licardlu/pangoriscv/evidence/records/validation_20261104/dataset_metrics_partial/sample_01.png

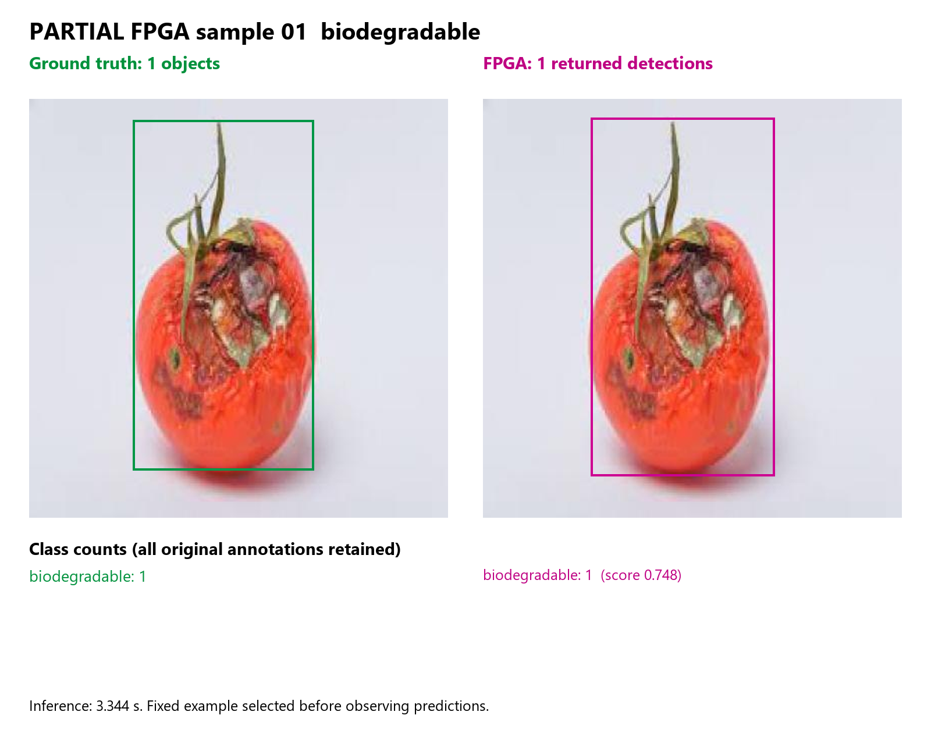
evidence/records/validation_20261104/dataset_metrics_partial/sample_01.png
