licardlu/pangoriscv/evidence/records/validation_20261104/dataset_metrics/sample_16.png

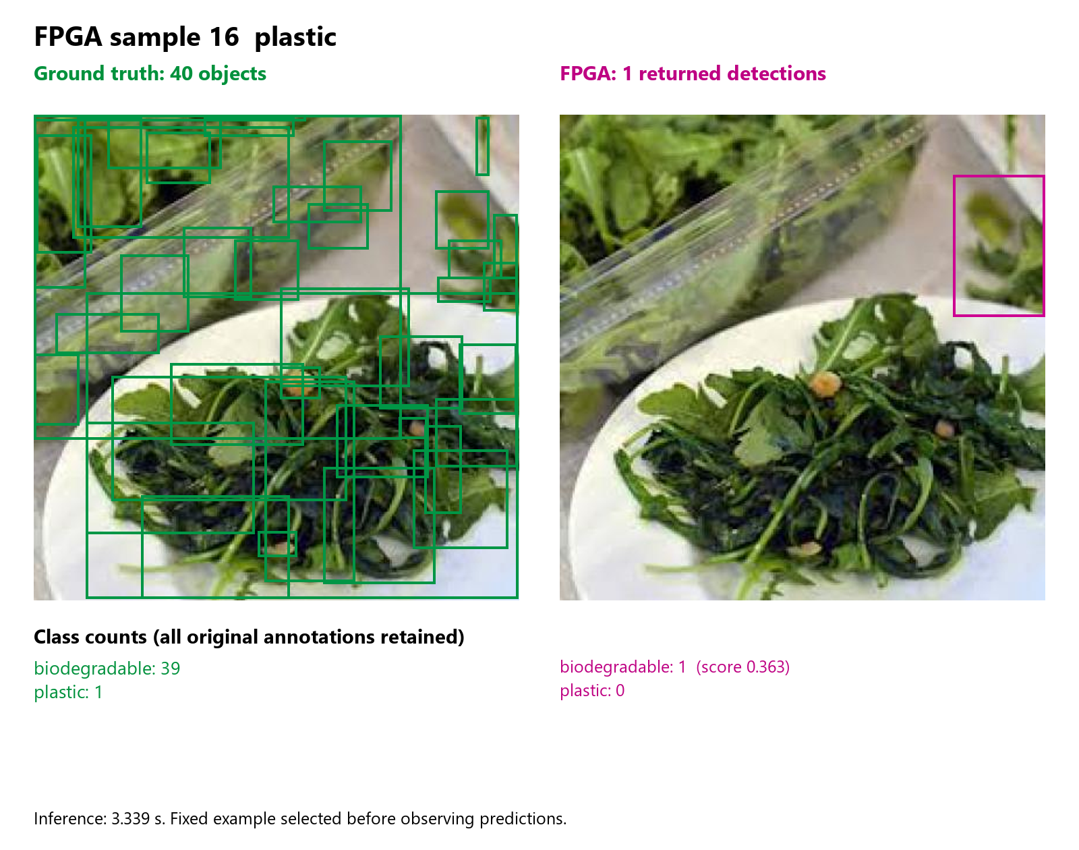
evidence/records/validation_20261104/dataset_metrics/sample_16.png
