licardlu/pangoriscv/extensions/yolo/README.md

# FPGA YOLO + CPU + AI Accelerator

## Current Board Status (2026-11-01)

- Target: MES2L676-100HP / PG2L100H; Vexii CPU and accelerator at 27 MHz.
- `release/board_perf4_20261101/`: programmed and tested. Model upload/CRC and
  camera inference replies pass; the latest camera request took 4.953 seconds.
- `release/board_perf5_20261101/`: newer optimized candidate. PDS timing and
  package verification pass; this candidate has not been board-tested.
- **HDMI remains blank on the user's monitor. Display acceptance has failed.**
  Neither release is a fully accepted contest deliverable.
- Model: YOLOv5n, 320 input, six classes: biodegradable, cardboard, glass,
  metal, paper, plastic. It has no hazardous-waste class.

## Files And Dependencies

- `rtl/`, `sw/`, `tb/`, `scripts/`: accelerator/SoC RTL, CPU firmware, tests,
  model export, quantization, packing, programming and board tools.
- `data/models/yolov5n-garbage.pt`: original selected checkpoint.
- `gen/integration/deployment/`: integer model parameters and graph contract.
- `gen/integration/packed/`: DDR model, memory map and generated C model table.
- `release/board_perf{4,5}_20261101/`: matched bitstream, firmware, model,
  constraints, timing evidence, checksums and standalone UART loader.
- `../project/pds_native_120/`: CPU checkout referenced by the Vexii generator.
- `../video/hdmi1080p/`: copied video source/IP/constraints; the camera generator
  prefers this repository copy over its historical absolute path.
- `pds/vexii_camera_20261101_{171914,181152}/sources/`: accepted source snapshots.
  Tool databases, downloaded datasets and installed Python packages are excluded.
- `STATUS.md`: results and limitations; T55 records the latest board state.

## 与其他目录的关系

**本目录是上游 AI 工程的快照，不是交付位流的源目录。** 阅读时请注意三点：

1. `extensions/yolo/rtl/`、`extensions/yolo/sw/` 是**上游候选件**，用来做可行性验证与
   离线仿真。真正被综合进 v3 交付位流的是
   `project/trash_sorting/source/yolo/sources/042_conv_band_rt.v` 与
   `project/trash_sorting/source/yolo/software/platform_main.c`（27 MHz 应用固件）。
2. `extensions/yolo/rtl/conv_band_rt.v` 与 `sources/042_conv_band_rt.v`
   **端口完全一致（37 个端口逐名相同），但时序不等价**：前者在 epilogue 阶段把
   quantize 拆成三级寄存器，多出 `S_EPI4 / S_EPI5 / S_EPI6` 三个状态
   （5'd20/21/22），每个输出通道因此多 3 个周期，且 requant 改为实例化
   `requant_q15` 模块；042 版在内联组合逻辑里一次算完，只有 `S_EPI3` 一个状态。
   两者功能预期相同、**逐周期行为不同**：拿本目录的 RTL 直接替换 042 会改变时延，
   并使历史仿真基线失效。**位流以 042 为准。**
3. `extensions/yolo/sw/platform_main.c` 与
   `project/trash_sorting/source/yolo/software/platform_main.c` **同名但不是一个程序**：
   前者 276 行，是 YAI1 静态图 bring-up + FP32 头 + `yolo_forward` 的仿真/候选固件；
   后者 324 行，是 27 MHz 板级应用固件（含 OSD 坐标换算与轮询上限）。
   板子上跑的是 `project/` 那一份，不要拿本目录的版本去解释板级行为。

`gen/integration/vexii_camera/`、`gen/integration/vexii_firmware/` 是 **93.461538 MHz**
的上游候选（`board_verified: false`），与 27 MHz v3 交付位流不是同一配置，见各自目录下的
`README.md`。

## Programming

> 本节沿用上游记录。**本快照没有 `release/`、`pds/`、`sim/`、`STATUS.md`**，
> 所以下面的 `package_release.py --verify --out release/...` 与 `pds/...` 路径在本包内
> 不可用；交付位流以仓库根 `README.md` 的交付章节与 `bitstream/` 为准，
> 这里只保留用于说明加载顺序。

Run from this directory with Python 3.11 and pyserial installed. First verify
`scripts/package_release.py --verify --out release/board_perf4_20261101`.
Start the PDS `cdt_js.exe` JTAG server on port 65420, then use
`scripts/program_board.py --sbit release/board_perf4_20261101/bitstream.sbit
--out sim/<unique-run>/program`.

After every FPGA/DDR reset, upload the model using
`scripts/board_loader.py --package-dir release/board_perf4_20261101 --port COM13`.
Then use the same command with `--skip-model --camera --frames 3` for camera
requests. Firmware is already embedded in the bitstream. The current video mode
is 1280x720@60, and the physical cable must use HDMI OUT.

外部工具路径不再写死在脚本里，按需用环境变量或命令行参数指定（见
`scripts/tool_paths.py`）：

| 工具 | 环境变量 | 命令行参数 | 默认值 |
|---|---|---|---|
| ModelSim `win64` | `MODELSIM_BIN` | `--modelsim` | `D:/modeltech64_10.6e/win64` |
| RISC-V GCC `bin` | `RISCV_GCC_BIN` | `--gcc` | 先查 `PATH`，再查 `C:/xpack-riscv-none-elf-gcc/bin` |
| PDS `bin` | `PDS_BIN` | `--pds` | `C:/pango/PDS_2022.2-SP6.1/bin` |
| CPU 源码 | `CPU_RTL` | `--cpu-rtl` | `../project/cpu120` |
| 视频模板 | `VIDEO_SRC` | `--video` | `../video/hdmi1080p` |

Model scripts also need NumPy, OpenCV, PyTorch, torchvision and the `yolov5`
checkpoint package. The standalone loader's dependencies are listed in each
release's `loader_requirements.txt`.

## Historical Workspace Notes

本目录只做赛题 AI 应用的小规模可行性验证，**独立于 `firmware/code`**：

- 不修改另一名 AI 正在处理的 CPU RTL、公共连接文件、`docs/` 下的正式文档；正式集成阶段才统一改公共文件。
- 下载串行进行，避免与另一 AI 争用下载工具；每个下载记录 URL、字节数、SHA256。
- 状态记录：本文件下方与 `STATUS.md`；错误写入 `logs/`；不建多份重复报告。
- 数据布局：`data/models/` 权重，`data/images/` 独立测试图片，`data/raw/` 原始包，`scripts/` 可复现脚本，`results/` 结果表与原始输出，`rtl/`、`tb/`、`sim/` 最小计算电路，`logs/` 运行日志。
- 数字标注：`实测`=本次运行/PDS 报告得到；`估计`=由实测或结构推算，不得写成已验证。

## 开始/完成/错误约定

| 状态 | 含义 | 记录位置 |
|---|---|---|
| RUNNING | 已开始、未完成 | `STATUS.md` 对应任务行 |
| DONE | 完成且有原始证据（日志/文件哈希/结果表） | `STATUS.md` + `results/` |
| FAILED | 失败，记录错误与下一步 | `STATUS.md` + `logs/` |

任务编号：T1 现成模型、T2 PC 对照、T3 YOLO-Fastest 逐层预算、T4 最小计算电路与 PDS、T5 固定图片 vs 摄像头边界、T6 集成约定。
