licardlu/pangoriscv/project/trash_sorting/资料包原始_00_请先阅读.md

# 青禾智能视觉垃圾分类：技术文档代码资料包

本包用于阅读关键代码、整理技术文档。包含完整的核心 RTL、板端 AI C 固件、模型描述及权重、外围 RTL、音频素材、测试代码、STM32 工程，以及两份按功能查找的说明。原始资料包里没有包含 PDS 安装程序、许可证、全量布局布线数据库、训练数据集和已生成位流；本次交付的仓库另含位流、时序报告与上板证据，以根目录 README 和 `docs/` 为准。

建议先读 [资料包原始_代码索引.md](资料包原始_代码索引.md)，再读 [资料包原始_技术文档编写要点.md](资料包原始_技术文档编写要点.md)；需要直接引用代码时看 [资料包原始_关键代码摘录.md](资料包原始_关键代码摘录.md)。文件来源与 SHA-256 见 `source/yolo/checksums.json` 与 `source/yolo/source_manifest.json`。

## 版本必须这样区分

原始包按 01~07 编号目录组织，本仓库已改放到下表位置；查文件时以本表为准。

| 原包目录 | 本仓库位置 | 用途与状态 |
| --- | --- | --- |
| 01_FPGA当前源码 | `source/yolo/`、`source/extensions/` | 打包时磁盘源码快照，保持 yolo / extensions 的相对目录结构；不是对当前板上全部源码的冻结复现 |
| 02_v4后续修改_未生成可烧录位流 | `variants/v4_source_only/` | 中文大字号标签、显示叠加层级及舵机统一方向等后续修改；没有可烧录 v4 位流，不得写为已上板验证 |
| 03_v3已烧录版本_局部源码与证据 | `variants/v3_programmed_reference/` | 最近真正烧录的 v3 顶层、视频前端、路由后时序报告和本次下载/推理记录；其余依赖当时未全量冻结，本目录不是完整重建包 |
| 04_AI模型处理与板端通信 | `../../extensions/yolo/scripts/` | 模型导出量化、打包、UART 协议与固件相关参考源码；实际 FPGA 编译输入优先看 `source/yolo/sources/` 的编号 RTL |
| 05_STM32舵机中继_当前工程快照 | `stm32_reference/` | 已有 Keil 工程的原样拷贝；本次只整理，未重新编译、未下载 STM32、未确认实板接线 |
| 07_历史参考 | 未随本次交付保留 | 原包中的历史修复记录与旧文档草稿未收录；引用旧版描述时以本包版本说明和实际代码为准 |

最近 FPGA 下载证据：`program: 1`、`JTAG_SCRIPT_DONE`；模型上传后板端 CRC 通过，两次摄像头推理响应均为空检测，随后已启动自主识别。这证明下载和推理通信流程完成，不证明识别准确率或舵机全部验收通过。SRAM 下载掉电失效，不等于开机自启动。烧录位流 SHA256 为 `2b98f90fbd0b4fd2de4074e74cb2c4aa8886d6009aa12bba4dfaf5d071bc4657`，见 `variants/v3_programmed_reference/最近重新烧录记录/result.json`。

## STM32 文档的冲突点，写技术文档时务必注意

STM32 当前文件仍标注蓝/灰/红/绿顺序，`SERVO_IN_MASK=0x0`、`SERVO_OUT_MASK=0xD`。而刚烧录的 v3 顶层明确为绿/红/灰/蓝物理顺序，`SERVO_REVERSED_MASK=4'b0101`。两者不能直接作为同一套已集成接线说明使用。这里保留原文件供解释中继原理，未擅自修改工程，也没有把它标为已经配套验收。

用户要求的后续目标是 STM32 各输出上电 0°，收到开盖命令后到 90°，保持 5 秒再到 0°，周期 20 ms。当前 STM32 源码还包含约 1 秒渐变以及输出反向掩码，不能将“目标”写成“当前四路已统一实现并验证”。

## 查看与发送

交付压缩包为 `pangoriscv_完整源码.rar`（RAR5 格式，34,065,293 字节），可作为文件发送；无需运行 PDS 或 Keil 才能查看源码。解压后用 VS Code、记事本或 Keil 阅读。包内 Tcl / Python 保留原始路径，有些指向作者电脑；这是技术文档资料包，没有在朋友电脑上验证一键构建。
