licardlu/pangoriscv/project/trash_sorting/资料包原始_代码索引.md

# 关键代码索引

行号对应本目录内文件。原资料包按 `01_FPGA当前源码`、`02_v4后续修改…`、`03_v3已烧录版本…` 等目录组织；在本仓库中已改放到 `source/`、`variants/v4_source_only/`、`variants/v3_programmed_reference/`，下表链接已换成当前位置。

| 功能 | 文件与入口行号 | 用途 |
| --- | --- | --- |
| 系统总连接与时钟复位 | [052_yolo_camera_top_camera_servo.v](variants/v3_programmed_reference/052_yolo_camera_top_camera_servo.v)：26 行 | 当前烧录版本的完整摄像头、AI、HDMI、按键、语音、舵机连接。 |
| 后续完整版连接与显示叠加 | [052_yolo_camera_top_camera_servo.v](variants/v4_source_only/052_yolo_camera_top_camera_servo.v)：753 行 | 对照 v3 查看后续修改；尚未上板。 |
| RISC-V 处理器核心 | [015_pango_replica_core.v](source/yolo/sources/015_pango_replica_core.v)：1 行 | 处理器 RTL；说明 CPU 如何执行推理控制与解码固件。 |
| CPU 与 AI 的 SoC 总线 | [040_vexii_ai_soc.v](source/yolo/sources/040_vexii_ai_soc.v)：6 行 | CPU、总线、UART 及加速器寄存器连接。 |
| 卷积加速计算 | [042_conv_band_rt.v](source/yolo/sources/042_conv_band_rt.v)：28 行 | 卷积数据流、带状处理与计算调度。 |
| 乘加阵列 | [043_mac_array.v](source/yolo/sources/043_mac_array.v)：16 行 | 并行乘法累加结构，是 FPGA AI 加速关键。 |
| 加速器寄存器接口 | [044_conv_engine_axil.v](source/yolo/sources/044_conv_engine_axil.v)：17 行 | CPU 写参数、启动运算、读取状态。 |
| DDR 与时钟域桥接 | [045_ddr_axi_bridge.v](source/yolo/sources/045_ddr_axi_bridge.v)：5 行 | 推理数据与外部内存连接；046/047 是相关 CDC。 |
| 摄像头帧捕获 | [048_camera_snapshot.v](source/yolo/sources/048_camera_snapshot.v)：4 行 | 把摄像头画面送入推理链路。 |
| 原生视频与检测框 | [049_video_ai_frontend_camera_repair.v](variants/v3_programmed_reference/049_video_ai_frontend_camera_repair.v)：4 行 | 当前上板版本的 OSD、结果保存与显示。 |
| 中文标签与顶层显示优先级修改 | [049_video_ai_frontend_camera_repair.v](variants/v4_source_only/049_video_ai_frontend_camera_repair.v)：393 行 | 24 像素中文类别标签、背景与边界处理；未生成位流。 |
| AI 客户端与外设结果通路 | [051_yolo_ai_client.v](source/yolo/sources/051_yolo_ai_client.v)：2 行 | 控制通信和 AI 结果访问；与固件协作。 |
| 固件主流程与板端命令 | [platform_main.c](source/yolo/software/platform_main.c)：234 行 | 模型上传校验、摄像头推理和自主运行命令入口。 |
| 网络算子运行时 | [yolo_runtime.c](source/yolo/software/yolo_runtime.c)：12 行 | CPU 调度硬件算子、数据布局和后处理辅助。 |
| 检测框解码 | [yolo_decode.c](source/yolo/software/yolo_decode.c)：5 行 | 检测头解码、置信度筛选及 NMS 等，具体实现以文件为准。 |
| 六类物体到垃圾桶映射 | [yolo_class_to_bin.v](source/extensions/business/application/rtl/yolo_class_to_bin.v)：7 行 | class0→厨余；class1~5→可回收，未训练有害/其他。 |
| 按键消抖 | [key_debounce4.sv](source/extensions/business/application/rtl/key_debounce4.sv)：2 行 | 机械按键同步、消抖与单次事件。 |
| 答题流程状态机 | [trash_quiz_controller.sv](source/extensions/business/application/rtl/trash_quiz_controller.sv)：48 行 | 识别后提问，按键比对；答错仍开正确桶，播放对应语音。 |
| 外围总装 | [trash_peripherals.sv](source/extensions/business/application/rtl/trash_peripherals.sv)：2 行 | 按键、答题、舵机触发与状态快照。 |
| 四路舵机 PWM | [servo_pwm4.sv](source/extensions/business/application/rtl/servo_pwm4.sv)：20 行 | 50 Hz，500/1500 us，250 帧保持；实例参数决定反向。 |
| 提示/正确/错误语音 ROM | [trash_voice_rom_player.v](source/extensions/business/application/rtl/trash_voice_rom_player.v)：5 行 | PCM ROM 读出、事件播放和状态。 |
| I2S 音频输出 | [trash_i2s_tx.v](source/extensions/business/application/rtl/trash_i2s_tx.v)：6 行 | PCM 串行化成 BCLK/LRCLK/DATA。 |
| HDMI 音频芯片配置 | [ms7210_audio_init.v](source/extensions/business/application/rtl/ms7210_audio_init.v)：17 行 | 通过寄存器初始化音频通道。 |
| 白色标题栏与实时视频合成 | [light_split_video.sv](source/extensions/business/application/rtl/light_split_video.sv)：5 行 | 标题区域、视频以及叠加图层组合；配合 ui_light_panel。 |
| 物理引脚约束 | [camera.fdc](source/yolo/sources/camera.fdc)：1029 行 | 板级 IO 球号和电平标准；J3 排针还需实际转接板对应。 |
| UART 模型上传与控制协议 | [board_loader.py](../../extensions/yolo/scripts/board_loader.py)：49 行 | YAI1 请求、YAR1 响应、CRC 和模型传输。 |
| 模型打包 | [pack_deployment.py](../../extensions/yolo/scripts/pack_deployment.py)：18 行 | 模型与内存地址信息生成，配合 memory_map.json。 |
| STM32 四路中继 | [main.c](stm32_reference/Core/Src/main.c)：253 行 | 采样 FPGA PWM 并由 TIM2 四通道重生 PWM；现有掩码/颜色与 v3 有冲突，见总说明。 |
