licardlu/pangoriscv/project/trash_sorting/资料包原始_关键代码摘录.md

# 关键代码摘录

以下为原文件片段，便于技术文档引用。代码未作改写；完整上下文见对应文件，实际验证边界见 `资料包原始_00_请先阅读.md`。

## 系统总连接与时钟复位

文件：`variants/v3_programmed_reference/052_yolo_camera_top_camera_servo.v`，第 24–47 行。当前烧录版本的完整摄像头、AI、HDMI、按键、语音、舵机连接。

```verilog
`define CMOS_2      //cmos2作为视频输入；

module yolo_camera_top#(
	parameter PERIPHERAL_TEST_MODE = 0          ,//0=live camera quiz; 1=fixed answer1 diagnostics
	parameter MEM_ROW_ADDR_WIDTH   = 15         ,
	parameter MEM_COL_ADDR_WIDTH   = 10         ,
	parameter MEM_BADDR_WIDTH      = 3          ,
	parameter MEM_DQ_WIDTH         =  32        ,
	parameter MEM_DQS_WIDTH        =  32/8
)(
	input wire uart_rxd,
	input                                sys_clk              ,//27MHz
    input                                clk_p ,
    input                                clk_n ,
//OV5640
    output  [1:0]                        cmos_init_done       ,//OV5640寄存器初始化完成
    //coms1	
    inout                                cmos1_scl            ,//cmos1 i2c 
    inout                                cmos1_sda            ,//cmos1 i2c 
    input                                cmos1_vsync          ,//cmos1 vsync
    input                                cmos1_href           ,//cmos1 hsync refrence,data valid
    input                                cmos1_pclk           ,//cmos1 pxiel clock
    input   [7:0]                        cmos1_data           ,//cmos1 data
    output                               cmos1_reset          ,//cmos1 reset
```

## 后续完整版连接与显示叠加

文件：`variants/v4_source_only/052_yolo_camera_top_camera_servo.v`，第 751–774 行。对照 v3 查看后续修改；尚未上板。

```verilog
    // User order: key/bin 1 green, 2 red, 3 gray, 4 blue.
    // Physical [0..3]: U16 green, U15 red, AC26 gray, AB26 blue.
    assign servo_pwm = logical_servo_pwm;
    wire peripheral_voice_valid;
    wire [2:0] peripheral_voice_asset;
    wire raw_result_commit,raw_result_valid;
    wire [7:0] raw_result_class_id;
    wire [3:0] raw_result_count;
    wire camera_bin_valid;
    wire [2:0] camera_bin_code;
    wire audio_busy,audio_playback_done;
    yolo_class_to_bin camera_category(
        .result_valid(raw_result_valid),.result_class_id(raw_result_class_id),
        .bin_valid(camera_bin_valid),.bin_code(camera_bin_code));
    trash_peripherals #(.CLK_HZ(27000000),.DEBOUNCE_MS(20),.OPEN_MS(5000),
        .TEST_MODE(PERIPHERAL_TEST_MODE),.SERVO_REVERSED_MASK(4'b0000)) application_peripherals(
        .clk(sys_clk),.rst(!peripheral_reset[1]),.start_ready(hdmi_ready_sync[1]),.key_n(key_n),
        .detect_event(raw_result_commit),.bin_valid(camera_bin_valid),.bin_code(camera_bin_code),
        .servo_pwm(logical_servo_pwm),.open_state(servo_open_state),
        .voice_valid(peripheral_voice_valid),.voice_asset_id(peripheral_voice_asset),
        .snapshot(application_snapshot));
    trash_voice_i2s #(.CLK_HZ(27000000)) application_voice(
        .clk(sys_clk),.rst(!peripheral_reset[1]),
        .request_valid(peripheral_voice_valid),.request_asset_id(peripheral_voice_asset),
```

## RISC-V 处理器核心

文件：`source/yolo/sources/015_pango_replica_core.v`，第 1–22 行。处理器 RTL；说明 CPU 如何执行推理控制与解码固件。

```verilog
// Source-extraction compilation-unit preamble (not reference payload).
`timescale 1ns/1ps
`include "sections/000_FetchL1Plugin.vh"
`include "sections/001_FetchL1Plugin.vh"
`include "sections/002_DispatchPlugin.vh"
`include "sections/003_LsuL1Plugin.vh"
`include "sections/004_CsrAccessPlugin.vh"
`include "sections/005_PerformanceCounterPlugin.vh"
`include "sections/006_execute_pipeline.vh"
`include "sections/007_PrefetcherRptPlugin.vh"
`include "sections/008_execute_pipeline.vh"
`include "sections/009_PrefetcherRptPlugin.vh"
`include "sections/010_FetchL1Plugin.vh"
`include "sections/011_AlignerPlugin.vh"
`include "sections/012_AlignerPlugin.vh"
`include "sections/013_DispatchPlugin.vh"
`include "sections/014_DispatchPlugin.vh"
`include "sections/015_LsuL1Plugin.vh"
`include "sections/016_LsuL1Plugin.vh"
`include "sections/017_LsuPlugin.vh"
`include "sections/018_WhiteboxerPlugin.vh"
`include "sections/019_AlignerPlugin.vh"
```

## CPU 与 AI 的 SoC 总线

文件：`source/yolo/sources/040_vexii_ai_soc.v`，第 4–27 行。CPU、总线、UART 及加速器寄存器连接。

```verilog
`timescale 1ns/1ps

module vexii_ai_soc (
  input  wire          socCtrl_systemClk,
  input  wire          socCtrl_asyncReset,
  output wire          system_peripheral_uart_logic_uart_txd,
  input  wire          system_peripheral_uart_logic_uart_rxd,
  output wire [7:0]    system_peripheral_demo_logic_leds,
  input  wire [0:0]    system_peripheral_demo_logic_buttons,
  output wire [31:0] ai_awaddr, ai_wdata, ai_araddr,
  output wire [3:0] ai_wstrb,
  output wire ai_awvalid, ai_wvalid, ai_arvalid, ai_bready, ai_rready,
  input wire ai_awready, ai_wready, ai_arready, ai_bvalid, ai_rvalid,
  input wire [1:0] ai_bresp, ai_rresp,
  input wire [31:0] ai_rdata,
  output wire ai_resetn

);

  wire ai_hit;
  reg peripheral_pending, peripheral_ai;
  wire ai_tl_ready, ai_tl_valid, ai_tl_denied, ai_tl_corrupt;
  wire [2:0] ai_tl_opcode;
  wire [5:0] ai_tl_source;
```

## 卷积加速计算

文件：`source/yolo/sources/042_conv_band_rt.v`，第 26–49 行。卷积数据流、带状处理与计算调度。

```verilog
`timescale 1ns/1ps

module conv_band_rt #(
    parameter integer BANDW = 7168,    // band buffer, 64-bit words (56 KiB)
    parameter integer WBANK = 576,      // words per weight bank (K*K*CSL max)
    parameter integer TRM   = 8
)(
    input  wire        clk,
    input  wire        rstn,
    input  wire        start,
    output reg         busy,
    output reg         done,
    output reg         err,
    output reg  [31:0] cycles,

    input  wire [15:0] p_cin,       // channels actually present (multiple of 8)
    input  wire [15:0] p_cout,
    input  wire [15:0] p_in_w,
    input  wire [15:0] p_in_h,
    input  wire [15:0] p_out_w,
    input  wire [15:0] p_out_h,
    input  wire [7:0]  p_k,
    input  wire [7:0]  p_stride,
    input  wire [7:0]  p_pad,
```

## 乘加阵列

文件：`source/yolo/sources/043_mac_array.v`，第 14–37 行。并行乘法累加结构，是 FPGA AI 加速关键。

```verilog
`timescale 1ns/1ps

module mac_array #(
    parameter integer L = 8,        // activation lanes = taps consumed per cycle
    parameter integer C = 8         // output channels computed in parallel
)(
    input  wire                clk,
    input  wire                rstn,

    input  wire                clear,      // synchronous: load bias, zero the rest
    input  wire                valid,      // one K-slice this cycle
    input  wire [C*32-1:0]     bias_bus,   // per output channel, int32
    input  wire [L*8-1:0]      a_bus,      // L int8 activations
    input  wire [C*L*8-1:0]    w_bus,      // C x L int8 weights

    output wire [C*32-1:0]     sum_bus     // C int32 partial sums (combinational)
);

    // Flat storage: element (oc, lane) lives at oc*L + lane.  Declared at module
    // scope because PDS rejects declarations inside procedural blocks
    // (Verilog-4109) and flat indexing keeps the generate blocks trivial.
    reg signed [31:0] acc [0:C*L-1];

    genvar go, gl;
```

## 加速器寄存器接口

文件：`source/yolo/sources/044_conv_engine_axil.v`，第 15–38 行。CPU 写参数、启动运算、读取状态。

```verilog
`timescale 1ns/1ps

module conv_engine_axil #(
    parameter integer BANDW = 7168,    // band buffer, 64-bit words (56 KiB)
    parameter integer WBANK = 576,      // words per weight bank
    parameter integer TRM   = 8
)(
    input  wire        clk,
    input  wire        rstn,
    output reg         vid_wr_en,
    output reg [7:0]   vid_wr_addr,
    output reg [31:0]  vid_wr_data,
    output wire [7:0]  vid_rd_addr,
    input wire [31:0]  vid_rd_data,

    // ---- AXI4-Lite slave: control / status ----
    input  wire [7:0]  s_awaddr,
    input  wire        s_awvalid,
    output wire        s_awready,
    input  wire [31:0] s_wdata,
    input  wire        s_wvalid,
    output wire        s_wready,
    output wire [1:0]  s_bresp,
    output wire        s_bvalid,
```

## DDR 与时钟域桥接

文件：`source/yolo/sources/045_ddr_axi_bridge.v`，第 3–26 行。推理数据与外部内存连接；046/047 是相关 CDC。

```verilog
// The word-address convention is configurable and still requires board BIST.
`timescale 1ns/1ps
module ddr_axi_bridge #(
    parameter integer DDR_ADDR_SHIFT = 2
) (
    input wire clk, rstn,
    input wire [31:0] s_awaddr,
    input wire s_awvalid,
    output wire s_awready,
    input wire [63:0] s_wdata,
    input wire [7:0] s_wstrb,
    input wire s_wvalid,
    output wire s_wready,
    output reg [1:0] s_bresp,
    output reg s_bvalid,
    input wire s_bready,
    input wire [31:0] s_araddr,
    input wire s_arvalid,
    output wire s_arready,
    output reg [63:0] s_rdata,
    output reg [1:0] s_rresp,
    output reg s_rvalid,
    input wire s_rready,
    output reg [27:0] m_awaddr,
```

## 摄像头帧捕获

文件：`source/yolo/sources/048_camera_snapshot.v`，第 2–25 行。把摄像头画面送入推理链路。

```verilog
// until it requests another frame. Both RAM ports have synchronous reads/writes.
`timescale 1ns/1ps
module camera_snapshot #(
    parameter integer IN_W=1280, IN_H=720, STEP=4,
    parameter integer OUT_W=IN_W/STEP, OUT_H=IN_H/STEP
) (
    input wire cpu_clk,cpu_rstn,request,
    input wire [15:0] read_address,
    output reg [15:0] read_data,
    output reg busy,ready,error,
    output reg [15:0] frame_id,
    input wire cam_clk,cam_rstn,vsync,de,
    input wire [15:0] pixel
);
    reg [15:0] memory[0:OUT_W*OUT_H-1];
    reg req_toggle,done_toggle;
    reg [1:0] req_sync,done_sync;
    reg done_seen,req_seen,pending,active,vs_d,de_d,cam_error;
    reg [15:0] x,y,write_index,frame_counter,frozen_id;
    wire frame_start=vs_d && !vsync;
    always @(posedge cpu_clk) begin
        if(read_address<OUT_W*OUT_H) read_data<=memory[read_address];
        else read_data<=0;
        if(!cpu_rstn) begin
```

## 原生视频与检测框

文件：`variants/v3_programmed_reference/049_video_ai_frontend_camera_repair.v`，第 2–25 行。当前上板版本的 OSD、结果保存与显示。

```verilog
// stable across CDC until the pixel domain acknowledges it.
`timescale 1ns/1ps
module video_ai_frontend #(
    // Number of display frames for which the last detection remains visible
    // after the first explicitly empty inference. Slow inference alone must
    // not erase a valid result. The board wrapper sets a frame-rate-specific
    // TTL: 60 frames at 30 Hz, or 120 frames at 60 Hz, gives two seconds.
    parameter integer RESULT_TTL=60,
    // Keep text enabled for the reusable frontend and unit-test contract.
    // Board-level generators may explicitly disable it on timing-sensitive
    // pixel paths.
    parameter integer OSD_TEXT=1,
    parameter integer OSD_BORDER=4,
    // Optional debug capture guide. Keep it disabled in normal operation so
    // expiry removes every rectangle rather than showing a false detection.
    parameter integer GUIDE_ENABLE=0,
    // Centered 320x320 capture guide for the no-detection state. These
    // defaults match the 1280x720 HDMI raster and can be overridden by a
    // board-level wrapper without changing the MMIO protocol.
    parameter integer GUIDE_X1=480,
    parameter integer GUIDE_Y1=200,
    parameter integer GUIDE_X2=799,
    parameter integer GUIDE_Y2=519,
    // Visible source range after an optional downstream center crop. A box
```

## 中文标签与顶层显示优先级修改

文件：`variants/v4_source_only/049_video_ai_frontend_camera_repair.v`，第 391–414 行。24 像素中文类别标签、背景与边界处理；未生成位流。

```verilog
    reg [3:0] glyph_id;
    reg [11:0] glyph_bits;
    localparam integer LABEL_SCALE=2;
    localparam integer LABEL_PAD=4;
    localparam integer LABEL_HEIGHT=32;
    always @(*) begin
        pix_out=pix_in;
        detection_valid=0;
        draw_top=0;label_x=0;label_y=0;label_w=0;label_len=0;
        label_dx=0;label_dy=0;label_col=0;label_row=0;label_index=0;
        category_kind=0;glyph_id=0;glyph_bits=0;
        for(b=0;b<8;b=b+1) begin
            draw_top=box_xy1[b][31:16];
            if(box_class[b][31] && box_xy2[b][15:0]>=VIEW_X1 &&
               box_xy1[b][15:0]<=VIEW_X2) detection_valid=1;
            // The opaque UI header owns rows [0, HEADER_HEIGHT). Clip a
            // detection's visible top edge to the live-video area below it.
            if(pix_de && box_class[b][31] &&
               x>=box_xy1[b][15:0] && x<=box_xy2[b][15:0] &&
               y>=box_xy1[b][31:16] && y<=box_xy2[b][31:16]) begin
                if(x<box_xy1[b][15:0]+OSD_BORDER ||
                   x+OSD_BORDER>box_xy2[b][15:0] ||
                   y<box_xy1[b][31:16]+OSD_BORDER || y+OSD_BORDER>box_xy2[b][31:16])
                    pix_out=class_color(box_class[b][2:0]);
```

## AI 客户端与外设结果通路

文件：`source/yolo/sources/051_yolo_ai_client.v`，第 1–23 行。控制通信和 AI 结果访问；与固件协作。

```verilog
// Generated client: CPU clock is supplied by the integration top.
module yolo_ai_client #(
    parameter PROGRAM_INIT_FILE="",DATA_INIT_FILE=""
) (
    input wire clk_sys,core_clk,rstn,ddr_rstn,uart_rxd,
    output wire uart_txd,vid_wr_en,
    output wire [7:0] vid_wr_addr,vid_rd_addr,
    output wire [31:0] vid_wr_data,
    input wire [31:0] vid_rd_data,
    output wire [27:0] d3_awaddr,d3_araddr,
    output wire [3:0] d3_awlen,d3_arlen,
    output wire d3_awvalid,d3_arvalid,
    input wire d3_awready,d3_arready,
    output wire [255:0] d3_wdata,
    output wire [31:0] d3_wstrb,
    output wire d3_wvalid,d3_rready,
    input wire d3_wready,d3_wusero_last,d3_rvalid,d3_rlast,
    input wire [255:0] d3_rdata
);
    // ---- accelerator DDR path, all in clk_sys ------------------------------
    wire [31:0]  acc_araddr, acc_awaddr;
    wire         acc_arvalid, acc_awvalid;
    wire         acc_arready, acc_awready;
```

## 固件主流程与板端命令

文件：`source/yolo/software/platform_main.c`，第 232–255 行。模型上传校验、摄像头推理和自主运行命令入口。

```c
    return status;
}
int main(void)
{
    unsigned char header[16],payload[256];
    uint32_t limit=POLL_LIMIT;
    yolo_io_t io={
        .context=&limit,.read64=yolo_acc_read,.write64=yolo_acc_write,
        .convolve=yolo_acc_convolve,.read_bulk=yolo_acc_read_bulk,
        .write_bulk=yolo_acc_write_bulk
    };
#ifdef VEXII_PLATFORM
    UART[2]=CPU_HZ/(115200u*8u)-1u;
    UART[3]=7;
#else
    UART[2]=(CPU_HZ+57600u)/115200u-1u;
    UART[0]=3;
#endif
#ifdef VEXII_SIM_PRELOAD
    model_verified=1;
    input_loaded=320u*320u*8u;
#endif
    for(;;) {
        uint32_t i,address,expected,crc;
```

## 网络算子运行时

文件：`source/yolo/software/yolo_runtime.c`，第 10–33 行。CPU 调度硬件算子、数据布局和后处理辅助。

```c
#if defined(VEXII_PLATFORM) || !defined(__riscv)
#define YOLO_CACHED_RUNTIME 1
static union {
    int32_t head_q24[8][256];
    int16_t head_q16[4096];
    int8_t pool[5][1536];
    unsigned char scale_lut[4][256];
    struct {
        int32_t whole[2][256];
        uint32_t fraction[2][256];
    } add;
} scratch;
static int8_t head_input[256];
#endif

static int8_t clip(int64_t v)
{
    return v > 127 ? 127 : v < -128 ? -128 : (int8_t)v;
}

static int64_t rounded_q24(int64_t v)
{
    uint64_t magnitude = v < 0 ? (uint64_t)(-v) : (uint64_t)v;
    int64_t result = (int64_t)((magnitude + (1u << 23)) >> 24);
```

## 检测框解码

文件：`source/yolo/software/yolo_decode.c`，第 3–26 行。检测头解码、置信度筛选及 NMS 等，具体实现以文件为准。

```c
#include <string.h>

static float sigmoid(float x)
{
    if(x>=16) return 1;
    if(x<=-16) return 0;
    return 1.0f/(1.0f+expf(-x));
}
static float overlap(const yolo_box_t *a,const yolo_box_t *b)
{
    float x1=fmaxf(a->x1,b->x1),y1=fmaxf(a->y1,b->y1);
    float x2=fminf(a->x2,b->x2),y2=fminf(a->y2,b->y2);
    float area=fmaxf(0,x2-x1)*fmaxf(0,y2-y1);
    float total=(a->x2-a->x1)*(a->y2-a->y1)+(b->x2-b->x1)*(b->y2-b->y1)-area;
    return total>0 ? area/total : 0;
}
static void insert(yolo_box_t *list,uint16_t *count,uint32_t capacity,yolo_box_t box)
{
    uint32_t at=*count;
    if(at==capacity) {
        if(box.score<=list[at-1].score) return;
        at--;
    } else (*count)++;
    while(at && box.score>list[at-1].score) {
```

## 六类物体到垃圾桶映射

文件：`source/extensions/business/application/rtl/yolo_class_to_bin.v`，第 5–28 行。class0→厨余；class1~5→可回收，未训练有害/其他。

```verilog
// Keep this module independent of key/servo testing. Configure the six
// parameters only when the deployed label policy or model has been checked.
module yolo_class_to_bin #(
    parameter [2:0] CLASS0_BIN=3'd1,
    parameter [2:0] CLASS1_BIN=3'd4,
    parameter [2:0] CLASS2_BIN=3'd4,
    parameter [2:0] CLASS3_BIN=3'd4,
    parameter [2:0] CLASS4_BIN=3'd4,
    parameter [2:0] CLASS5_BIN=3'd4
)(
    input wire result_valid,
    input wire [7:0] result_class_id,
    output reg bin_valid,
    output reg [2:0] bin_code
);
    reg [2:0] configured_bin;
    always @(*) begin
        case(result_class_id)
            8'd0:configured_bin=CLASS0_BIN;
            8'd1:configured_bin=CLASS1_BIN;
            8'd2:configured_bin=CLASS2_BIN;
            8'd3:configured_bin=CLASS3_BIN;
            8'd4:configured_bin=CLASS4_BIN;
            8'd5:configured_bin=CLASS5_BIN;
```

## 按键消抖

文件：`source/extensions/business/application/rtl/key_debounce4.sv`，第 1–23 行。机械按键同步、消抖与单次事件。

```verilog
// Four active-low asynchronous buttons. Each stable press generates one pulse.
module key_debounce4 #(
    parameter integer CLK_HZ = 50000000,
    parameter integer DEBOUNCE_MS = 20
)(
    input logic clk, rst,
    input logic [3:0] key_n,
    output logic [3:0] key_event
);
    // Split the multiply so 120 MHz * 20 ms cannot overflow a signed integer.
    localparam integer CYCLES = (CLK_HZ / 1000) * DEBOUNCE_MS +
        (((CLK_HZ % 1000) * DEBOUNCE_MS + 999) / 1000);
    localparam integer CW = (CYCLES < 2) ? 1 : $clog2(CYCLES + 1);
    (* ASYNC_REG="TRUE" *) logic [3:0] key_meta, key_sync;
    logic [3:0] pressed;
    logic [CW-1:0] count[0:3];
    integer i;
    always_ff @(posedge clk) begin
        if(rst) begin
            key_meta <= 4'hf; key_sync <= 4'hf; pressed <= 0; key_event <= 0;
            for(i=0;i<4;i=i+1) count[i] <= 0;
        end else begin
            key_meta <= key_n; key_sync <= key_meta; key_event <= 0;
```

## 答题流程状态机

文件：`source/extensions/business/application/rtl/trash_quiz_controller.sv`，第 46–69 行。识别后提问，按键比对；答错仍开正确桶，播放对应语音。

```verilog
            end
            if(start_ready && !startup) case(state)
                IDLE: if(detect_event && bin_valid && bin_code>=1 && bin_code<=4) begin
                    correct<=bin_code-1'b1; state<=WAIT_ANSWER;
                    voice_valid<=1; voice_asset_id<=1;
                end
                WAIT_ANSWER: if(|key_event) begin
                    choice<=key_index; state<=ANSWERED;
                    // Always open the correct bin, including on wrong answers.
                    // Direct four-channel diagnostics use servo_key_controller.
                    servo_trigger<=4'b0001<<correct;
                    voice_valid<=1;
                    voice_asset_id<=(key_index==correct)?3'd2:3'd3;
                    opened_seen<=0;
                end
                ANSWERED: begin
                    if(|servo_open_state) opened_seen<=1;
                    // Use feedback, not a second independent 5s timer. PWM
                    // opens on its next 20ms boundary; a parallel timer could
                    // otherwise repeat the prompt before the lid has closed.
                    if(opened_seen && !(|servo_open_state)) begin
                        opened_seen<=0;
                        if(TEST_MODE) begin
                            state<=WAIT_ANSWER;correct<=0;
```

## 外围总装

文件：`source/extensions/business/application/rtl/trash_peripherals.sv`，第 1–23 行。按键、答题、舵机触发与状态快照。

```verilog
// Camera-driven quiz peripherals; TEST_MODE=1 enables standalone diagnostics.
module trash_peripherals #(
    parameter integer CLK_HZ=50000000,
    parameter integer DEBOUNCE_MS=20,
    parameter integer OPEN_MS=5000,
    parameter integer TEST_MODE=0,
    parameter logic [3:0] SERVO_REVERSED_MASK=4'b0000
)(
    input wire clk,rst,start_ready,
    input wire [3:0] key_n,
    input wire detect_event,bin_valid,
    input wire [2:0] bin_code,
    output wire [3:0] servo_pwm,open_state,
    output wire voice_valid,
    output wire [2:0] voice_asset_id,
    output wire [127:0] snapshot
);
    wire [3:0] key_event,servo_trigger;
    key_debounce4 #(.CLK_HZ(CLK_HZ),.DEBOUNCE_MS(DEBOUNCE_MS)) buttons(
        .clk(clk),.rst(rst),.key_n(key_n),.key_event(key_event));
    trash_quiz_controller #(.TEST_MODE(TEST_MODE)) control(
        .clk(clk),.rst(rst),.start_ready(start_ready),.key_event(key_event),
        .servo_open_state(open_state),.detect_event(detect_event),
```

## 四路舵机 PWM

文件：`source/extensions/business/application/rtl/servo_pwm4.sv`，第 18–41 行。50 Hz，500/1500 us，250 帧保持；实例参数决定反向。

```verilog
    output logic [3:0] open_state
);
    localparam integer PERIOD = CLK_HZ / 50;
    localparam integer PULSE_0 = CLK_HZ / 2000; // 0.5 ms
    localparam integer PULSE_90 = (CLK_HZ * 3) / 2000; // 1.5 ms
    localparam integer CW = (PERIOD < 2) ? 1 : $clog2(PERIOD);
    localparam integer FW = (OPEN_FRAMES < 2) ? 1 : $clog2(OPEN_FRAMES + 1);
    logic [CW-1:0] period_count;
    logic [FW-1:0] remaining [0:3];
    logic [3:0] trigger_d;
    logic [3:0] trigger_pending;
    integer i;

    always_ff @(posedge clk) begin
        if (rst) begin
            period_count <= '0;
            trigger_d <= '0;
            trigger_pending <= '0;
            pwm <= '0;
            open_state <= '0;
            for (i = 0; i < 4; i = i + 1) remaining[i] <= '0;
        end else begin
            trigger_d <= trigger;
            for (i = 0; i < 4; i = i + 1)
```

## 提示/正确/错误语音 ROM

文件：`source/extensions/business/application/rtl/trash_voice_rom_player.v`，第 3–26 行。PCM ROM 读出、事件播放和状态。

```verilog
// the pending stream; an invalid request is ignored.  ready consumes one
// 48-kHz mono sample (each stored 16-kHz PCM8 sample repeats three times).
module trash_voice_rom_player #(
    parameter ROM_FILE = "../../extensions/business/application/assets/audio_rom/voice_pcm8.hex",
    parameter integer ROM_SAMPLES = 115576,
    parameter integer PROMPT_START = 0,      PROMPT_LENGTH = 37192,
    parameter integer CORRECT_START = 37192, CORRECT_LENGTH = 40392,
    parameter integer WRONG_START = 77584,   WRONG_LENGTH = 37992
)(
    input wire clk, rst,
    input wire request_valid,
    input wire [2:0] request_asset_id,
    input wire sample_ready,
    output wire sample_valid,
    output wire [15:0] sample_pcm,
    output wire sample_last,
    output reg busy
);
    // Keep each inferred memory within one native 18K block. A single deep
    // ROM can infer cascaded DRM36K pairs whose identical lower halves PDS
    // merges, creating illegal COUTA fanout. Explicit banks use a fabric mux
    // and cannot require those dedicated cascade connections.
    localparam integer BANK_AW = 11;
    localparam integer BANK_SIZE = 1 << BANK_AW;
```

## I2S 音频输出

文件：`source/extensions/business/application/rtl/trash_i2s_tx.v`，第 4–27 行。PCM 串行化成 BCLK/LRCLK/DATA。

```verilog
// default).  Edge quantization is <= one sys_clk period.  For a codec that
// requires low-jitter MCLK, use an audio PLL instead of this CE clock source.
module trash_i2s_tx #(
    parameter integer CLK_HZ = 50000000,
    parameter integer SAMPLE_HZ = 48000
)(
    input wire clk, rst,
    input wire sample_valid,
    input wire [15:0] sample_pcm,
    input wire sample_last,
    output wire sample_ready,
    output reg bclk, lrclk, sdout,
    output reg frame_active,
    output reg playback_done
);
    localparam integer EDGE_HZ = SAMPLE_HZ * 128;
    reg [31:0] phase;
    wire [32:0] phase_sum = {1'b0, phase} + EDGE_HZ;
    wire edge_tick = phase_sum >= CLK_HZ;
    reg [5:0] bit_index;
    reg [15:0] frame;
    reg frame_last;
    wire [5:0] next_bit = bit_index + 1'b1;
    // A sample is consumed at the falling edge starting the left channel.
```

## HDMI 音频芯片配置

文件：`source/extensions/business/application/rtl/ms7210_audio_init.v`，第 15–38 行。通过寄存器初始化音频通道。

```verilog
// That driver does not document I2S slot/BCLK ratios; do not infer an extra
// MCLK or a proven 32/64-fs requirement from this register sequence.
module ms7210_audio_init #(
    parameter integer ENABLE=1
)(
    input wire clk,
    input wire rstn,
    input wire busy,
    input wire [7:0] data_out,
    input wire byte_over,
    output reg [15:0] addr,
    output reg [7:0] data_in,
    output reg w_r,
    output reg iic_trig,
    output reg init_over,
    output wire [7:0] device_id
);
    assign device_id=8'hb2;
    localparam [3:0] LOAD=0,READ_LAUNCH=1,READ_ACCEPT=2,READ_WAIT=3,
        WRITE_LAUNCH=4,WRITE_ACCEPT=5,WRITE_WAIT=6,DONE=7;
    localparam [4:0] LAST_STEP=29;
    // Numeric addresses are independently checked against the pinned header
    // by tools/test_ms7210_register_contract.py.
    localparam [15:0] MS7210_HDMI_TX_MISC_HDMI_RST_REG=16'h000b;
```

## 白色标题栏与实时视频合成

文件：`source/extensions/business/application/rtl/light_split_video.sv`，第 3–26 行。标题区域、视频以及叠加图层组合；配合 ui_light_panel。

```verilog
// Header covers the first source rows; no scaling or frame RAM is required.
// HS/VS/DE, selection and both RGB paths have two clocks of latency.
module light_split_video #(
    parameter integer HEADER_HEIGHT = 112,
    parameter BG = "ui_light_bg.hex",
    parameter PAL = "ui_light_palette.hex",
    parameter STATUS = "ui_light_status.hex"
) (
    input logic clk,rst,hs_in,vs_in,de_in,
    input logic [15:0] pixel_in,
    input logic [127:0] snapshot,
    output logic hs_out,vs_out,de_out,
    output logic [23:0] rgb_out
);
    logic [15:0] pixel_d1,pixel_d2;
    logic select_d1,select_d2;
    logic [1:0] hp,vp,dp;
    logic de_prev;
    logic [10:0] x;
    logic [9:0] y;
    wire [23:0] panel_rgb;
    ui_light_panel #(.BG(BG),.PAL(PAL),.STATUS(STATUS)) light_panel(
        .clk(clk),.rst(rst),.x(x),.y(y),.snapshot(snapshot),.rgb(panel_rgb));
    function automatic [23:0] expand565(input logic [15:0] p);
```

## 物理引脚约束

文件：`source/yolo/sources/camera.fdc`，第 1027–1050 行。板级 IO 球号和电平标准；J3 排针还需实际转接板对应。

```text
define_attribute {p:key_n[3]} {PAP_IO_NONE} {TRUE}

define_attribute {p:servo_pwm[0]} {PAP_IO_DIRECTION} {OUTPUT}
define_attribute {p:servo_pwm[0]} {PAP_IO_LOC} {U16}
define_attribute {p:servo_pwm[0]} {PAP_IO_VCCIO} {3.3}
define_attribute {p:servo_pwm[0]} {PAP_IO_STANDARD} {LVCMOS33}
define_attribute {p:servo_pwm[0]} {PAP_IO_DRIVE} {4}
define_attribute {p:servo_pwm[0]} {PAP_IO_NONE} {TRUE}
define_attribute {p:servo_pwm[0]} {PAP_IO_SLEW} {SLOW}

define_attribute {p:servo_pwm[1]} {PAP_IO_DIRECTION} {OUTPUT}
define_attribute {p:servo_pwm[1]} {PAP_IO_LOC} {U15}
define_attribute {p:servo_pwm[1]} {PAP_IO_VCCIO} {3.3}
define_attribute {p:servo_pwm[1]} {PAP_IO_STANDARD} {LVCMOS33}
define_attribute {p:servo_pwm[1]} {PAP_IO_DRIVE} {4}
define_attribute {p:servo_pwm[1]} {PAP_IO_NONE} {TRUE}
define_attribute {p:servo_pwm[1]} {PAP_IO_SLEW} {SLOW}

define_attribute {p:servo_pwm[2]} {PAP_IO_DIRECTION} {OUTPUT}
define_attribute {p:servo_pwm[2]} {PAP_IO_LOC} {AC26}
define_attribute {p:servo_pwm[2]} {PAP_IO_VCCIO} {3.3}
define_attribute {p:servo_pwm[2]} {PAP_IO_STANDARD} {LVCMOS33}
define_attribute {p:servo_pwm[2]} {PAP_IO_DRIVE} {4}
define_attribute {p:servo_pwm[2]} {PAP_IO_NONE} {TRUE}
```

## UART 模型上传与控制协议

文件：`../../extensions/yolo/scripts/board_loader.py`，第 47–70 行。YAI1 请求、YAR1 响应、CRC 和模型传输。

```python

def transact(port,command,address=0,payload=b""):
    frame=request(command,address,payload)
    if port.write(frame)!=len(frame):
        raise IOError("Incomplete UART write; reset/reconnect before retrying")
    header=read_exact(port,8)
    if header[:4]!=b"YAR1" or header[7]!=0:
        raise ValueError("Invalid reply header; reset/reconnect before retry")
    length=struct.unpack("<H",header[5:7])[0]
    if length>1024:
        raise ValueError("Oversized reply; reset/reconnect before retry")
    body=read_exact(port,length+4)
    return parse_reply(header+body)

def parse_detections(raw):
    if len(raw)<4:
        raise ValueError("Malformed detection payload")
    count=struct.unpack_from("<I",raw)[0]
    if count>32 or len(raw)!=4+count*24:
        raise ValueError("Malformed detection payload")
    results=[]
    for i in range(count):
```

## 模型打包

文件：`../../extensions/yolo/scripts/pack_deployment.py`，第 16–39 行。模型与内存地址信息生成，配合 memory_map.json。

```python

def align(n, boundary=256):
    return (n + boundary - 1) // boundary * boundary

def pack(source, output, base=0x01000000, tensor_base=0x02000000):
    graph = json.loads((source / "bundle.json").read_text())
    arrays = np.load(source / "parameters.npz")
    blob, regions = bytearray(), []

    def append(name, array):
        offset = align(len(blob))
        blob.extend(bytes(offset - len(blob)))
        payload = array.tobytes(order="C")
        address = base + offset
        blob.extend(payload)
        regions.append(dict(name=name, address=address, length=len(payload), load=True))
        return address

    cursor, tensors = tensor_base, []
    for idx in range(-1, len(graph["ops"])):
        op = graph["ops"][idx] if idx >= 0 else None
        c, h, w = op["out_shape"] if op else (3, graph["size"], graph["size"])
```

## STM32 四路中继

文件：`stm32_reference/Core/Src/main.c`，第 251–274 行。采样 FPGA PWM 并由 TIM2 四通道重生 PWM；现有掩码/颜色与 v3 有冲突，见总说明。

```c

/* TIM3：100us 采样中断，统计 4 路指令线在 20ms 窗口里的高电平个数 */
void TIM3_IRQHandler(void)
{
  if ((TIM3->SR & TIM_SR_UIF) != 0U)
  {
    TIM3->SR = ~TIM_SR_UIF;

    {
      uint16_t idr = (uint16_t)GPIOB->IDR;

      if ((idr & GPIO_PIN_12) != 0U) { s_hi_cnt[0]++; }
      if ((idr & GPIO_PIN_13) != 0U) { s_hi_cnt[1]++; }
      if ((idr & GPIO_PIN_14) != 0U) { s_hi_cnt[2]++; }
      if ((idr & GPIO_PIN_15) != 0U) { s_hi_cnt[3]++; }
    }

    s_sample_idx++;
    if (s_sample_idx >= IN_SAMPLES_PER_FRAME)
    {
      uint8_t i;

      s_sample_idx = 0U;
      for (i = 0U; i < SERVO_NUM; i++)
```
