licardlu/pangoriscv/docs/architecture/area-budget.csv

implementation | device | clock_mhz | lut | ff | dram | lutram | lut_ff_lutram_total | acceptance
baseline-implementation-standalone-001 | PG2L100H-6IFBG676 | 120.4674 | 8875 | 6658 | 34 | 72 | 15605 | reference only; candidate total must not increase; aim LUT <= 8841
yolo120_application | PG2L100H-6IFBG676 | 120.461538 | 25680 | 21653 | 107.5 | 290 | 47623 | yolo120-001 device-map measured; user-authorized whole application; final STA pending
hdmi_startup_diagnostic | PG2L100H-6IFBG676 | 74.25 | 436 | 526 | 0.5 | 0 | 962 | hdmi-startup-001 mapped; final multi-corner STA passed; SRAM/UART verified; physical picture pending; no YOLO claim
