licardlu/pangoriscv/08_contest/README.md

# 比赛题目与验收依据

材料来源：用户提供的
`全国大学生嵌入式芯片与系统设计竞赛'2026FPGA赛道选题指南-紫光同创.pdf`。
完整PDF已复制到本目录，SHA256与历史记录一致。
这里只整理提供的版本，不宣称已核对赛事后续通知。

本项目对应选题一的RISC-V处理器设计任务。相关正文见完整PDF
第10、11页（印刷页码8、9）；摘页为 `contest-pages-10-11.pdf`，
可检索文本为 `contest-pages-10-11.txt`，图片供核对排版和公式。
PDF原文优先于提取文本和本说明。

## 基础版核对表

| 赛题要求 | 当前待验证对象 | 必须取得的证据 |
| --- | --- | --- |
| RV32I基础整数处理器 | CPU译码、执行、寄存器、异常行为 | 当前原生CPU指令回归及架构提交对照，不能只用原版日志 |
| 不少于3级流水线，处理数据冲突与分支 | IF/ID/EX槽、旁路、停顿、重定向 | load-use、ALU依赖、分支冲刷、可变访存延迟测试 |
| UART、GPIO等基础外设 | 原生AXI外设及板级连接 | 寄存器/协议仿真和实际UART输出、GPIO控制 |
| 紫光同创FPGA平台 | PG2L100H板级顶层及PDS约束 | 当前CPU综合、资源、时序和板上运行 |
| riscv32-unknown-elf-gcc | 软件构建脚本及ELF | 编译器身份、ISA/ABI、反汇编和实际运行 |
| CoreMark v1.0，运行不少于10秒 | 原始算法、移植端口、迭代配置 | CRC有效、真实运行时长、频率和UART原始结果 |
| 性能效率、频率和资源效率 | 当前基础CPU测量 | CoreMark/MHz、合格时钟、LUT等资源及计算过程 |
| 性能分析文档及ILA关键算法波形 | 后续参赛报告与硬件采集 | 实际波形及流水线效率分析；目前未交付 |

两路I/D Cache、动态预测、完整异常/中断以及完整AI应用属于原文高阶任务。
用户当前明确暂不做进阶任务。已有CSR/中断代码可以检查，但不据此宣称
全部高阶任务完成。原生AXI是团队实施路线，不把它写成赛题强制要求。
基础代码完成与比赛测评、报告、波形和上板证据完成应分别判定。

关于复用开源CPU是否符合比赛规则，当前材料不能替代组织方答复；
不要把开源许可当成参赛资格许可。
