licardlu/pangoriscv/docs/plan-v16-120mhz-spec.md

# v16 —— 120 MHz 设计规格（已用静态 ILP 定标，取代 v13/v14/v15 的"不可能"结论）

日期：2026-10-23（修订 2）
状态：**规格 + 首个定量判据已实测**。本文件替代 v13/v14/v15 里"120 MHz 不可达"的判断。

---

## 0. 先纠正我自己两个错误（否则后面全部算错）

| # | 我此前的说法 | 实际 | 影响 |
|---|---|---|---|
| 1 | "两级切分各付一次 load-use，共 2×38,355 拍" | **只有插在"地址生成→数据返回"之间的那一刀付 +1 拍，且只付一次**；本设计 3 级切分只需付 **+20,225 拍**（`pkt_lduse` 上界）+ 2 次重定向 +4,628 | 死周期从 76,710 降到 **51,410** |
| 2 | "IPC_live 上不去，2 发射已到 1.75，最多 ~2.2" | **没有量过**。静态调度模型标定后，4 发射/2 存储口可到 **2.426** | 预算从 1,772 拍变成 ~46,000 拍 |

⇒ 结论反转：**120 MHz 与 ≥5.2 可以同时满足**，前提是三个结构条件同时成立（见 §4）。

## 1. 口径（已核对赛题原文）

```
Score = CoreMark_Iterations / (Total_Time × Frequency) = CoreMark/MHz
三项指标并列：① CoreMark/MHz ② 最高时钟频率 ③ CoreMark/LUTs
分数只认固件自报的 Total ticks：Score = Iterations × 1e6 / Total_ticks
5.2 ⇒ 每迭代 ≤ 192,307 拍；120 MHz ⇒ 周期 ≤ 8.3014 ns
```

## 2. 现状（同一份位流，已上板实测）

```
bitstream/pangoriscv_board48_i2700_5p245.sbit   sha256 331273cb…
CoreMark/MHz 5.2447   每迭代 190,535 拍   48 MHz（布线后 20.581 ns）
setup +0.252 / hold +0.021，失败端点双 0
LUT 17,105 / FF 8,693 / LUTRAM 2,274 / DRM 12
IPC 1.5095（死周期 26,557；非死周期利用率 1.7525）
```

## 3. 新证据：静态 ILP 上界定标（`tools/ilp_bound.py`）

方法：把 CoreMark 反汇编按基本块切开，做"顺序发射 + 端口受限 + RAW 依赖"的贪心调度，
得到每种宽度下的 CPI；再用**实测 2 发射**（1.7525）标定模型。

**模型对现状的预测误差 0.5%**（191,534 vs 实测 190,535 拍），所以外推可信：

| 配置 | 模型 IPC | 标定后 | 受取指限制后 | 拍/迭代（含 51,410 死周期） | 分数 |
|---|---|---|---|---|---|
| 2w / 1 存储口 / 取指 2 | 1.597 | 1.752 | 1.752 | 190,535（实测） | 5.2447 |
| 3w / 1 存储口 / 取指 2 | 1.869 | 2.050 | 2.000 | 192,425 | 5.197 |
| 3w / 2 存储口 / 取指 4 | 2.060 | 2.260 | 2.260 | 179,340 | **5.576** |
| 4w / 1 存储口 / 取指 2 | 1.980 | 2.173 | 2.000 | 184,464 | 5.421 |
| 4w / 2 存储口 / **取指 2** | 2.000 | 2.194 | **2.000** | 183,163 | 5.460 |
| **4w / 2 存储口 / 取指 4** | 2.211 | 2.426 | 2.426 | **170,591** | **5.862** |
| 4w / 4 存储口 / 取指 4 | 2.282 | 2.504 | 2.504 | 166,886 | 5.992 |

全部代码与只取热代码（`core_*`/`crc*`/`matrix_*`/`state_*`）两套统计几乎一致
（2.426 vs 2.425），说明不是冷代码稀释出来的假象。

**关键结论：取指带宽是硬约束。** 4 发射若仍只有 2 条/拍取指，IPC 被钉在 2.0，
分数只有 5.46——加宽发射必须同时加宽取指，否则白做。

## 4. 三个必须同时成立的结构条件

1. **发射宽度 ≥3（目标 4）**：4 个槽/拍，含 2 个存储槽；
2. **取指 ≥4 条/拍（16 B/拍）**：I$ 数据阵列需一次读出 4 个字（4 bank 或 128 位宽），
   AXI 填充 128 位/拍，队列 `push4`；**这一条不做，其余全部作废**；
3. **D$ 双端口读 + 2 项 store buffer**：允许 mem+mem 配对（回收 `pkt_lduse` 20,225 拍），
   并把阵列写使能移出 EX 关键路径（当前占 3.25 ns）。

## 5. 流水线分段（3 级覆盖原 20.581 ns，每级 ≤8.30）

| 级 | 内容 | 现测量 | 预算 |
|---|---|---|---|
| A | 译码 + 寄存器堆读 + 旁路选择（原段①） | 7.33 ns | 8.30 |
| B | ALU + AGU + 地址网（原段②③） | 5.53 ns | 8.30 |
| C | D$ tag 比较 + 阵列读/写（原段④⑤） | 5.12 ns | 8.30 |

- 唯一落在 load 通路上的是 A|B 与 B|C 之间：load 的地址在 B 末、数据在 C 末，
  消费者在下一拍的 B 需要数据 ⇒ **+1 拍 load-use，只此一次**；
- 重定向惩罚从 1 拍变 2 拍 ⇒ +2×2,314 = 4,628；
- 死周期合计 26,557 + 20,225 + 4,628 = **51,410**（这就是 §3 表里用的数）。

## 6. 面积预算（PG2L100H：66,600 LUT / 19,900 LUTRAM / 133,200 FF）

| 模块 | 现有 | 目标 | 原因 |
|---|---|---|---|
| CPU（4 发射 + 互锁 + 8R 寄存器堆） | ~6,800 | ~11,000 | 发射 ×2、旁路网络 ×2 |
| I$（4 KB，4 bank / 128 位读 + 预取） | ~2,600 | ~4,600 | 16 B/拍取指 |
| D$（4 KB，双端口 + store buffer） | ~5,200 | ~7,800 | 阵列复制 + 双套 tag |
| AXI/SoC/外设（MSHR ≥2） | ~2,500 | ~3,200 | 非阻塞填充 |
| **合计** | **17,105（25.7%）** | **~26,600（40%）** | 见下方风险 |

⚠️ **40% 利用率、120 MHz 从未在此器件上验证过**。本项目实测：17.1k LUT 下 48 MHz 通过、
55 MHz 布不通（§70）；26.6k LUT 时密度更高，可布线性是最大未知数。

## 7. 里程碑与 go/no-go（判据全部可在仿真/时序报告里判定）

| 里程碑 | 内容 | 判据（不满足就停） | 预计 |
|---|---|---|---|
| **M1** | 取指 4 条/拍 + 4 发射配对/退休（**不改流水，不提频**） | 20 迭代仿真 `ticks ≤ 2.90M`（≤145,000 拍/iter，Score ≥6.90）；CRC 全对；ISA 20/21 | 1~2 周 |
| **M2** | D$ 双端口 + 2 项 store buffer | `ticks` 再降 ≥12,000；CRC 全对 | 1 周 |
| **M3** | A/B/C 三级切分（含 load-use 互锁、MSHR） | 仿真 `ticks ≤ 3.845M`（≤192,307） | 1~2 周 |
| **M4** | 120 MHz 时序 | `report_timing` WNS ≥0、失败端点 0 | 1 周 |
| **M5** | 可布线性 | 详细布线 0 未布通；若失败先降到 100 MHz 再评估 | 不定 |
| **M6** | 上板 | 板测 `Total ticks` 与同迭代数仿真一致、五项 CRC 全对 | 1 天 |

**M1 是整条路线的成本闸门，而且它本身就有价值**：即使不提频，M1 完成即可把分数从
5.24 提到约 6.9，留出后面所有切分的预算。

## 8. 风险清单（按概率排序）

| 风险 | 概率 | 对策 |
|---|---|---|
| 26.6k LUT / 40% 利用率布不通 120 MHz | **高** | 先做 M2 后的"放置探测"（8 min）再决定；不行就退 100 MHz |
| 取指 4 条/拍实现后 `nostall` 不降反升（I$ 4 bank 增加面积与走线） | 中 | M1 里先只加宽队列与 I$ 读口，不动 AXI；用 `RX`/`nostall` 计数判据 |
| 4 发射的配对/退休逻辑引入死锁 | 中 | 复用现有 `hold_ex` 机制；ISA 21 用例 + CoreMark CRC 双判据 |
| 8R 寄存器堆面积/时序爆炸 | 中 | 用 2 组 4R 复制（各服务 2 个槽），而非单块 8R |
| 工期 ≥5 周 | 高 | 交付基线 `board48` 冻结不动，重构走独立分支 |

## 9. 结论（本轮修订后的正式判断）

> **120 MHz 与 ≥5.2 可以同时满足**，条件是"4 发射 + 16 B/拍取指 + 双端口 D$ + 3 级流水"。
> 预测分数 **5.86**，余量 12.6%（相对 5.2 的门槛 192,307 拍）。
> 若只做 3 发射，预测 5.58，余量 7.2%。
>
> 决定成败的不再是 CPI 预算（那笔账已经够），而是**面积与可布线性**：
> 26.6k LUT / 40% 利用率能不能在 120 MHz 下布通，本项目没有任何先例。
> 这一点必须在 M2 之后用一次真实实现来回答，而不是继续算账。

## 10. 附：可复现的判据命令

```bash
# 静态 ILP 上界（5 秒，不需要综合）
python tools/ilp_bound.py build/native_software/coremark/performance/hw_i2700_48/firmware.dump

# 每个里程碑的分数判据（20 迭代仿真）
python tools/run_coremark_sim.py --image build/native_software/coremark/performance/sim20_O2 --tag <tag>
grep "Total ticks" .sim_runs/coremark_sim/<tag>/transcript.txt
```
