licardlu/pangoriscv/docs/repository-cleanup.md

# 上传源码整理说明

本次整理只处理资料与目录，没有改变 FPGA RTL、C 固件功能、时序约束，没有启动 PDS 或下载开发板。

## 移出内容

旧的根 `build/`、`project/yolo120/build/`、`project/pds_native_120/build/`，本地 `.workbuddy` 配置、临时 `del_lines.py`、各处 `__pycache__`。共 **6401 个文件，3,031,100,489 字节（3.03 GB / 2.82 GiB）**。

上述文件已按原相对路径移到仓库旁的 **`../pangoriscv_清理备份_20261103/`**。备份 `cleanup_inventory.json` 保存逐文件原路径、字节数和 SHA-256；移动后逐一复核通过。用户已有未提交改动随文件保留在备份中，没有重置 Git 或提交代码。需要恢复时将对应目录复制回原相对位置；如原位置已有新构建，不要覆盖。

## 保留与补充

- RTL、C/汇编源文件、测试、模型权重和部署表、程序镜像、IP、约束、来源清单及原始性能证据均保留。
- 构建目录中的 68 份关键摘要、输入清单、流程或最终报告另存 `evidence/records/cleanup_20261103/build_reports/`；该目录现有 68 个文件，与 `preserved_reports.json` 的 68 条 `saved` 路径一一对应。
- 完整垃圾分类应用源码补入 `project/trash_sorting`，明确区分当前外围 v3、后续 v4 源码和 STM32 参考工程。
- 重写根 README，补充代码阅读导引与有来源的性能报告。没有填写不存在证据的识别准确率。
- 本机 `.git` 与 `tools/local-tools.json` 原样保留，但不进入上传压缩包；许可证、缓存及构建数据库同样不打包。

## 核查结果

- 现有 YOLO120 Python 用例 **22/22 通过**，涉及计时、时序/面积及物理约束门禁；不是本次 FPGA 实测。
- CPU 导入清单中 **250 个现存文件哈希一致**；原导入包缺少的 126 项历史文档/参考文件仍如实披露，没有伪造完整发布包验收。
- A/B 性能数字通过 `tools/recalculate_yolo_metrics.py` 从原始 20 个测量帧复算。
- 清理备份文件逐一 SHA-256 核查通过。

旧文档中的 `build/` 链接指向历史生成物，归档后应从上述备份查找。源码构建入口可重新创建新构建目录；本次未验证全量旧实验可直接运行。

上传文件为真正 RAR 格式（RAR5），文件名 `pangoriscv_完整源码.rar`，34,065,293 字节，位于“紫光同创”目录。该压缩包旁没有另附打包校验记录，因此本文不引用解压校验结论。本机 Git 提交历史不随上传包发送，第三方代码来源说明仍包含在源码中。
