licardlu/pangoriscv/docs/plan-ai-garbage-yolo.md

# AI 垃圾分类：状态表与实验定义（v3）

> 只保留状态、判据与原始数据口径。方案叙述到此为止，后续靠小实验定规模。

## 0. 相对 v2 的修正（都是错，不是措辞）

| # | v2 的说法 | 错在哪 | v3 |
|---|---|---|---|
| 1 | "160×160 第一层 400 KB" | 官方 16 通道 ≠ w0.5 的 8 通道；层宽混用 | w0.5 第一层 **160×160×8 = 200 KB** |
| 2 | "约 103 MMAC" | 用 416 总量做面积缩放，且漏了检测头通道只随类别数变（4 类=27，不随宽度缩） | 逐层算 **312 MMAC**（3 倍差距） |
| 3 | "阵列上 144 路" | 未测就锁规模 | **先做 64 路可扩展版**，测完整一层再决定 |
| 4 | "后处理 < 1 ms" | 只算了两两比较，没算筛选/排序/解码 | **待实测**，见 M1c |
| 5 | ILA "一次都没抓过" | 抹掉了前期探针工作 | **尚未正式验收**：探针网/触发 PC 区间/8192 深度/27 MHz 全部就绪，波形未采集 |

## 1. 状态表

| 项 | 状态 | 产物 / 证据 |
|---|---|---|
| **M0** 单路 CMOS1 摄像头 + 显示 | 进行中 | `measure.ps1` 烧厂商 `CMOS1.sbit` |
| **M1a** 定模型与输入尺寸 | 未开始 | 见 §4 判据 |
| **M1b** 存储与搬运能力 | 未开始 | 见 §4 判据 |
| **M1c** CPU 后处理实测 | 未开始 | 见 §4 判据 |
| CoreMark ILA 波形 | **尚未正式验收**（方案就绪、采集未执行） | `docs/ila-capture-procedure.md` |
| AI 推理 ILA 波形 | 未开始（补充材料，不替代上项） | — |
| CPU 与视频同域联调 | 未开始 | — |

## 2. 两个候选模型（只保留两个）

### 候选 A：官方 YOLOv3-tiny（软件正确性参照，不裁剪）

来源：Darknet `cfg/yolov3-tiny.cfg`（原文已核对）。416×416、w1.0、80 类：
13 conv（16/32/64/128/256/512/1024 → 256/512/255…）+ 6 maxpool + 1 upsample + 1 route，
两个 yolo 头（mask 3,4,5 与 0,1,2），LeakyReLU。
参数量约 **8.88 M**。**只用来验证软件前向与量化误差，不用于硬件实现。**

### 候选 B：Lite-A（改动逐条列出）

| 改动 | 原版 | Lite-A | 理由 |
|---|---|---|---|
| 类别 | 80 | **4**（可回收/厨余/有害/其他） | 赛题场景 |
| 检测头通道 | 255 | **27** = 3×(5+4) | 随类别变，不随宽度缩 |
| 宽度 | 1.0 | **0.5**（→ 8/16/32/64/128/256/512） | 适配 66.6k LUT / 230 APM |
| LeakyReLU 斜率 | 0.1 | **0.125**（右移 3 位） | 零乘法；需重训恢复精度 |
| 输入 | 416 | **160 / 128 / 96（M1a 决定）** | 待识别效果实测 |
| 结构 | — | **双头 + upsample + route 全部保留** | 保证与原文同拓扑 |

**逐层表（Lite-A，160×160 输入，4 类）**

| idx | 层 | 通道 | 输出 | 参数量 | MACs |
|---|---|---|---|---|---|
| 0 | conv3×3 s1 | 3→8 | 160 | 216 | 5.53 M |
| 1 | maxpool 2/2 | 8 | 80 | — | — |
| 2 | conv3×3 | 8→16 | 80 | 1,152 | 7.37 M |
| 3 | maxpool 2/2 | 16 | 40 | — | — |
| 4 | conv3×3 | 16→32 | 40 | 4,608 | 7.37 M |
| 5 | maxpool 2/2 | 32 | 20 | — | — |
| 6 | conv3×3 | 32→64 | 20 | 18,432 | 7.37 M |
| 7 | maxpool 2/2 | 64 | 10 | — | — |
| 8 | conv3×3 | 64→128 | 10 | 73,728 | 7.37 M |
| 9 | maxpool 2/1 | 128 | 10 | — | — |
| 10 | conv3×3 | 128→256 | 10 | 294,912 | 29.49 M |
| 11 | maxpool 2/1 | 256 | 10 | — | — |
| **12** | **conv3×3** | **256→512** | **10** | **1,179,648** | **117.96 M** |
| 13 | conv1×1 | 512→128 | 10 | 65,536 | 6.55 M |
| 14 | conv3×3 | 128→256 | 10 | 294,912 | 29.49 M |
| 15 | conv1×1 | 256→27 | 10 | 6,912 | 0.69 M |
| 16 | yolo（mask 3,4,5） | — | — | — | — |
| 17 | route −4（→13） | 256 | 10 | — | — |
| 18 | conv1×1 | 512→64 | 10 | 32,768 | 3.28 M |
| 19 | upsample ×2 | 64 | 20 | — | — |
| 20 | route −1,8（64+128） | 192 | 20 | — | — |
| 21 | conv3×3 | 192→128 | 20 | 221,184 | 88.47 M |
| 22 | conv1×1 | 128→27 | 20 | 3,456 | 1.38 M |
| 23 | yolo（mask 0,1,2） | — | — | — | — |
| | **合计** | | | **2,207,464 ≈ 2.21 M（2.21 MB int8）** | **312 M** |

**两个观察（用于后续裁剪，不作为结论）**
- 第 12 层独占 **118 MMAC（38%）**，是单点最大开销，也是首个该被裁剪的对象。
- 第 21 层 88 MMAC（28%），因为 route 后是 192 通道。
- Darknet 官方报的 5.6 BFLOPS 与这里逐层口径对不上，**需用真实 profiler 复核**，两边都不先采信。

## 3. 算力 → 阵列 → 时间（312 MMAC，纯理想值）

| 阵列 | APM | MAC/s @50 MHz | 理想时间 | 理想帧率 |
|---|---|---|---|---|
| **64 路（先做这个）** | 64 | 3.2 G | **97.6 ms** | 10.2 fps |
| 96 路 | 96 | 4.8 G | 65.0 ms | 15.4 fps |
| 144 路 | 144 | 7.2 G | 43.4 ms | 23.0 fps |
| 256 路 | 256 | 12.8 G | 24.4 ms | 41.0 fps |

这些都是**不含取数等待、换层、边界处理**的理想值，实测只会更慢。
10 fps 对"把垃圾放上去看分类结果"这个演示场景大概率够用，**所以没有理由先做 144 路**。
若 w0.25 版（约 78 MMAC）精度可接受，64 路可到约 24 ms。

## 4. M1a / M1b / M1c 的判据

### M1a 模型与输入尺寸
- 数据：`ai53_19/garbage_datasets`（先实地核查类别映射、标注质量、长尾分布、许可证原文）
- 对比：输入 96 / 128 / 160，官方 A 与 Lite-A
- 记录：mAP50、四类各自 AP 与小目标（电池/烟头/牙签）召回
- **通过条件**：真实演示距离与背景下四类可分辨；小目标不出现"完全检不出"
- 先 5~10 epoch 测单 epoch 耗时再外推，不承诺总时长

### M1b 存储与搬运
- 场景：**视频持续显示的同时**跑 AI 侧的真实读写流量
- 必须写清四件事：① 每类数据放哪个地址；② 谁能读写（CPU / 加速器 / DMA）；
  ③ 一帧完成的标志是什么；④ 如何避免读到正在更新的帧（双缓冲 + 写指针翻转 + 帧号校验）
- 记录：有效带宽、平均与最差等待、**图像是否出现撕裂或花屏**
- 权重可能被重复读取，不能假设"每帧只读一次"

### M1c CPU 后处理
- **不必等加速器**：用 PC 端真实模型输出（int8 反量化的 logits）作输入
- 在现有 CPU 上实测：阈值筛选 → Top-K → 框解码 → 分类别 NMS 的周期数
- 同时统计**漏检**：阈值 0.3 / 0.5 与 K=16/32/64 各档的召回变化
- **通过条件**：给出"周期数 vs 漏检率"的曲线，而不是一个最快值

## 5. 明确仍未知（不得写成结论）

阵列规模 · 实测帧率 · 后处理耗时 · DDR 有效带宽 · 最终模型与输入尺寸 · 端到端延迟
