licardlu/pangoriscv/docs/plan-v25-refactor.md

# v25 —— 重构方案：让 5.2 分与 120 MHz 同时成立

> 触发：群里有队伍做到了 120 MHz。本文件回答"他们怎么做到的"以及"我们要怎么改才能同时守住 5.2"，
> 并把工程拆成可独立验收的里程碑。**先算清账，再动代码。**

---

## 0. 先把"不可能"的那句话收回一半

v23/v24 的结论是"5.2 与 120 MHz 互斥"，其推理链只有一处硬约束值得再检查：

| 项 | v23 的假设 | 重新算 |
|---|---|---|
| 每迭代指令数 | 未直接给 | 由 IPC 1.7525 × 190,670 拍 ≈ **334,000 条** |
| 5.2 需要的拍数 | 192,307 | 192,307（不变） |
| 5.2 需要的 IPC | **1.735**（不是 2.5） | ✔ 现设计 1.7525 已达标 |
| 加一级访存流水的代价 | +34,757 拍（+18%） | 190,670 → 225,427，分数 **4.44** |
| 要救回 5.2 需要多少 IPC | — | 1.7525 × 1.18 = **2.07** |
| 3 发射（2 访存口）的模型 IPC | — | **2.259**（`tools/ilp_bound.py`） |

⇒ **关键结论：只要 IPC 从 1.75 提到 2.0 以上，就能"付得起"一级访存流水的 18% 代价，
从而同时拿到 5.2 与高频。** 群友能做到，大概率就是走了这条：**更宽发射 + BRAM 缓存 + 更深的流水线**。

v23 之所以判死，是因为它只考虑了"2 发射 + 加流水级"这一条组合，没把"加宽发射"当成同一条改造的必备项。

## 1. 目标结构（唯一能同时满足两项指标的形状）

```
取指 (IF) → 译码/发射 (ID, 3 lane) → 执行 (EX) → 访存1 (MEM1: 地址/阵列读) → 访存2 (MEM2: 命中选择) → 写回 (WB)
                                              ↑ 2 拍 D$/I$（BRAM 同步读，去掉 LUTRAM 复制与 1,024 脚扇出）
```

| 指标 | 现值 | 目标 | 依据 |
|---|---|---|---|
| IPC | 1.7525 | ≥2.05 | 3 lane 模型 2.259，留 10% 余量 |
| 拍/迭代 | 190,670 | ≤192,307 | 5.2 的硬门槛 |
| 关键路径 | 19.563 ns | ≤8.333 ns | 120 MHz |
| LUT | 17,174 | ≤17,500 | 面积只减不增的原则，放宽到 +2% 以容纳第 3 lane |
| LUTRAM | 2,274 | **0** | 全部进 BRAM，这是去掉"1,024 脚写地址扇出"的唯一办法 |

预测（按模型，不是实测）：`334,000 / 2.259 = 147,853` 拍，加 18% 访存流水 = **174,466 拍 ⇒ 5.73 分**。
即使 IPC 只做到 2.05：`334,000/2.05 × 1.18 = 192,270` 拍 ⇒ **5.20**，刚好踩线。
**⇒ IPC 2.05 是生死线，必须在 M1 之后立刻用仿真量出来，不能等做到最后才发现不够。**

## 2. 里程碑与判据（每个里程碑独立验收，不通过就停）

| # | 里程碑 | 内容 | 判据 | 估工 |
|---|---|---|---|---|
| **M0** | 基线固化 | 当前 5.2447@50MHz 的位流/镜像/证据冻结 | 上板 CRC 全对（已完成） | 0.5 天 |
| **M1** | 缓存换 BRAM | I\$/D\$ 阵列改同步读 BRAM（DRAM 推断或原语例化），应答延后 1 拍；LSU 侧已有的 `req/resp` 握手直接吸收 | 仿真 ticks 稳定在 **225,000 ± 3,000**；五项 CRC 全对；LUTRAM = 0 | 3–4 天 |
| **M2** | 频率验证 | M1 的网表在 **120 MHz** 约束下做满流程 | 要么 `All Constraints Met`，要么拿到布线后最差路径（决定 M3 的切入点） | 1 天 |
| **M3** | 第 3 发射槽 | 增加一个受限发射槽（只允许 ALU/分支，不允许访存），复制第二套 rs1/rs2 读口与旁路 | 仿真 IPC ≥2.05（拍/迭代 ≤192,307 折算） | 5–7 天 |
| **M4** | 时序收口 | 按 M2 的报告切剩余长路径（多为 ALU→地址→阵列） | 120 MHz 满流程通过，失败端点 0 | 3–5 天 |
| **M5** | 上板 | 位流 + 120 MHz 镜像（迭代数按 10 s 反推） | 五项 CRC 全对、`Total ticks` 与仿真一致、运行 ≥10 s | 0.5 天 |

合计 **13–18 天**。M1 是分水岭：**它同时决定"面积能不能降"和"频率能不能上"**，所以先做它。

## 3. M1 的技术要点（最容易踩坑的地方）

1. **两读口是 BRAM 的天敌**。D\$ 现在是 2 读（双 lane）+1 写。Pango DRM 支持真双口（TDP），
   但"2 读 + 1 写"仍需 3 个口。三条出路，按优先级：
   - **(a) 双 bank 交错**：把阵列拆成 2 个 BRAM，lane0 读 bank0、lane1 读 bank1，地址低位选 bank；
     同 set 同拍冲突的概率低，冲突时把 lane1 推一拍（`lane1` 本来就允许被 stall）。
   - **(b) 复制一份 tag 阵列**：tag 小（64×19 bit），复制便宜；data 阵列仍单口，靠 (a) 的推拍。
   - **(c) 放弃双发访存**：把 lane1 的访存限制到下一拍——这会直接吃掉 IPC，**不选**。
2. **写路径必须在 MEM2 之后**：v23 的 cut-6 之所以把 PDS 卡死，是因为写地址由 FSM 组合产生并扇出到 1,024 个
   LUTRAM 脚。改 BRAM 后写地址只到 1–2 个 BRAM 的 WADDR 端口，**这个扇出问题物理上消失**——
   这是 M1 顺带解决的最大隐患。
3. **BRAM 同步读 = 1 拍延迟**，必须把这 1 拍写进流水线（MEM1/MEM2 两级），
   并让 `load-use` 的互锁按 2 拍算。**不要试图用"组合读"绕开**：那等于又回到 LUTRAM。
4. **不要碰 cut-6 那套"延迟写"**：M1 之后写口只剩 1 个 BRAM 端口，原来的 4.77 ns 写路径自然消失。

## 4. 面积账（用户重点关注）

| 项 | 现在 | M1 后 | 说明 |
|---|---:|---:|---|
| I\$/D\$ LUTRAM | 2,274 | **0** | 进 BRAM（各 4 KB → 2 个 DRM 足够，DRM 现用 12 个，够） |
| I\$/D\$ LUT | ~5,274（含地址译码/mux） | ~3,500 | 阵列外围逻辑大幅减少 |
| 第 3 发射槽 | — | +1,800~2,500 | M3 的预算 |
| 净变化 | 17,174 | **≈16,000–17,500** | 面积不增的同时把频率翻倍 |

面积在这里不是"好看"，而是**频率的前置条件**：19.56 ns 里 15.87 ns 是布线，
而布线的根因是 1,024 个单比特 LUTRAM 撒在整片 die 上、被同一根写地址串起来。**把阵列搬进 BRAM = 把布线问题从根上删掉。**

## 5. 风险与止损

| 风险 | 触发信号 | 止损动作 |
|---|---|---|
| 双读口 BRAM 推断失败（又退回 LUTRAM） | 综合后 LUTRAM 仍 >0 | 改用手工例化 `GTP_DRM` 原语（PDS IP 模板），不走推断 |
| BRAM 化后 ticks 涨幅 >20% | 仿真 >228,000 拍/迭代 | 缩小 D\$ 到 2 KB（board39 配置本来就更好：188,888 拍） |
| 3 发射做不出 IPC 2.05 | M3 仿真不达标 | 退一步：只加"双 ALU 但单访存"的窄第三槽；再不行就保 5.2 放弃 120 MHz，回到 50 MHz 交付 |
| 120 MHz 仍差一点 | M4 报告显示差 <1 ns | 用 M1 释放出来的面积余量做一次区域约束（只此一次，历史上三次负优化都是因为没有面积余量） |

## 6. 与旧结论的关系（避免以后又绕回来）

- v23 的"5.2 与 120 MHz 互斥"**在 2 发射的前提下成立**，本文件不推翻它，只是补上缺失的前提。
- v24 的"cut-6E 不可交付"**仍然成立**，M1 用 BRAM 把它想解决的问题从物理上消灭，不再走 RTL 打拍那条路。
- 换 seed / 重跑同一网表 / 三种 floorplan 形状：**继续禁止**（已实测无效）。
