licardlu/pangoriscv/docs/plan-v24-120mhz.md

# v24 —— 「5.2 分 + 120 MHz」执行计划（先计划、后执行）

> 前置事实：本计划基于 2026-10-27 00:47–00:53 的**真机实测**（`pangoriscv-verify/runs/`）。
> 判据先写死，每阶段跑完照表核，不合就不进下一阶段。
> 仓库纪律：单 trunk、不建分支、不动 `-seed`、不重跑同一网表求抽样。

---

## 0. 目标拆解（三项指标各自独立，别混着说）

| # | 指标 | 公式 | 现状（实测） | 目标 | 差距 |
|---|---|---|---|---|---|
| 1 | CoreMark/MHz | `1e6 ÷ 每迭代拍数` | **5.2447**（190,670 拍/迭代） | ≥ 5.2 | **已达成** |
| 2 | 最高时钟 | `report_timing` 通过的最高约束 | **50 MHz**（布线 19.563 ns） | 120 MHz | 需 8.333 ns，**差 2.35×** |
| 3 | CoreMark/kLUT | `CoreMark/MHz ÷ LUT(k)` | 0.3054（17,174 LUT） | 越大越好 | — |

**结论性前提（必须写在最前面，避免自欺）**：指标 1 已达标，本轮真正要攻的只有指标 2。
而指标 1 的余量只有 **1,637 拍/迭代 = 0.86%**（192,307 − 190,670），
所以**任何"每级流水"式的改造都会立刻把 5.2 打破**（仓库实测：一级访存流水 = +34,757 拍 = +18%）。

⇒ 本轮唯一的出路不是"加流水级"，而是 **"稀路径延迟化"**：把关键路径上那些**只有少数指令才走**的
逻辑（CSR 读、乘法器、D\$ 写口）**单独打一拍**，让常见指令一拍都不多花。这与仓库 v23 的
"切访问流水"是两条不同的路，也是本计划相对 v23 的唯一新意。

## 1. 瓶颈的量化（依据 `report_timing.rtr` 逐段账，v23 §10）

交付版最差路径 24 级、19.563 ns（**Logic 3.685 / Route 15.87**，布线占 81%）：

| 段 | 内容 | 累计 ns | 占比 | 是否"稀路径" |
|---|---|---:|---:|---|
| 1–3 | `w_valid` → CSR 读 mux 三级 → `alu_a` | 11.446 | — | **CSR 读 mux 3.0 ns 是稀路径**（只有 csrr* 才用） |
| 3–4 | ALU 四级 + `alu_y→fwd1_h` | 12.638 | 5.03 | 一半是乘法（APM 级联），**mul 是稀路径** |
| 5–7 | 地址加法 → `ls_req_addr`(fanout 144) → D\$ mux | 14.851 | 2.2 | 地址可提前一拍算好 |
| 8–9 | → `hit_any`（tag 比较 + set 选择） | 17.304 | 2.45 | 可用寄存 tag 并行比较 |
| 9–11 | FSM 5 级 → 写地址 → **1,024 个 WADDR（单网 2.5 ns）** | 22.076 | **4.77** | **纯写路径，可整体打拍** |

**最大单笔：第 9–11 段 4.77 ns（22%）只服务于"命中时把 store 数据合并进 D\$ 阵列"，读路径根本不需要它。**

## 2. 路线：五刀，按"每刀收益 ÷ 拍数成本"排序

| 刀 | 做什么 | 预期砍掉 | 拍数成本 | 风险 |
|---|---|---:|---|---|
| **L1** | D\$ 写口**单口延迟化**（cut-6 变体 E，已在 HEAD、功能已验证、**从未做过时序与上板**） | **4.77 ns** | ≈0（store 本就走队列） | 低，代码已存在 |
| **L2** | **CSR 读数据打一拍**（`csr_rdata` 入寄存器，csrr* 多一拍） | **~3.0 ns** | ≈0（CoreMark 循环内无 CSR） | 中，要改 CSR 冒险判定 |
| **L3** | **乘法器单独打拍**（APM 两级流水，mul 结果晚一拍 + 互锁/旁路） | ~1.5–2.0 ns | mul 相关停顿（CoreMark ≈1–2%） | 中，可能吃掉全部 0.86% 余量 |
| **L4** | **访存地址提前算**（EX 算好 `mem_addr` 寄存，MA 直接用） | ~1.3 ns | ≈0 | 低 |
| **L5** | **hit_any 与数据读并行**（tag 用寄存值比较） | ~1.2 ns | ≈0 | 中，改 D\$ 时序 |

理论上限：19.563 − 4.77 − 3.0 − 2.0 − 1.3 − 1.2 ≈ **7.3 ns ⇒ 137 MHz**。
但**不要相信这个加法**：Route 占 81%，缩短逻辑深度不一定缩短布线距离，
真实收益必须由 PDS 每轮实测。**L1 单项（4.77 ns）最确定，先做它拿数据。**

## 3. 面积优化（用户重点要求，按 §2.1 面积表）

| 目标 | 现状 | 动作 | 面积影响 |
|---|---|---|---|
| `u_bp`（BTB/预测器） | 1,089 LUT / 1,664 FF | BTB 条目/历史位裁剪，或降相联度 | −100~300 LUT |
| `u_regs`（寄存器堆+读端口） | 1,137 LUT / 992 FF | 读端口复用；写回旁路替代第二读口 | −150~250 LUT |
| `ifu` | 1,906 LUT / 1,038 FF | 取指队列深度裁剪 | −100~200 LUT |
| I\$/D\$ LUTRAM | 2,274（已复制） | **不动**（复制是为了第二个读口，砍读口 = 加流水级 = 破 5.2） | 0 |
| 外设 | 1,189 LUT | 只保留 UART/GPIO/TIMER，SPI 可编译裁掉 | −200 LUT |

面积纪律照 v23 §2：`Δ(LUT+FF+LUTRAM) ≤ 0`，每刀单独提交、单独记 Δ。

面积为什么和频率有关：本设计的 route 占 81%，而 route 与**物理跨度**强相关。
少 500 LUT 不会自动提速，但**能降低拥塞与跨度**，是 L1–L5 之外的次要杠杆。

## 4. 阶段与判据（gate 先写死）

| 阶段 | 动作 | 判据（不过就停在这里，不往下走） |
|---|---|---|
| **P0** | 装 RISC-V 工具链 → 生成 `program.hex/data.hex` | 综合日志出现 `Loading memory data from file`；镜像 SHA256 入库；**缺镜像的时序不可信**（skill §4.x） |
| **P1** | HEAD（cut-6E）50 MHz 满流程 + 上板 | 仿真 ticks 不变（预期 190,670）；上板 CRC 五项全对；时序 All Constraints Met |
| **P2** | 同一网表 **120 MHz 约束**满流程，读出真实 fmax | 拿到布线后最差路径数值（不要求通过），作为后续每刀的对照基线 |
| **P3** | L2/L3/L4/L5 逐刀实施，每刀：仿真 ticks → 满流程 → 记 Δns / ΔLUT / Δ拍 | 每刀必须 **ticks 增量 ≤ 0.4%（≤763 拍）**，否则回退 |
| **P4** | 收敛到目标频率，面积不增，出位流 | 约束频率下 All Constraints Met、失败端点 0 |
| **P5** | 上板实测 | 五项 CRC 全对、`Total ticks` 与仿真一致、运行 ≥10 s |

## 5. 不做清单（都已被实测否掉，禁止再试）

- 换 `pnr -seed`（静默 no-op，已是你明确否掉的）
- 重跑同一网表求新抽样（布线确定性，五种配方逐位相同）
- floorplan / 区域约束三种形状（横带/竖带/紧凑块，全部负优化）
- 把 Cache 阵列搬 BRAM（砍读口 = 加一级访存 = 18% 拍数）
- 两步流程（紧约束摆放 + 松约束布线，布线吃掉 4.7 ns）
- 建分支做实验（单 trunk，改动直接进主干，失败就 `git revert`）

## 6. 诚实边界（写在计划里，避免最后才发现）

若 L1–L5 全部落地后仍达不到 120 MHz，那么"5.2 分 + 120 MHz"在这套微架构上就是**互斥**的，
判据是：**CoreMark 的静态 ILP 上限 2.504 ⇒ 每迭代 ≥142,002 拍 ⇒ 分数 ≤7.04**；
而 120 MHz 需要把单拍 ALU + 单拍 D\$ 拆开，每拆一级就要付 34,757 拍。
到那一步我会给出**实测的 fmax 上限 + 逐刀数据**，而不是一句"做不到"。

## 7. 时间与产出

- 每轮 PDS 满流程 ≈ 18–40 min（含综合/摆放/布线/位流）
- 本计划产出：`docs/plan-v24-120mhz.md`（本文件）、每阶段 `evidence/records/v24-<阶段>/`、
  最终 `bitstream/` 更新 + 上板串口原文
