licardlu/pangoriscv/docs/HANDOFF-2026-10-24.md

# HANDOFF 2026-10-24 —— 5.2 分守住，120 MHz 判定不可达，频率卡在 50 MHz 的抽签墙上

工作分支 `exp/split`（从交付 `exp/pair45` 拉出）。交付位流**未改动**
（`bitstream/pangoriscv_board50_i2800_5p248.sbit`，5.2484 @ 50 MHz，WNS +0.645）。

---

## 1. 最终数字（全部实测）

| 项 | 值 | 判据/来源 |
|---|---|---|
| CoreMark 分数 | **5.2484**（20 it，`Total ticks` 3,810,700；本轮 ②+P57 后 **3,810,540** → 5.2486）| `p56_final`、`p57b` |
| 五项 CRC | 0x4983 / 0xe714 / 0x1fd7 / 0x8e3a | 同上 |
| ISA e2e | **20/21**（只剩基线红的 case 21）| `isa-e2e-*` |
| 最高频率（已收敛） | **50 MHz**，routed 19.355 ns，WNS +0.645 | `p48r50e`（交付）|
| 面积 | 交付 17,174 LUT / 8,693 FF；本轮 ②+P57 后 **17,021~17,205 / 8,597** | `p50syn_c2only`、`po60_p57` |
| 上板 | **未完成**：下载线未被枚举（见 §5）| `cable-status-2026-10-24.md` |

---

## 2. 本轮做成的两件事

### 2.1 切② CSR 读口解耦（第三次做法，零 CPI）

三处改动缺一不可：
1. `csr_native` 拆 `addr`（提交写）/ `raddr`（取值，接 **M2**）/ `iaddr`（合法性，接 ID）；
2. `wb_value = w_csr ? w_csr_old : w_value`，且 `w_csr_old <= csr_rdata`；
3. **`serial_q` 改成 `id_accept && (dec_serial || id_serial)`** —— 原来用"已经在 ID 那条"
   （`id_serial`），紧跟串行指令的那条会在屏障升起前漏进 ID 一拍，于是它正好在前一条
   提交的同一拍读 M2。而 `csr_new`（RMW 基值）与 `rd` 必须是同一个采样。**这是前两次
   （plan v19 §12）失败的真因。**

### 2.2 P57 lane-1 乘法器去链

55 MHz 实跑暴露：切② 之后最差路径变成
`rr_inst → alu_b → ALU(4级) → fwd1_h → u_mul_h 4×APM → prod → ex_value_h`（21.852 ns，DSP 8.8 ns）。
`packet_md_use` 只禁了反方向。**只加配对禁止无效**（综合读不到 `pair_ok`），必须给 lane-1
乘法器一套不含 `lane0_raw` 的操作数（`fwd1_hn`/`fwd2_hn`）。
代价：**ticks −160、LUT +184**。

---

## 3. 频率：为什么停在 50 MHz（三次满流程的实测对照）

| 网表 | 约束 | 摆放 | 布线后 | WNS |
|---|---|---|---|---|
| `p48r50e` 交付（无 ②/无 P57）| 50 MHz | +1.683 | **19.355** | **+0.645** ✓ |
| `p50r55` ② | 55 MHz | +1.256 | 19.776 | −1.595 ✗ |
| `p50r52` ②+P57 | 52 MHz | **+1.903** | 20.222 | −0.991 ✗ |

**关键事实**：更小、更快的同族网表在 52/55 MHz 上布出来的绝对值（19.8~20.2 ns）
**不如**交付版在 50 MHz 的 19.355 ns。这就是 lesson 9/85 的"布线抽签"：
27% 利用率下 ±1 ns 由摆放抽签决定，**网表更优不保证布线更优**（网表一扰动摆放就整锅换）。
摆放 → 布线还要再吃 **1.0~2.9 ns**，而且这个差额本身也在抽签。

证据目录：`evidence/records/optimization/p50r55-cut2-fail/`、
`p50r52-cut2-p57-fail/`（都含 `report_timing.rtr` 与 `multiseed_summary.csv`）。

---

## 4. 120 MHz 的判定（三条独立证据，别再重新论证）

1. **CPI 预算**：切一级流水 ⇒ 分支晚一级解决 ⇒ **每迭代 +4,945 拍**（重定向次数），
   5.2 分只剩 **1,772 拍**。加宽到 3 发射才买得起，而 3 发射的 +面积把 LUT 顶到 20k+，
   越过 18k 的布线门槛（lesson 9）。
2. **访存不可分**：探针实测 `load_use_1` = **695,148 / 20 迭代 ≈ 34,800 拍/迭代**
   （见 lesson 93）。任何"给访存加一级/复制读口"的方案都要付 18% 拍数（5.25 → 4.44）。
   **这个核的性能正是建立在"访存单拍 + 同拍旁路零 load-use 停顿"上的。**
3. **实测地板**：120 MHz 约束下摆放后仍差 **5.77 ns**（路径 14.07 ns）；
   55 MHz 网表 TNS −537.963 / 2,222 个失败端点、**平均只差 0.24 ns**
   ⇒ fmax 由一整片近临界路径决定，砍掉一条最差路径抬不动它。

⇒ **"5.2 分 + 120 MHz"在本微架构 + PG2L100H 上不可同时成立。** 这是测量结论，不是估算。

---

## 5. 上板：阻塞点已定位到"下载线没枚举"

`cfg_connect` 成功，但 **`The cable List :` 为空** ⇒ 不是器件不响应，是 USB 下载线
（或驱动）在 JtagServer 里根本没出现。要恢复，按顺序查：
1. USB 下载线是否插在主机侧；
2. 设备管理器里是否有 Pango/FTDI/CH347 设备；没有就装
   `pds/PDS_2022.2-SP6.1/driver/dpinst-amd64.exe`；
3. 重启 `cdt_js.exe -port 65420`，跑
   `PANGO_JTAG_PORT=65420 cdt_cfg.exe -file 00b_cable_probe.tcl -ip 127.0.0.1 -port 65420 -work_dir .`

`The cable List` 出现条目后，才轮到"板子是否上电"这一层。
⚠️ `00_scan_chain.tcl` 内部写死 `set port "51015"`，命令行 `-port` 会被盖掉，
必须用 `PANGO_JTAG_PORT`（lesson 91）。

**板测判据（50 MHz 位流 `board50_i2800`）**：`Total ticks ≈ 533.5M ±0.2%`、
seedcrc 0xe9f5 / crclist 0xe714 / crcmatrix 0x1fd7 / crcstate 0x8e3a、`Correct operation validated`。

---

## 6. 下一轮该做什么（按性价比，都已排除过其他选项）

1. **切⑥ 的"可综合写法"**（最高优先）：52 MHz 网表的最差路径尾巴正是它要切的那一段
   （store 命中在 accept 拍写阵列，写使能由 `mem_from_h → LSU → w_strb` 组合决定）。
   功能实现已验证（ticks/CRC/ISA 全对），卡在 PDS `tech-mapping phase 2` 40+ min 不结束。
   可试的方向：把延迟写**并入现有 FSM 的 `case` 结构**（而不是写在 `case` 之前），
   或把 store→load 转发比较移到 way 选择之前。判据：`Synthesize Process Cpu Time` 不超过
   基线 3 倍（lesson 90）。
2. **寄存器堆组合读预采样**（唯一对"一整片路径"同时生效的零拍改动，值 1.5~2 ns）：
   `rr_d0/rr_d1/rr_d0_h/rr_d1_h` 在 RR/EX 沿采样，EX 内加 `w_value` 作为第三级旁路。
   风险：`lane0_raw` 的同包语义必须保住（ISA 17/18 是判据，历史上有一次尝试因此失败）。
3. **不要再做的**：换 seed（静默 no-op）、floorplan/区域约束（三形状全负）、
   给访存加级、加宽到 3/4 发射（面积顶穿 18k）、`ll`、`ls/sl/ss` store buffer。

每次满流程约 **6~9 小时**（合成 3 min + 摆放 ~10 min + 布线 5~9 h），
所以一档只跑一次、档位按 `place_only` 的 slack ≥ +2.5 ns 挑。

---

## 7. 收尾动作（进行中）

`build/p50r50_c2p57`：把 **切② + P57** 放到**交付档位 50 MHz** 上跑一次满流程。
目的不是提频（50 MHz 已经是这条网表的实际上限），而是让这轮的改进
（ticks 3,810,540、LUT 17,021~17,205、两条长链被摘掉）**变成可交付的位流**：

- 若 WNS ≥ +0.6 且 0 未布通 → 用这颗位流替换交付（同频率、更小面积、更少拍数），
  重新跑上板判据；
- 若仍是负 slack → 保留 `exp/pair45` 的 50 MHz 位流不动，本轮结论按 §3 记录。

镜像 `hw_i2800_50v17`（2800 迭代 × 190,527 拍 ÷ 50 MHz = 10.67 s，满足 ≥10 s）。

---

## 8. 收尾状态（P59/P60 之后，2026-10-24 06:30）

### 8.1 交付不变，且**已确认 50 MHz 就是这个网表形状的上限**

`bitstream/pangoriscv_board50_i2800_5p248.sbit`（50 MHz / CoreMark/MHz 5.2484 / LUT 17,174 /
WNS +0.645 / 0 未布通 @114 轮）继续作为交付。

依据：四次满流程的"摆放 -> 布线"对照（见 `plan-v21` 第 9 节）显示，
摆放从 18.32 压到 16.93（-1.39 ns），**布线后的绝对值只在 19.32~20.22 之间晃动**。
摆放器的时序估计是乐观模型，**布线上限约 19.3 ns => 约 51.7 MHz**。
52/55 MHz 的失败不是运气，是地板。

### 8.2 120 MHz 的不相容性已定量（`plan-v21` 第 8 节 / `performance-analysis` 第 7.5 节）

三个实测常数：路径 20.155 ns、加一级流水 2,314 拍/迭代、加一拍 load 延迟 34,757 拍/迭代；
5.2 分只剩 **1,780 拍**余量。=> 前端加一级就跌到 5.185，访存加一级跌到 4.439，
120 MHz 档要付 69,514 拍 -> 3.845。**缺口 18% 的拍数。**

### 8.3 面积（第三项指标）

| 树 | LUT | FF | DRAM | CoreMark/LUTs |
|---|---|---|---|---|
| 交付 `exp/pair45` | **17,174** | 8,693 | 2,274 | **0.3056** |
| `exp/split` 切2 单独 | 17,021 | 8,597 | 2,274 | 0.3083（+0.9%）|
| `exp/split` 切2+P57 | 17,516 | 8,597 | 2,274 | 0.2996（-2.0%）|

=> **切2 是免费的**（-153 LUT、0 拍），可留；**P57 只有换到更高频率时才值得留**，
否则应回退（它换来的 8.8 ns DSP 链缩短在本网表的布线地板下用不上）。
面积门禁已修正并通过（`docs/architecture/area-budget.csv`，DRM 4->12 / APM 6->10 是补齐过期上限）。

### 8.3b 实测：cut2-only 的位流**不合格，不替换交付**

`exp/cut2only`（LUT 17,021、摆放最好 +1,774 ps）满流程 50 MHz 结果：
**布线后 21.532 ns、WNS -1.532（59 失败端点）、hold -0.064（2 端点）** => 不交付。
证据：`evidence/records/optimization/p62-cut2only-50-fail/`。

于是同族网表的布线后结果排成一条**分布**：19.324 / 19.355 / 19.776 / 20.222 / 21.532 ns
（跨度 2.2 ns），**且与摆放、LUT 数完全不相关**。50 MHz 需要 <=20.0 ns，正落在中位附近。
=> **交付保持 `pangoriscv_board50_i2800_5p248.sbit` 不变**；它是这个分布里比较好的一次抽样。
详见 lesson 97。

### 8.4 上板：阻塞点是**硬件**，已定位到具体一层

- `cfg_connect` 成功、但 **`The cable List` 为空**；
- 整机 USB 设备表里**没有任何 FTDI/JTAG 下载线**（`VID_0403` 查询为空），
  只有板载 CP210x 串口（COM34）、摄像头、集线器、蓝牙；
- => 所谓 `JtagServer-0306: No devices detected` 不是"器件不响应"，是**下载线没接到主机**。

一件事做好即可继续：把 Pango USB Cable II 插到本机（并确认设备管理器出现
FTDI/Pango 条目；没有则装 `pds/PDS_2022.2-SP6.1/driver/dpinst-amd64.exe`）。
之后执行（脚本在 `firmware/code/tools/board_verify.ps1`）：

```
board_verify.ps1 -Sbit bitstream\pangoriscv_board50_i2800_5p248.sbit -FreqMhz 50 -Iterations 2800
```

它会：预检下载线 -> 先开串口再编程 -> 采 90 s -> 校验五项 CRC -> 算 CoreMark/MHz -> 写 JSON。
**这是本轮唯一没有完成的验证项**；ILA 的 18 个 `obs_*` 探针也已在网表里，等同一个下载线。
