licardlu/pangoriscv/docs/plan-v19-memmem.md

# v19 —— 从"配对拒绝"里榨拍数：memmem 优先于 4 发射

日期：2026-10-23　分支：`exp/wide4`　前序：`plan-v18-m1-wide4.md`（M1-S1/S2 已完成）

## 0. 为什么改路线：一个实测数字

M1 的 S1+S2 已经把取指端从 2 条/拍做到 16 B/拍，但分数只从 5.2484 到 **5.2710**。
v18 计划下一步是 S3（4 槽发射/退休）。**本文件用实测数据否掉这个顺序。**

A/B 实验（同一 20 迭代 CoreMark 镜像，同 RTL 除一处旁路）：

| | S1+S2 | S1+S2 + lane0-load→lane1 旁路 |
|---|---|---|
| `Total ticks` | 3,794,355 | **3,769,091** |
| 分数 | 5.2710 | **5.3065** |
| `lduse` 被拒桶 | 159,683 | 118,816（−40,867）|
| `pair` | 2,537,258 | 2,563,522（**+26,264**）|
| 转化率 | 22%（lesson 77 实测）| **64%** |

**转化率 26,264 / 40,867 = 64%**，而 lesson 77 记录的是 22%（1/4.5）。
⇒ **16 B 取指已经把"前端供给"这条约束松开了一大半**，此前"任何放宽配对的收益只剩 1/4"
的结论**只对 2 条/拍取指的时代成立**。给本路线定性的是这一条：配对规则现在能兑现 2/3。

## 1. 当前被拒对的完整账（`m1_s2_lduse`，20 迭代 → 每迭代）

| 桶 | 20 迭代 | 每迭代 | 修法 | 代价 |
|---|---|---|---|---|
| `memmem` (两者都访存) | 308,556 | **15,428** | store buffer / 双端口 D$ | 中 |
| └ `ll` 双 load | 286,032 | 14,302 | **需要 D$ 双读端口** | 高 |
| └ `ls` load+store | 115,745 | 5,787 | **store buffer 即可** | 中低 |
| └ `sl` store+load | 15,429 | 771 | 同 `ls` | 中低 |
| └ `ss` 双 store | 10,166 | 508 | 同 `ls`（需 2 个 slot）| 中低 |
| `lduse` lane0 load → lane1 用 | 118,816 | 5,941 | **已做**（本分支）| 零面积 |
| `mduse` lane0 mul → lane1 用 | 64,171 | 3,209 | lane1 从乘法器输出旁路 | 低，但压时序 |
| `l1bad` (jalr 在 lane1) | 27,110 | 1,356 | 允许 lane1 jalr 重定向 | 中 |
| `alone` 单条包 | 25,731 | 1,287 | 前端 | —— |

注：桶之间是互斥 `else if` 瀑布，且 `ll/ls/sl/ss` 之和（427,372）大于 `memmem`（308,556），
因为 `WIN_ACCEPT` 先命中其它桶。**排序只看量级，不要把桶大小直接当收益上限。**

## 2. 为什么不做 S3（4 槽发射）

1. **供给还不够**：本轮的 `pair + single + refused` 表明前端交付约 1.7 条/拍。
   4 发射要 2.4+ 条/拍才不空转 —— 这正是 lesson 77 的教训，只是这次量更大。
2. **寄存器堆只有 2 个读口**。4 发射要 4 个读口，`u_regs` 是触发器堆（992 FF），
   加口 ≈ +880 LUT，而 v16 已估 4 发射整体要 26.6k LUT。**先把不花钱的拒绝修完再说。**
3. 单发射宽度不变的情况下修 `memmem/lduse/mduse`，预期的拍数与 4 发射的前 40% 相当，
   而面积增量是 0。

**S3 的触发条件改为**：`memmem` 与 `mduse` 修完、`ticks ≤ 175,000/迭代` 之后，
再评估 4 发射（那时它的边际收益才不会被供给吃掉）。

## 3. 本轮执行：memmem 的 `ls/sl/ss` 部分（store buffer）

### 3.1 现状

D$ 只有**一个请求端口**（`req_valid/req_write/req_addr`，store 另走 AXI-W 式
`w_valid/w_data/w_strb`），所以"一拍两个访存"物理上做不到两个 load。
但 **store 不需要读端口**：它只需要把地址+数据塞进队列，晚些时候再落地。

### 3.2 改法

1. `pair_ok` 里的 `!(lane0_mem && lane1_mem)` 改成 **`!(lane0_load && lane1_load)`**：
   允许 `ls / sl / ss`，仍然拒绝 `ll`。
2. 在核与 LSU 之间加 **2 槽 store buffer**（`rtl/core/store_buffer.v`）：
   - 核在 EX 把 store 的 addr/data/strb 推进 buffer 就算"完成"，不再等 LSU；
   - buffer 在 LSU 端口空闲时（`req_ready`）按序排出，走原来的 `req_write` + `w_*`；
   - **load 与 buffer 里未落地的 store 地址重叠时必须串行**：保守做法是
     `load 命中 buffer 的地址 ⇒ 等 buffer 排空`。CoreMark 里同地址的
     store→load 极少（`WIN_STALL mem` = 159,937/20 迭代里绝大部分是 load miss），
     所以这条保守规则几乎不花钱。
3. `ss` 需要一拍进 2 条：buffer 做 2 个写口（两个 entry 同时写），或退一步
   只支持 `ls/sl`（放弃 508 拍/迭代，60 ns 的活）。**先按 2 口做，做不动就退化。**

### 3.3 判据（按顺序，缺一不可）

| 门 | 判据 |
|---|---|
| G1 | 20 迭代仿真 `crcfinal 0x4983` 全对 |
| G2 | `Total ticks ≤ 3,720,000`（预期 3,678,640 ± 0.5%，即 ≥5.44 分）|
| G3 | ISA e2e **20/21**（case 21 基线即红）|
| G4 | halt/reset 场景 5/5 |
| G5 | 综合 LUT ≤ 22,200（当前 21,855，store buffer 预算 +350）|
| G6 | 50 MHz `--place-only` 摆放 WNS ≥ +1.0 ns（当前 +1,166 ps）|

G6 是关键：`ls/sl` 通了之后 `mem_addr` 会出现两条并行的地址通路，
容易把 EX 的地址网拉长。**过不了 G6 就回退，不接受"分数涨了但布不通"。**

## 4. 之后（不在本轮）

- **`ll` 双 load**：D$ 的 4 个字节 bank 各复制一份（DRAM 1,102 → 2,048），
  lane1 复用 lane0 的 tag 命中结果。**只支持"同一 32 B 行"**（`addr[31:5]` 相等），
  跨行仍拆两拍。预期 +9,100 拍/迭代 → 5.72。
  面积：+946 DRAM（占 19,900 的 4.8%），LUT +~300。
- **`mduse`**：lane1 从 `mul_y` 旁路，+2,050 拍/迭代 → 5.79。
- **120 MHz**：到 172,725 拍/迭代时，5.2 分的预算（192,307）余 **19,582 拍**，
  足够切 2 级流水（每刀 ≈ 4,945 重定向拍 + load-use 代价）。**这是全链条唯一走得通的位置。**
  同时必须先修掉交付版的最差路径：`w_valid` → D$ `data_mem` 的 `WADDR/WE`
  （布线 16.1 ns、23 级、82.9% 是走线）⇒ store 端口在 D$ 内部再打一拍，
  store 本来就异步，**这一刀不花 CPI**。

## 5. 三维指标的账（本轮新增，决定路线取舍）

比赛三项指标：CoreMark/MHz、最高时钟频率、**CoreMark/LUTs**。把三者一起算：

| 版本 | CoreMark/MHz | LUT | CoreMark/LUTs | 备注 |
|---|---|---|---|---|
| 交付 `board50_i2800_5p248` | 5.2484 | 17,174 | **0.0003056** | 50 MHz，WNS +0.645 |
| M1-S1+S2（本分支） | 5.2710 | 21,855 | 0.0002412（**−21%**）| 摆放 +1,166 ps |
| M1-S1+S2 + 旁路 | 5.3065 | ~21,919 | 0.0002421（**−21%**）| 摆放 **−3,651 ps**，出局 |

**结论（必须记住）**：16 B 取指这条路，**单看分数是 +0.43%，看 CoreMark/LUTs 是 −21%**。
按三项指标同时计分的赛制，它单独交付是**亏的**。v16 的 4 发射方案估 26.6k LUT、
预测 6.9 分 ⇒ 0.000259，**仍然低于现在的 0.0003056**。

所以：
1. **加宽路线只在"分数涨幅 > 面积涨幅"时成立**，即分数要涨到 6.5 以上才能抵掉 26k LUT。
   4 发射的理论值 6.9 只勉强够，而它还要再叠流水线切分（掉分），所以**大概率不划算**。
2. **真正免费的只有时钟频率**（指标 2），而它被 CPI 预算锁住：
   5.2 分 ⇒ 192,307 拍/迭代，当前 189,718，**余量 2,589**。切一刀约 +5k~+25k ⇒ **现在一刀都切不起**。
3. 因此正确顺序是 **先把拍数打到 ~170k（≈5.9 分）**，再切流水换频率。拍数来源只能是不涨面积的
   memmem/mduse/l1bad，**不是加宽**。
4. S1+S2 的价值只剩下一个：**它把配对修法的转化率从 22% 抬到 64%**（lesson 84）。
   即"先花 4.7k LUT 买供给，再用供给去换拍数"。**如果后面的拍数赚不回来这 4.7k LUT 该换的分，
   这一支线就该整体放弃、回到交付树。**

## 6. 上板状态（本轮）

22:17 / 22:18 两次（含清空残留 `cdt_*` 进程后重试），`cfg_scan_chain` 均报
`JtagServer-0306: No devices detected while scanning the JTAG chain`。
下载线能枚举、JtagServer 能起、端口 65420 能连 ⇒ **目标板未上电或 JTAG 排线未接**。
⇒ 本轮**没有新的板测数据**，板测值仍为 `board48_i2700_5p245` 的 **5.2447 @ 48 MHz**。
证据：`evidence/records/bottleneck_audit/board/board_probe_2026-10-23_2218.log`

## 7. 下一块的具体设计：`ll`（双 load，14,302 拍/迭代）

### 7.1 为什么它最划算

`ll` 要的是 **D$ 的第二读口**。D$ 数据阵列是 `data_mem_b0..b3`（4 个字节 bank，
`SETS*WAYS*LINE_WORDS = 64*2*8 = 1024` 项 × 8 bit），占 **1,102 DRAM、LUT 很少**。

**把这个阵列整份复制一份**（+1,024 DRAM，用量 1,102 → ~2,100，占 19,900 的 11%），
就有两个独立读口：读口 A 用 lane0 的地址、读口 B 用 lane1 的地址。
**DRAM 不计入 LUT ⇒ 这一刀对 CoreMark/LUTs 几乎免费**，而它换 14,302 拍/迭代。

### 7.2 只支持"同一 32 B 行"（关键简化）

两个 load 若 `addr[31:5]` 相同 ⇒ 同一个 set、同一个 way、同一 tag ⇒ **一次 tag 命中就够**，
只是 `k`（行内字偏移）不同 ⇒ 正好是"两个读地址、同一 (way,set)"，复制阵列就能同时出两个字。
`addr[31:5]` 不同则仍按今天的方式拒绝（拆两拍）。CoreMark 的 `lw a0,0(sp); lw a1,4(sp)`
一类栈访问大量落在同一行，预期能吃到大头。

### 7.3 要动的地方

| 文件 | 改动 |
|---|---|
| `dcache_axi.v` | `data_mem_b0..b3` 各复制一份（`_x2`）；读口 B 用 `req_addr2`；新增 `req_addr2`/`req_valid2`/`rsp_data2` 端口；tag 命中复用端口 A 的结果（带 `addr2[31:5]==addr1[31:5]` 校验）|
| `lsu_axi.v` | 透传第二路请求/响应；`req_ready` 增加"两路都必须命中同一行"的条件 |
| `rv32_top.v` | `pair_ok` 把 `!(lane0_mem && lane1_mem)` 细化成"允许 `ll` 但仅当 `lane0_addr[31:5]==lane1_addr[31:5]`"；`ex_value_h` 改用 `load_value_h`；`mem_wait` 等两路响应 |
| 判据 | G1 CRC 0x4983；G2 `ticks ≤ 3,630,000`（≥5.51）；G3 ISA 20/21；G5 LUT ≤ 22,100；G6 摆放 ≥ +1.0 ns |

**风险**：`lane0_addr[31:5]==lane1_addr[31:5]` 这个比较会插在 EX 的地址通路上，
而地址通路本来就在最差路径上（`mem_addr_h` → `ls_req_addr` → D$ 命中）。
⇒ **先只把比较结果用在 `pair_ok`（发射决策），不要让它串进 `req_ready` 的组合环**，
否则会闭合 `address → req_ready → mem_rsp → fwd → address`（这个环在 `lduse` 那次已经踩过）。

## 8. store buffer 第一次实现：功能骨架齐了，但**仿真死锁**（分支 `exp/sbuf`）

### 8.1 已实现的结构（代码在 `exp/sbuf`，主分支 `exp/wide4` 干净）

- 新模块 `rtl/core/store_buffer.v`：2 项移位队列，push/pop 同拍时的落位规则显式写出
  （`(!pop && !v0) || (pop && !v1) → 入口 0`，否则入口 1），因为靠赋值顺序写会**静默丢入口**。
- `pair_ok`：`!(lane0_mem && lane1_mem)` → `!(lane0_mem && lane1_mem) || (lane_dec_load && dec_store_h)`，
  **只放行 `ls`**，其余 mem+mem 仍拒绝。
- 关键正确性论证（成立，保留）：`ex_is_mem_h` 含 `!ex_is_mem`，所以 `ls` 里 lane1 的 store
  对访存握手完全不可见，`mem_wait` 只等 load；store 在 **`mem_rsp`** 那一拍才入队
  （不是发射拍），因为阵列写是沿触发、load 是同拍组合读，所以同地址也天然按程序序。
- `issue_mem` 加 `&& !sb_block`（`sb_block = !mem_issued_q && (sb_hazard || (ls_store_ex && sb_full))`）；
  `pipe_empty` 加 `&& sb_empty` 防止停在还有未落地 store 的状态。
- 输出口多路：`op_valid/is_store/address/store_value/access_size/...` 在"核自己的访问"
  与"队列 drain"之间切换，优先级给核，`sb_ack = sb_drain && !issue_mem && op_ready`。

### 8.2 症状（下次直接从这里开始）

```
CoreMark 20 迭代：vsim 停在 cycle 11,526，之后 6 分钟零进展
最后退休：0x167c  fcf81ce3   (bne，向后跳的自旋)
日志最后两行是 UART 初始化写（0x30000008 / 0x30000000）
```

**没有 CRC、没有 ticks**，是死锁不是慢。

### 8.3 下次的第一批怀疑点（按概率）

1. **`sb_hazard` 的 `chk_addr`**：用的是 `op_addr_m`（核自己的访问地址）。要确认在
   "lane1 才是访存操作"（`mem_from_h=1`）时它取的确实是 lane1 的地址，而不是 lane0 的
   `mem_addr`（`ls` 场景下 lane0 是 load，`mem_from_h=0`，但别的包会碰到）。
2. **drain 与 LSU 的事务周期**：`op_ready` 在 LSU 一个 store 事务期间会拉低若干拍，
   要确认 `sb_drain` 保持期间 `op_valid` 稳定、且 `sb_ack` 只在真正被 ack 的那一拍置起
   （现在 `sb_ack` 用 `op_ready` 而不是 `op_ready && op_valid`，多路下极可能多算一次 ack →
   入口提前消失 → 后续 load 读到旧值 → 自旋）。
3. **`ls` 包里的 load 若不是 lane0 而是"lane1 单独访存"**，`ls_store_ex` 的
   `rr_load && rr_store_h` 会用错条件。
4. 建议加 `ifdef SB_DBG`，每 1000 拍打一次
   `sb_push/sb_drain/sb_ack/sb_full/sb_hazard/sb_block/issue_mem/op_ready/mem_rsp/rr_pc`，
   一屏就能定位（这个手法在 lesson 83 里用过，很有效）。

### 8.4 结论

**结构论证是对的，实现有 bug。** 主分支保持 S1+S2（5.2710 / 21,855 LUT / CRC 0x4983 / ISA 20/21），
交付分支 `exp/pair45` 不受影响。这条继续做下去的价值仍是 5,787 拍/迭代（`ls` 桶）。

### 8.5 结果：修好之后收益是 **0** —— `ls/sl/ss` 这条线测死了

**修的 bug**：`ls_store_ex` 少了 `rr_v1`。`rr_store_h` 是独立寄存器、`rr_v1` 掉下来时保持旧值，
于是每条普通 lane0 load 都被当成 `ls`，把一条**垃圾 store**（stale addr/data/size）推进队列，
写坏了内存 → 基准在 `0x167c` 自旋不退。加上 `rr_v1` 后：**CRC 0x4983、无死锁**。

**但收益为零**：

| | S1+S2 基线 | **+ store buffer** |
|---|---|---|
| `Total ticks` | 3,794,355 | **3,794,335**（−20）|
| `ls` 被拒桶 | 115,485 | **1,095**（配对成功）|
| `pair` | 2,537,258 | **2,594,516**（+57,258）|
| `memmem` 被拒桶 | 314,098 | 199,626 |

**配对成功、桶消失、拍数不动。** 原因：store 无论走"直接发端口"还是"先入队再发端口"，
**占用 LSU 端口的周期数完全一样**（drain 用的还是同一个端口）。配对省下的是*前端*周期，
但后面的 load 立刻又在 `mem_wait` 上等同一个端口，省下的拍被原样还回去。

⇒ **`ls / sl / ss` 这三个桶（20 迭代共 141,340）不可转化为拍数**，与 lesson 77 是同一类错误：
**桶大小 ≠ 可回收拍数，要看它背后是不是"稀缺资源"**。这里稀缺资源是唯一的那条 LSU 端口，
不是配对规则。store buffer 分支 `exp/sbuf` 保留代码但**不再推进**。

**由此收缩到唯一剩下的一条**：`ll`（双 load，172,433 / 20 迭代）。它之所以不同，是因为
它要的是**第二个读口**这条真的稀缺资源（复制 D$ 字节阵列 = +1,024 DRAM、约 0 LUT），
而且它**不占额外的端口周期**——两个 load 在同一拍并行完成。
沿用 §7 的设计，但把 §7.3 的 `pair_ok` 条件改成：**在 `rr` 级用真实地址判同一行**
（`ll` 不能再靠译码期条件，§7.3 那一条是错的，见下）。

### 8.6 §7.3 的更正

`ll` 的准入条件不能用 `pair_ok`（它在**译码**级，地址还没算出来）。
可行形态有两种，选后者：
1. 在 EX 判，不同行时把 lane1 拆出来重发 —— 需要新建"EX 拆包 + 重定向到 lane1 PC"的机制，
   风险高，**放弃**。
2. **在 `rr` 级判**：`rr` 级地址已知（`mem_addr`/`mem_addr_h` 都是 `rr_*` 组合出来的），
   把"是否同 32 B 行"作为**发射条件**（不是译码条件）：
   - `pair_ok` 只加"允许 `ll`"（译码期，无条件放行）；
   - 在 `rr` 级，若 `ll && addr[31:5]` 不同 ⇒ **不发射 lane1**，只发 lane0，
     下一拍把 lane1 作为单指令发出（`lane0_issue_alone` 已有同类机制可参照）；
   - 代价：不同行的 `ll` 多 1 拍。因为同行的 `ll` 占多数，净收益仍是正的。

## 9. 拍数路线的收敛结论（2026-10-23 收尾）

### 9.1 本日实测淘汰表

| 项 | 桶（20 迭代） | 实测结果 | 判定 |
|---|---|---|---|
| `lduse` 旁路 | 159,683 | 仿真 +0.66%，但摆放 **−4.8 ns**（两棵网表一致）| **死**（lesson 85）|
| `ls/sl/ss` store buffer | 141,340 | 配对成功（`ls` 桶 115,485→1,095）、**ticks 只动 20 拍** | **死**（§8.5）|
| `mduse`（mul→lane1） | 64,171 | 同类长组合路（APM→lane1 ALU），与 `lduse` 同构 | **未做，判定死** |
| `l1bad jalr` | 29,464 | 可省真实工作，但只值 ≈940 拍/迭代（+0.03 分）| 不值 |
| `ll` 双 load | 172,433 | **前提未知**：同 32 B 行占比无法在不改 RTL 的情况下测出 | 唯一还开着的 |

**判据总结（写进 lesson 88）**：一个被拒桶能不能换成拍，取决于它背后是不是**稀缺资源**：

- `lduse`：省的是真组合依赖 → 能换拍，但换成的是**更长的路径**（摆放报销）；
- `ls/sl/ss`：省的是前端周期，**端口占用不变** → 换不到拍；
- `ll`：省的是**端口占用本身**（两 load 并行）→ 理论上能换拍，**唯一有希望的一条**。

### 9.2 `ll` 的期望值（做之前先把账算清）

`ll` = 8,622 拍/迭代（20 迭代 172,433）。即使：

- 同 32 B 行占比 60%（**未测，纯假设**）；
- 转化率沿用 64%（lesson 84）；
- 不同行的 `ll` 退化成 2 拍串行（不重定向，代价 0 额外拍）；

净收益 ≈ 8,622 × 0.60 × 0.64 ≈ **3,310 拍/迭代** ⇒ ticks 189,718 → 186,408
⇒ 分数 5.2710 → **5.365（+0.094）**，面积 +1,024 DRAM / 约 0 LUT。

**代价**：`dcache_axi` 复制 4 个字节 bank + 所有 8 处写入点、`lsu_axi` 透传第二路、
`rv32_top` 新增"rr 级同行判定 + 不同行串行"的控制器。

**结论：这是花 3 个文件的改动换 +0.09 分，并且前提（同行占比）无法先验证。**
在三维指标口径下它仍然救不了 S1+S2 树（5.365/21,900 = 0.000245，低于交付的 0.0003056）。
⇒ **建议：只有在"已经决定继续走加宽路线"时才做它；否则优先级应全部转给频率侧的结构性重构。**

### 9.3 对"5.2 分 + 120 MHz"的最终定位（本轮数据）

- **5.2 分**：当前 5.2484 @ 50 MHz（交付）。**已达成**。
- **120 MHz**：需要 8.333 ns，当前网表 19.355 ns。最差路径是
  `w_valid → CSR 读 mux → ALU → 地址加法器 → D$ hit → 阵列 WADDR(fanout=256)`，
  **整条 EX 挤在一级**，必须切 2~3 刀；每刀 +4,945 拍起，而 5.2 分的预算只剩 2,589 拍。
  ⇒ **不先把拍数打到 ~170k（≈5.9 分），120 MHz 在数学上不可能**。而 §9.1 表明
  拍数路线已基本封死（能动的只剩 `ll` 的 3,310）。**这就是当前的真实边界。**
- 唯一不动 CPI 的提频手段是"把 store 写地址/WE 在 D$ 内部打一拍"（store 是 posted），
  但它只削掉路径尾部约 4.6 ns（22.1 → 17.4，约 57 MHz），**到不了 120**。

## 10. 频率侧：把最差路径按"可切段"拆开（本轮新增，下一块该做这个）

交付版（50 MHz）最差路径的原始明细已经被逐跳读过了（`p48e-board50/report_timing.rtr`）。
按**逻辑段**归并，并把每一段的耗时算出来：

| 段 | 起止 | 累计 ns | 段耗 | 能不能免费切 |
|---|---|---|---|---|
| ① 时钟树到 `w_valid` | CLK → `w_valid/CR0` | 2.85 | 0.25 | —— |
| ② **`w_valid` → CSR 读 mux → `alu_a`** | `w_valid` → `N639` → `csr/read_data_16/24/31` → `N232_119(muxf7)` → `alu_a[24]` | 2.85 → 8.14 | **5.30 ns** | **能（见下）** |
| ③ ALU 4 级 | `u_alu/N16_1 → N16_2 → y_21 → y_29` | 8.14 → 11.45 | 3.31 | 不能（真运算）|
| ④ `fwd1_h` → 地址加法器 → `ls_req_addr` | `N343_126` → `N450_8/9` → `ar_addr_q` | 11.45 → 14.61 | 3.16 | 需要切 RD/EX |
| ⑤ D$ 查找：`N30` 选择 → `hit_any` → 状态 → `N4031/4032` | 14.61 → 19.50 | 4.89 | 需要 MEM1 级 |
| ⑥ **阵列写地址 `N4033[0]`（fanout=256）** | 19.50 → 22.08 | **2.58** | **能（store 是 posted）** |

### 10.1 为什么 ② 是免费的（最高优先级）

CSR 文件的读地址是这么接的：

```verilog
.addr(w_valid && w_csr ? w_csr_addr : id_csr_addr)
```

一个读口同时服务"ID 级正在译码的 CSR 指令"和"WB 级正在提交的 CSR 指令"，
于是 `w_valid` 这个**第 2.85 ns 的寄存器**直接坐在最差路径的头部，后面串了
4 个 mux 级才到 `alu_a`。

**但 CSR 指令是串行的**（`serial_q` / `w_serial`）：一条 CSR 在 WB 时，另一条 CSR 不可能在 EX。
所以 EX 要读的那个地址**永远是 `id_csr_addr`**；`w_*` 那一路只是 WB 自己的回写需要。
⇒ 把 WB 需要的那份读数据**在 M 级登记一次**（`csr_rdata_m_q`，32 FF），
读地址就只剩 `id_csr_addr`，**`w_valid` 从路径头部消失，段 ② 的 5.3 ns 里至少去掉 2~3 ns**。
零 CPI 代价（CSR 指令占比极低），面积 +32 FF。

### 10.2 ⑥ 也是免费的

`N4033[0]` 是**阵列写地址的最低位**，fanout=256（4 个字节 bank × 64 set × 2 way 的块共享它），
单这一根网线 2.5 ns。而驱动它的东西在 EX 的组合锥里。
**store 是 posted 的**：把写地址/写使能在 D$ 内部打一拍（`sw_addr_q`/`sw_we_q` + 数据拍），
store 的完成时刻不变（它本来就要等 B 响应），**CPI 不变**，而这 2.58 ns 直接从路径上消失。
⚠️ 前提：同拍"store → 后续 load 同一字"必须仍然正确。D$ 已有的 STQ 保证了
store 落地顺序，但**必须实测**（用 CoreMark CRC + ISA 20/21 判）。

### 10.3 合起来的预期

② + ⑥ 两刀 ≈ **5~6 ns**，最差路径 22.08 → ~16.5 ns（≈60 MHz），**CPI 一分不花**。
这比"切流水换频率"划算得多——切流水每刀要付 ≥4,945 拍，而 5.2 的预算只剩 2,589。
再往上（到 8.33 ns）仍然必须切 ③/④/⑤，那时才需要 CPI 预算。

**⇒ 下一块的工作顺序改为：② CSR 读口解耦 → 量 `--place-only` → ⑥ D$ 写口打拍 →
量 `--place-only` → 若 WNS 允许，试 55 / 60 MHz 档位（单时钟、不要鞭子，lesson 82）。**

## 12. 切② 实测关闭（2026-10-23，分支 `exp/csr`）

按 §11 实施后，两处改动**都**被 ISA 归回否掉，原因是两个此前没看到的语义依赖：

| 改动 | 结果 | 原因 |
|---|---|---|
| `.addr(id_csr_addr)`（读口只接 ID）| ISA **11/21** | **`csr_native` 的 `.addr()` 同时是写地址**：`commit = w_commit && w_csr`、`write_data = csr_new`，改成 ID 地址后**每条 CSR 写都写到了 ID 那条指令的 CSR 上**。挂 case 6~11/15/19/20 |
| `wb_value = w_csr ? w_csr_old : w_value` | ISA **19/21**（新挂 case 6）| **WB 重读 CSR 是必需的**：`w_csr_old` 在 ID→RR 沿采样时，`csr_rdata` 的地址被 WB 那一路 mux 过，两者并不等价 |

两次都保持 `ticks 3,810,700 逐位不变`、`crcfinal 0x4983`——**CoreMark 抓不到这类错**（它只在启动时碰 CSR），
只有 ISA e2e 能抓到。**这条再次证明：`ticks` 不变 + CRC 对 ≠ 功能正确。**

### 12.1 结论与替代

**切② 关闭。** 要走这条路必须先给 `csr_native` 拆出**独立的读地址与写地址**（现在同一个 `addr`），
那是接口改动而不是"两行"；拆完之后 `wb_value` 才能改成读寄存值。**性价比不明，暂不做。**

⇒ 频率侧只剩 **⑥（D$ 阵列写地址/写使能在 cache 内部打一拍，2.58 ns，零 CPI）** 这一刀是安全的，
它不涉及 CSR/寄存器堆的任何语义。下一轮从它开始，判据顺序不变：
`ticks 逐位不变` → **ISA 20/21**（不是 19/21）→ `--place-only` WNS。
