licardlu/pangoriscv/docs/HANDOFF-2026-10-22.md

# 交接文档（HANDOFF）— pangoriscv / 紫光同创 RISC-V 赛题

> 写于 2026-10-22 19:00，供**下一个接手的 AI** 读。读完本文 + `docs/plan-score-5.2-120mhz-v9.md`
> + `docs/lessons/mistakes-log.md` §46–49 即可接手，不需要回溯对话记录。

---

## 1. 一句话现状

**5.2 分已板上实测达成（5.213 CoreMark/MHz @ 36 MHz，五项 CRC 全对）；120 MHz 未达成
（当前 fmax ≈ 40.6 MHz），是唯一硬缺口。** 分数目标和频率目标在本 RTL 上互相拉扯
（冲 120 要拆流水级，CPI 惩罚会把分数打到 5.10 击穿 5.2）。

## 2. 已交付（都在 git 里，提交号可信）

| 项 | 值 | 出处 |
|---|---|---|
| CoreMark/MHz（板上实测） | **5.213** | `evidence/records/optimization/p13-board-verify/`，UART 原文 `board_uart_capture.txt` |
| 板测运行条件 | 36 MHz（PLL 27×56/42）、2000 迭代、实跑 10.66 s ≥ 10 s | 同上 |
| 五项 CRC | 全对，`Correct operation validated` | 同上 |
| 交付位流 | `bitstream/pangoriscv_board36_i2000.sbit`（SHA256 在 evidence） | 提交 9c38f5b |
| 资源（同源位流 device_map） | LUT 17,869（27%）/ FF 7,823 / LUTRAM 3,790 / DRM 8 / APM 10 | 0.292 CM/kLUT |
| 时序（40 MHz 约束分析构建 p13seed7） | **All Constraints Met**，setup WNS +0.558 ns，估计 fmax 40.56 MHz（路径 24.65 ns） | evidence 同目录 .rtr |
| 遗留 hold | 交付位流 hold 3 端点 −0.035 ns（data_ram aw_addr→WADDR，2028 扇出跨列偏斜）；板上实测不受影响 | 已在 measurement.md 注明 |

**三项指标口径**（skill 要求同源）：分数 5.213（板上 ticks）/ 频率 36 MHz 板测 +
40 MHz All-Met 分析 / LUT 17,869。不要混用不同构建的数字。

## 3. 120 MHz：为什么没到、差距多少

- 实测关键路径 **24.65 ns**（要 8.33 ns，差 3 倍）：Logic 仅 4.23 ns（17.5%），
  **Route 19.89 ns（82.5%）**，27 级逻辑。
- 路径链（p13seed7 `.rtr`）：`rr_rs1 → ALU → mem_addr 加法 → dcache early_req →
  mem_wait → hold_ex 门 → redirect_valid → ifu if_req_addr → I$ tag 读 → hit0 →
  fanout 159 → I$ data 读 → mux → rsp_data_hi_q`，横跨 cpu/dcache/ifu/icache 四模块。
- 120 MHz place-only 摆放 WNS **−10.4 ~ −11 ns**（收窄 y 带的 floorplan v2 更差，
  −10,998 ps，已否）。
- **数学账**：拆流水级（P14 方案）分支惩罚 +88k ticks，折算分数 **5.10 < 5.2**。
  不拆 CPI 的刀（S1 已做完）救不了 3 倍的路径差距。**两者兼得需要重构级更深的
  乱序/预取或换微架构，不是调参能到的。** 下一个 AI 若继续冲 120，必须先想清楚
  CPI 预算（现预算只剩 0.25%）。

## 4. S1 已落地（ff37737）：I$ 数据阵列按 way 拆分

even_mem/odd_mem(512×32) → even_w0/even_w1/odd_w0/odd_w1(256×32)。命中路径无条件
并行读两路，hit0 只做输出级 mux（原先 tag 比较串在数据读前面）。**零 CPI、Δ面积 0**。
回归全绿：icache 单测 1/1、CoreMark 20it `Total ticks 3,833,976` 与 p12 逐位一致、
CRC 五项全对。ISA e2e 20/21（case 21 红是探针口径问题，基线即红，见 plan v2 §19.7）。

## 5. 可布性配方（P13 的"钥匙"，必读）

```
run_pds_flow.py --mode full --plain-pnr \
  --pnr-extra "-gplace_seed N -plc_decongestion 1 -share_router_control_signal TRUE"
```

- **详细布线收不收敛，主要由 placement seed 决定**（震荡=拥塞、单调下降=在收敛）。
  126 MHz 净表 seed 7 通；36 MHz 净表 seed 3 通。**换 PLL/RTL 后必须重抽 seed**
  （多开几个 seed 并行跑，看谁先到 0）。
- `--plain-pnr` 是诊断工具（去掉 hold 修复参数以分离"hold 空转"假设），**交付要带
  hold 参数**（p13board36h 配方：seed + 交付 hold 参数叠加）。
- `-number_of_router_thread` 本器件不支持（Flow-0182）；位流命令是 `gen_bit_stream`
  不是 `bit_gen`（mistakes-log §49）。

## 6. 模块化布线（区域约束）现状

- **坐标系**：`def_region` 合法域 **x∈[0,122]、y∈[0,203]**（x≥118 时 y≤199），两轮探针钉死。
  show_device 名字、报告网格名、floorplan 坐标是**三套编号**，勿混用。
- **通道结论**：PCF `def_inst_region` 会让 pnr 15 秒内空错误退出（隔离实验证实，
  任一绑定都崩）→ **只能走 FDC 的 `PAP_REGION`**（`define_attribute {i:...}{PAP_REGION}{...}`，
  现成文件 `firmware/code/platform/pango_native/pango_native_floorplan.fdc`）。
  Tcl 语法坑：大括号后不能直接跟 `[CLMA,CLMS]`。
- **效果实测**：区域约束把布线尾部从 2.2k 压到 1.2k 但单独不收；收窄 y 带（v2）是
  **负优化**（摆放 WNS 反而 −0.6 ns、seed 7 从收敛变震荡）→ v3 已回退全高 y 带。
  当前 27% 利用率下，区域约束对时序收益有限，**别再花大时间在这上面**。

## 7. 下一步建议（按性价比排序）

1. **保住 5.213 交付**（已完成，勿破坏）：核心 RTL 动刀前必跑 CoreMark 20it
   仿真对 `Total ticks`（基线 3,833,976）与 CRC 五项，ticks 变差 >0.5% 回退。
2. 若继续冲频率：先做**扇出复制**（`rr_rs1` 扇出 44、`_N82` 159、`redirect_valid` 61），
   零 CPI，压 Route 那 82.5%；然后 seed 抽签重测 fmax。
3. 120 MHz 需要 P14 拆流水线时，**先算 CPI 折算表**写进计划书再动手（v8 里有旧表）。
4. 任何新位流要报分 → 必须重走板上验证链（见 §8）。
5. hold 3 端点 −0.035 ns 可试 `data_ram` 写地址总线寄存复制（同族慢性路径）。

## 8. 板上验证链（照抄可用）

1. JTAG server：`pds/.../bin/cdt_js.exe`（端口看它 stdout "use port : N"）。
2. 烧写：`cdt_cfg.exe -file 01b_program_only.tcl`（环境变量 `PANGO_SBIT` / `PANGO_JTAG_PORT`，
   脚本在 `evidence/records/bottleneck_audit/board/`）。
3. **UART 必须先开后烧**（CoreMark 报告只打一次）：`capture_uart.ps1 -Port COM34`，
   PowerShell 要 `-ExecutionPolicy Bypass`。
4. 核对：`Total ticks` / 五项 CRC / `Correct operation validated`；分数只用 ticks
   反推（`Iterations×1e6/Total ticks`），不用整数截断的 Iterations/Sec。

## 9. 关键文件地图

| 文件 | 用途 |
|---|---|
| `docs/plan-score-5.2-120mhz-v9.md` | 当前计划书（含实测记录表、S1/S2 A/B 结论） |
| `docs/plan-score-5.2-120mhz-v8.md` | 上一轮计划（布线攻坚战报、上板链路、P14 折算表） |
| `docs/lessons/mistakes-log.md` §46–49 | 本轮错误经验（区域约束通道/三套坐标/布线震荡判据/工具坑） |
| `evidence/records/optimization/p13-board-verify/` | 板上实测全套证据 |
| `firmware/code/tools/run_pds_flow.py` | P&R 一键流（--plain-pnr/--pnr-extra/--floorplan/--place-only） |
| `firmware/code/platform/pango_native/pango_native_floorplan.fdc` | 模块化布线 v3（FDC 通道） |
| `docs/architecture/module-area-plan.md` | 模块卡片（动 RTL 前先改卡，doc-before-code） |

## 10. 铁律（skill + 本项目教训）

- 迭代数必须让板测 **≥10 s**；五项 CRC 全对才算数；**最终必须上板**。
- 动核心 RTL：先跑仿真对 ticks/CRC，再跑 `check_area_budget.py` 门禁。
- 分数/频率/资源三项必须出自**同一份位流**。
- 文档先行：改模块先改 module-area-plan 卡片。
- 报告里的"successfully"不算数，以 log 里 `E:`/`failed` 行为准。
