licardlu/pangoriscv/docs/plan-perf-3.6.md

# 性能计划：3.4222 → ≥3.60（P34：D-Cache posted store 队列）

日期：2026-10-21
起点：tag `score-3.4222-area`（LUT 18,006 / FF 9,877 / S 31,511，板上 3.4222，11.082 s，五项 CRC 全对）
本轮性质：**性能专项**（面积专项已定版）。面积只允许本轮这一处受控增量，其余仍守"只减不增"。

---

## 0. 目标与验收（缺一不可）

| 项 | 验收标准 |
|---|---|
| ① CoreMark/MHz | **≥ 3.60**，同一份位流、板上实测、1024 迭代、`Total time ≥ 10 s`、五项 CRC 全对 |
| ② 频率 | 27 MHz 约束下 `All Constraints Met`、失败端点 0、**hold 取 `multiseed_summary.csv` 的收尾值且 > 0** |
| ③ 资源 | LUT/FF/LUTRAM 取自**该位流**的 `device_map` `Used` 行，并报 CoreMark/kLUT |
| ④ 位流可跑 | 构建目录内有 `program.hex`/`data.hex`，综合日志有 **2 条** `Loading memory data from file`，无 `Cannot open specified data file` |
| ⑤ 证据 | `evidence/records/optimization/perf-store-fifo/` 一个实现一个目录（报告+日志+SHA256+串口原文） |

**换算**：3.4222 → 3.60 需 ticks 降 **4.94%**（299,226,614 → ≤284,500,000）。
本方案预期 −7.8%（≈3.70），留 2.5 个百分点余量。

---

## 1. 已测事实（20 迭代 A/B，评分窗口 5,843,953 周期 / 5,782,437 条）

| 项 | 数值 | 占比 |
|---|---:|---:|
| 有退休周期 | 4,435,496 | 75.9% |
| 无退休周期 | 1,408,456 | 24.1% |
| ├ store 占 EX 停顿 | **593,975** | **10.2%** |
| ├ load 占 EX 停顿 | 109,941 | 1.9% |
| └ 其余（重定向/前端/div） | ≈704,540 | 12.1% |
| 配对退休 | 1,346,942 | 占退休周期 30.4% |

**store 停顿的根因（已证实，不是推断）**：
`ST_REFUSE` 共 451,981 次拒绝，其中 **451,958 次（99.99%）是 `ST_WR_DRAIN + hold_valid`**
——D-Cache 只有一级 posted store buffer，上一笔还在等 AXI B（约 7.6 拍/笔）时它已满，第三笔只能被拒。
不是状态窗口（wrreq=0/wrresp=0）、不是读缺失（rd=0）、不是 MMIO（other=23）。

**配对被拒 2,457,231 周期的分桶**（决定"为什么先不改流水"）：

| 原因 | 周期 | 占比 | 为什么本轮不动 |
|---|---:|---:|---|
| RAW（lane0 写、lane1 读） | 896,708 | 36% | 要 EX→EX 内部旁路（两级 ALU 串联），改流水 + 时序风险高 |
| lane1 非 ALU/分支 | 665,343 | 27% | 多为 load/store 在 lane1 → 要第二访存口或记分板，属换架构 |
| lane0 非 ALU/访存 | 501,178 | 20% | 分支在 lane0 要"预测不跳+跳则冲刷"，正确性风险高 |
| WAW（两槽写同一 rd） | 210,181 | 8.5% | **低风险备选**，见 §6 |
| 不相邻 | 183,821 | 7.5% | 结构性，不可消 |

前端供给**不是**瓶颈：IFU 队列 91% 的周期占用 ≥2 项，`starve` 仅 446,939 且多数与重定向同拍。

---

## 2. 方案：P34 —— posted store 队列（只在 `dcache_axi` 一个模块内）

### 2.1 为什么不选别的
store 这项是**唯一**同时满足"收益 10.2%、只动一个模块、不改变任何完成语义"的改动。
四条被排除的路线（RAW 旁路 / lane1 访存 / lane0 分支 / 写响应不等 B）都要改流水或异常模型，
而其中"写响应不等 B"已被 P19–P32 六次失败证明是架构级改动。
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
