licardlu/pangoriscv/evidence/records/baseline/contest-page-1.png

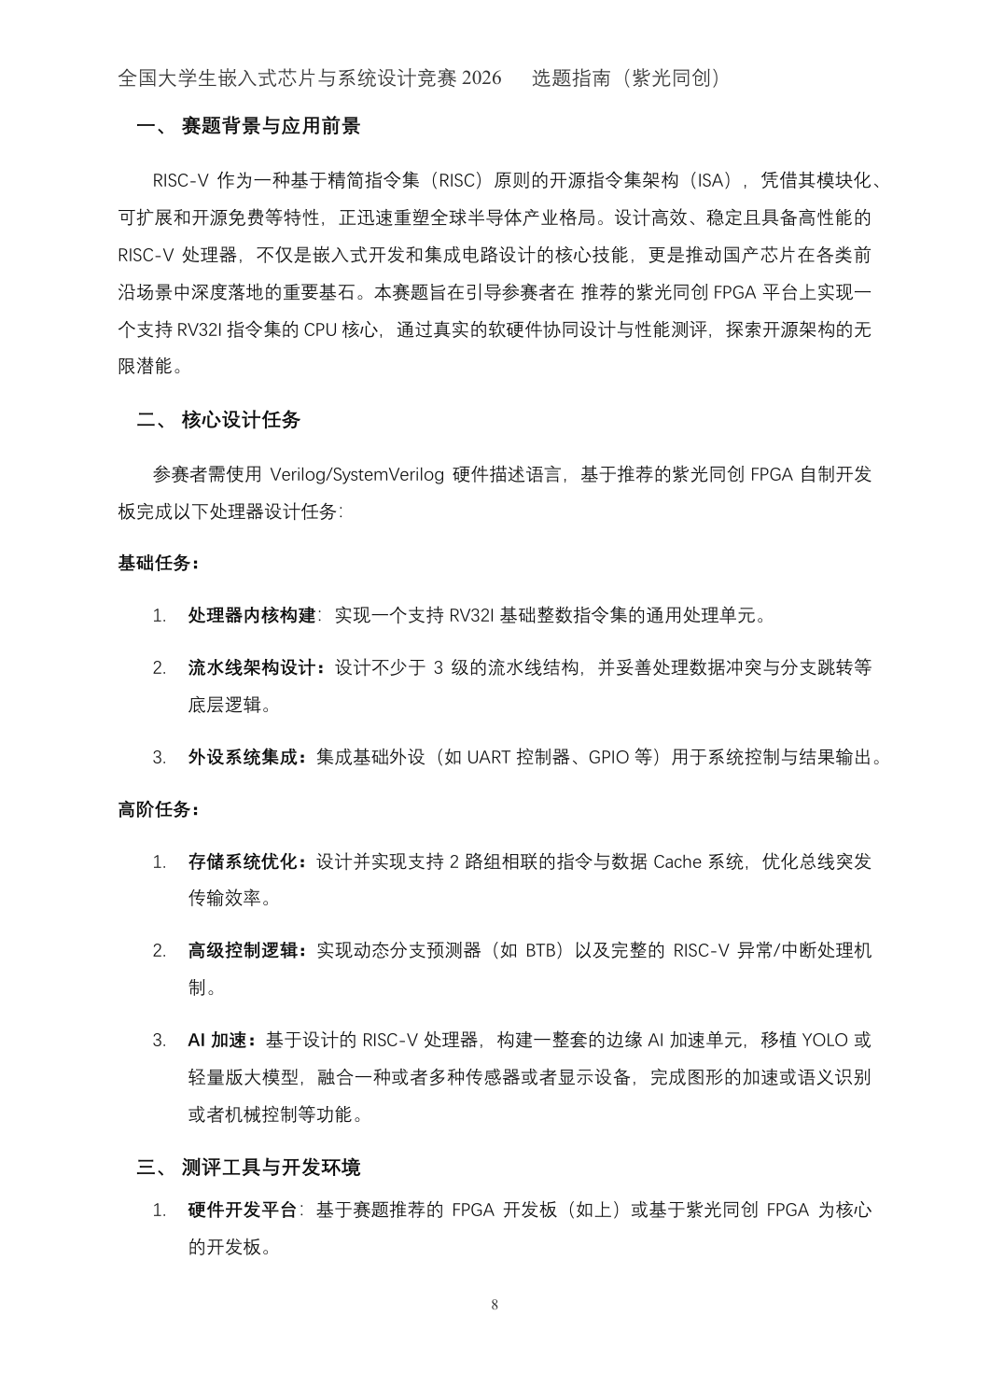
evidence/records/baseline/contest-page-1.png
