licardlu/pangoriscv/evidence/records/baseline/contest-page-2.png

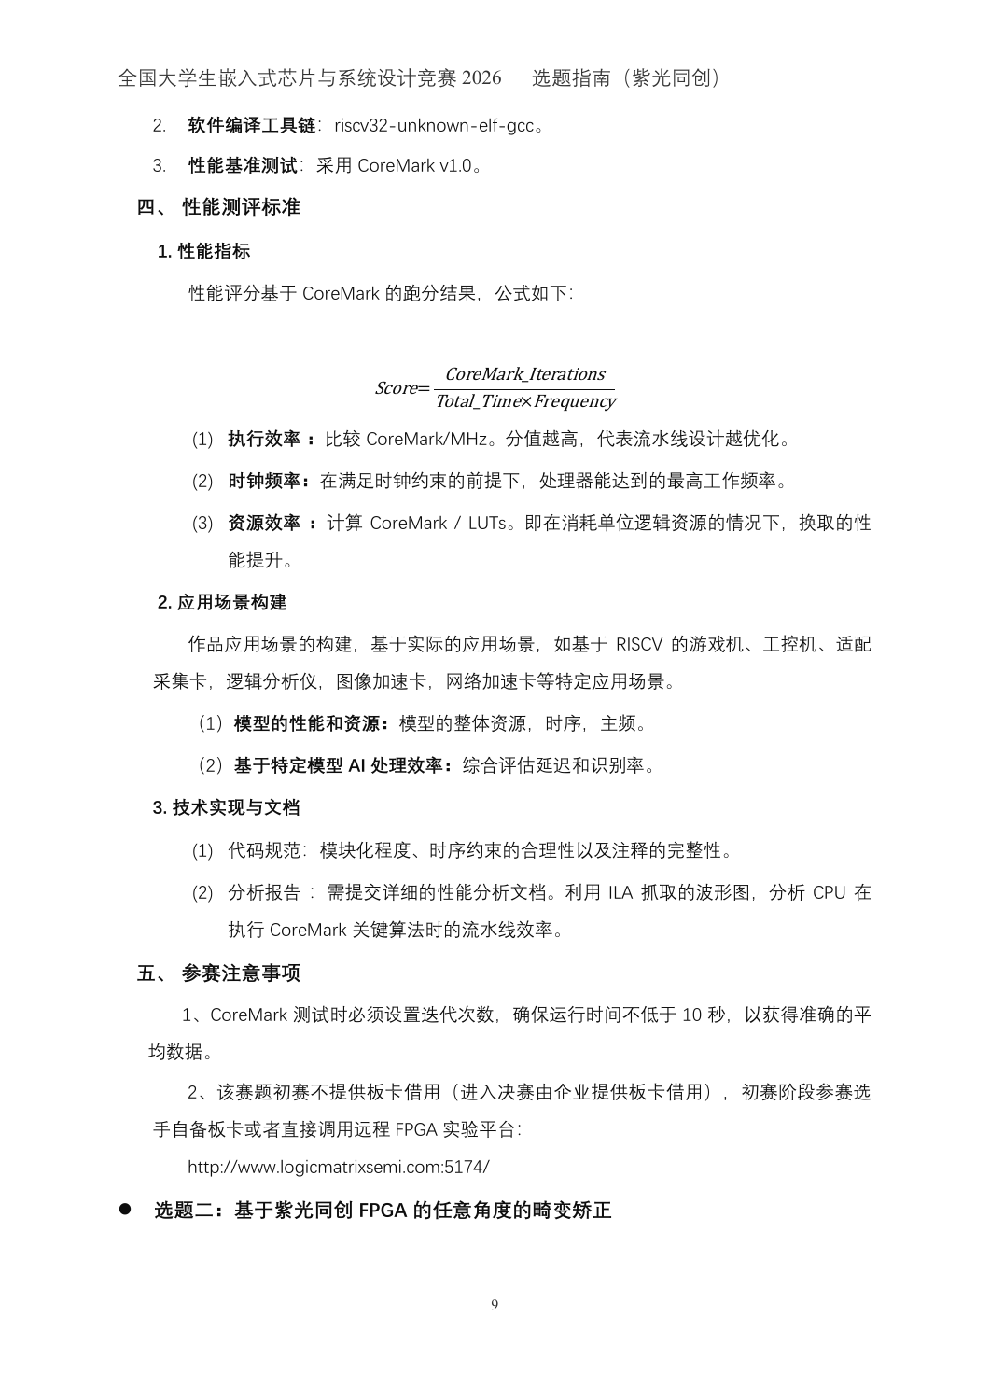
evidence/records/baseline/contest-page-2.png
