licardlu/pangoriscv/evidence/records/optimization/yolo120/video-002/synthetic_video.png

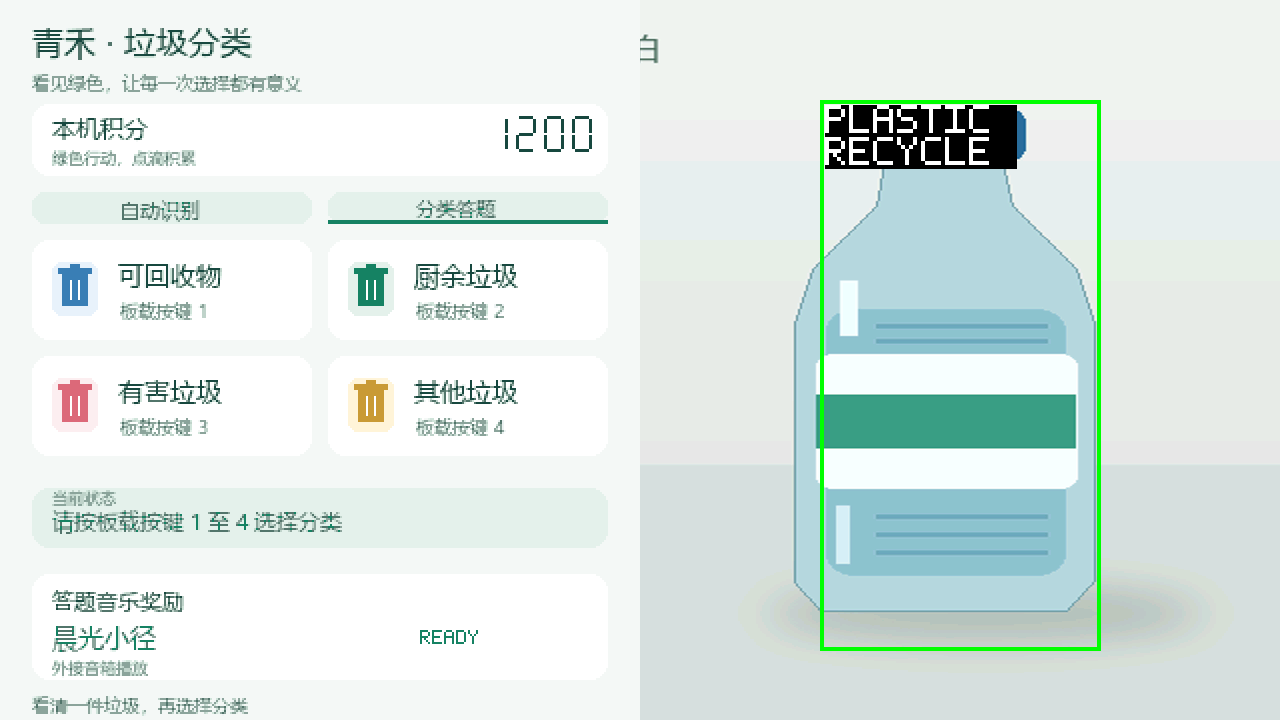
evidence/records/optimization/yolo120/video-002/synthetic_video.png
