licardlu/pangoriscv/extensions/ui_reference/extensions/business/application/assets/摄像头仿真输入.png

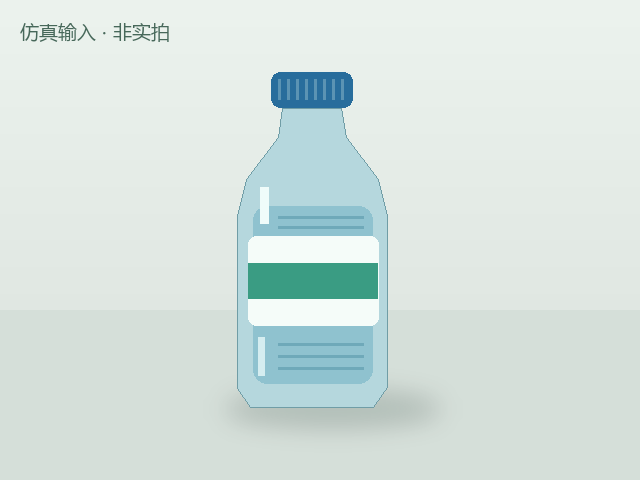
extensions/ui_reference/extensions/business/application/assets/摄像头仿真输入.png
