licardlu/pangoriscv/project/trash_sorting/source/extensions/business/application/assets/ui_light_preview.png

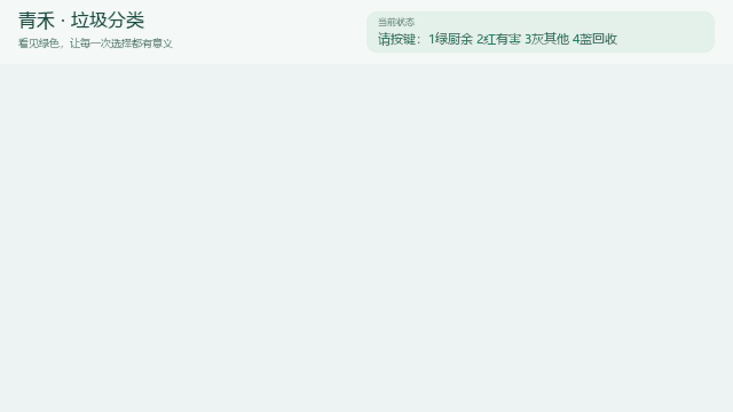
project/trash_sorting/source/extensions/business/application/assets/ui_light_preview.png
