licardlu/pangoriscv/project/trash_sorting/source/extensions/business/application/assets/白色布局_实时视频链路_RTL仿真.png

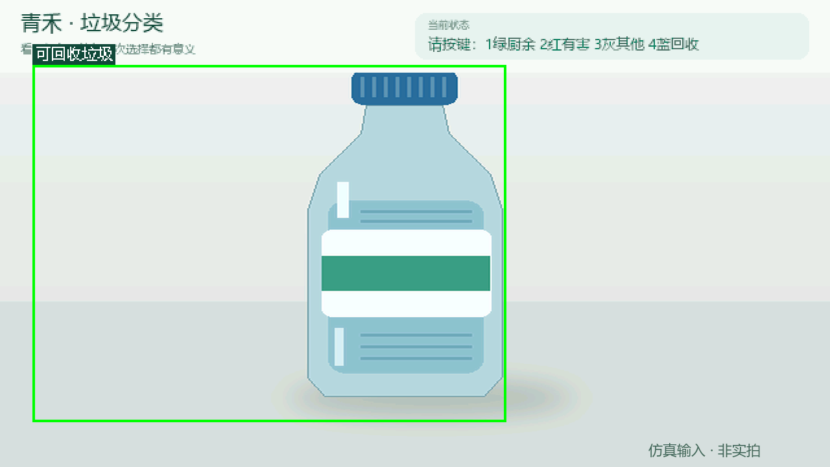
project/trash_sorting/source/extensions/business/application/assets/白色布局_实时视频链路_RTL仿真.png
