licardlu/pangoriscv/(list of files, cad)

Other CAD files:
build/board120/place_route/pango_vexii_top_prr.prt
build/replica_pds/run-022/place_route/pango_cpu_top_prr.prt
