licardlu/pangoriscv/build/board120/multiseed_summary.csv

version,2022.2-SP6.1<build 138931>
project name,pango_vexii.pds
Single Seed:
Seed,State,Convergence,Setup(Slow),Setup(Fast),Hold(Slow),Hold(Fast),Recovery(Slow),Recovery(Fast),Removal(Slow),Removal(Fast),PBM-GP,PBM-PreGP,PBM-PostGP,LP,Total Placement Cpu Time,Detailed routing,Total Routing Cpu Time,Wire Length After Post-GP,Wire Length After LP,Wire Length After DP,Routing Arc Length,Worst Slack After GP Timing,Worst Slack After LP Timing,Worst Slack Before RP,Worst Slack Before DP,Worst Slack After DP,Worst Slack After Placement,Worst Slack After TA By Preroute,TNS After DP,TNS Before Route,Setup(Slow) Total Failing TNS,Setup(Slow) Total Failing Endpoints,Hold(Slow) Total Failing THS,Hold(Slow) Total Failing Endpoints,Power
single,OK,Fail,-1.604,2.219,0.022,0.013,5.147,6.263,0.354,0.250,NA,NA,NA,1.08,117.75,210.39,232.44,NA,NA,NA,183987,NA,NA,-2634,-2377,179,177,NA,0,0,-240.318,829,0.000,0,NA
Pass Rate/Convergence Rate,100.00%,0.00%
Synthesize:
control_set,184
Synthesize Performance Summary:
slack category,Synthesize Setup WNS,Synthesize Setup TNS,Synthesize Recovery WNS,Synthesize Recovery TNS
slack value,-0.868,-9.343,6.195,0.000
Synthesize Process Cpu Time,0h:1m:10s
Device Map:
Device Map Resource Usage Summary:
Logic Utilization,LUT,FF,DRM,APM,Distributed RAM,HSSTHP,USCM,HCKB,RCKB
Used,8841,6658,34,5,72,NA,1,0,0
Available,66600,133200,155,240,19900,NA,32,96,24
Utilization(%),14%,5%,22%,3%,1%,NA,4%,0%,0%
Device Map Process Cpu Time,0h:0m:15s
Project Configurations:
top module,pango_vexii_top
compile," -top_module {pango_vexii_top} "
synthesize," -ads "
device map,
place & route," -fix_hold_violation_iterations 50
 -fix_hold_violation_threshold_for_clock_path_cross_srb 0
 -fix_hold_violation_threshold_for_clk_tree 0 "
Test Parameters Configurations:
testparam,
