licardlu/pangoriscv/build/replica_pds/run-022/multiseed_summary.csv

version,2022.2-SP6.1<build 138931>
project name,build_seed.pds
Single Seed:
Seed,State,Convergence,Setup(Slow),Setup(Fast),Hold(Slow),Hold(Fast),Recovery(Slow),Recovery(Fast),Removal(Slow),Removal(Fast),PBM-GP,PBM-PreGP,PBM-PostGP,LP,Total Placement Cpu Time,Detailed routing,Total Routing Cpu Time,Wire Length After Post-GP,Wire Length After LP,Wire Length After DP,Routing Arc Length,Worst Slack After GP Timing,Worst Slack After LP Timing,Worst Slack Before RP,Worst Slack Before DP,Worst Slack After DP,Worst Slack After Placement,Worst Slack After TA By Preroute,TNS After DP,TNS Before Route,Setup(Slow) Total Failing TNS,Setup(Slow) Total Failing Endpoints,Hold(Slow) Total Failing THS,Hold(Slow) Total Failing Endpoints,Power
single,OK,OK,0.323,4.646,0.018,0.012,NA,NA,NA,NA,NA,NA,NA,0.58,33.92,83.64,103.14,NA,NA,NA,153290,NA,NA,692,692,1515,1515,NA,0,0,0.000,0,0.000,0,NA
Pass Rate/Convergence Rate,100.00%,100.00%
Synthesize:
control_set,80
Synthesize Performance Summary:
slack category,Synthesize Setup WNS,Synthesize Setup TNS,Synthesize Recovery WNS,Synthesize Recovery TNS
slack value,1.233,0.000,NA,NA
Synthesize Process Cpu Time,0h:0m:43s
Device Map:
Device Map Resource Usage Summary:
Logic Utilization,LUT,FF,DRM,APM,Distributed RAM,HSSTHP,USCM,HCKB,RCKB
Used,8139,3548,32,4,200,NA,1,0,0
Available,66600,133200,155,240,19900,NA,32,96,24
Utilization(%),13%,3%,21%,2%,2%,NA,4%,0%,0%
Device Map Process Cpu Time,0h:0m:12s
Project Configurations:
top module,pango_cpu_top
compile," -top_module {pango_cpu_top} "
synthesize," -ads "
device map,
place & route," -gplace_seed 2
 -fix_hold_violation_iterations 50
 -fix_hold_violation_threshold_for_clock_path_cross_srb 0
 -fix_hold_violation_threshold_for_clk_tree 0 "
Test Parameters Configurations:
testparam,
