licardlu/pangoriscv/evidence/records/cleanup_20261103/build_reports/project/yolo120/build/hdmi-scan-001/multiseed_summary.csv

version,2022.2-SP6.1<build 138931>
project name,flow.pds
Single Seed:
Seed,State,Convergence,Setup(Slow),Setup(Fast),Hold(Slow),Hold(Fast),Recovery(Slow),Recovery(Fast),Removal(Slow),Removal(Fast),PBM-GP,PBM-PreGP,PBM-PostGP,LP,Total Placement Cpu Time,Detailed routing,Total Routing Cpu Time,Wire Length After Post-GP,Wire Length After LP,Wire Length After DP,Routing Arc Length,Worst Slack After GP Timing,Worst Slack After LP Timing,Worst Slack Before RP,Worst Slack Before DP,Worst Slack After DP,Worst Slack After Placement,Worst Slack After TA By Preroute,TNS After DP,TNS Before Route,Setup(Slow) Total Failing TNS,Setup(Slow) Total Failing Endpoints,Hold(Slow) Total Failing THS,Hold(Slow) Total Failing Endpoints,Power
single,OK,OK,10.456,11.667,0.201,0.147,NA,NA,NA,NA,NA,NA,NA,0.08,4.11,0.38,6.67,NA,NA,NA,5658,NA,NA,11141,11141,11141,11141,NA,0,0,0.000,0,0.000,0,NA
Pass Rate/Convergence Rate,100.00%,100.00%
Synthesize:
control_set,31
Synthesize Performance Summary:
slack category,Synthesize Setup WNS,Synthesize Setup TNS,Synthesize Recovery WNS,Synthesize Recovery TNS
slack value,10.325,0.000,NA,NA
Synthesize Process Cpu Time,0h:0m:9s
Device Map:
Device Map Resource Usage Summary:
Logic Utilization,LUT,FF,DRM,APM,Distributed RAM,HSSTHP,USCM,HCKB,RCKB
Used,467,555,0.5,0,0,NA,3,0,0
Available,66600,133200,155,240,19900,NA,32,96,24
Utilization(%),1%,1%,1%,0%,0%,NA,10%,0%,0%
Device Map Process Cpu Time,0h:0m:8s
Project Configurations:
top module,hdmi_startup_top
compile," -top_module {hdmi_startup_top}
 -include_path {D:/FPGA_Project/zi_guang_tong_chuang/pangoriscv/project/yolo120/build/hdmi-scan-001/sources} "
synthesize," -ads "
device map,
place & route," -gplace_seed 2
 -groute_seed 2
 -fix_hold_violation_iterations 100 "
Test Parameters Configurations:
testparam,
