licardlu/pangoriscv/evidence/records/cleanup_20261103/build_reports/project/yolo120/build/region-probe-001/multiseed_summary.csv

version,2022.2-SP6.1<build 138931>
project name,flow.pds
Single Seed:
Seed,State,Convergence,Setup(Slow),Setup(Fast),Hold(Slow),Hold(Fast),Recovery(Slow),Recovery(Fast),Removal(Slow),Removal(Fast),PBM-GP,PBM-PreGP,PBM-PostGP,LP,Total Placement Cpu Time,Detailed routing,Total Routing Cpu Time,Wire Length After Post-GP,Wire Length After LP,Wire Length After DP,Routing Arc Length,Worst Slack After GP Timing,Worst Slack After LP Timing,Worst Slack Before RP,Worst Slack Before DP,Worst Slack After DP,Worst Slack After Placement,Worst Slack After TA By Preroute,TNS After DP,TNS Before Route,Setup(Slow) Total Failing TNS,Setup(Slow) Total Failing Endpoints,Hold(Slow) Total Failing THS,Hold(Slow) Total Failing Endpoints,Power
single,NA,NA,NA,NA,NA,NA,NA,NA,NA,NA,NA,NA,NA,NA,NA,NA,NA,NA,NA,NA,NA,NA,NA,NA,NA,NA,NA,NA,NA,NA,NA,NA,NA,NA,NA
Pass Rate/Convergence Rate,0.00%,0.00%
Synthesize:
control_set,NA
Synthesize Performance Summary:
slack category,Synthesize Setup WNS,Synthesize Setup TNS,Synthesize Recovery WNS,Synthesize Recovery TNS
slack value,NA,NA,NA,NA
Synthesize Process Cpu Time,0h:0m:6s
Device Map:
Device Map Resource Usage Summary:
Logic Utilization,LUT,FF,DRM,APM,Distributed RAM,HSSTHP,USCM,HCKB,RCKB
Used,NA,NA,NA,NA,NA,NA,NA,NA,NA
Available,NA,NA,NA,NA,NA,NA,NA,NA,NA
Utilization(%),NA,NA,NA,NA,NA,NA,NA,NA,NA
Device Map Process Cpu Time,NA
Project Configurations:
top module,probe
compile," -top_module {probe} "
synthesize," -ads "
device map,
place & route," -place_only "
Test Parameters Configurations:
testparam,
