licardlu/pangoriscv/evidence/records/optimization/yolo120/hdmi-startup-001/area_usage_extracted.csv

Logic Utilization | APM | FF | LUT | Distributed RAM | DRM | IO
hdmi-startup-001 | 0 | 526 | 436 | 0 | 0.5 | 33
