licardlu/pangoriscv/evidence/records/bottleneck_audit/baseline_build/provenance/baseline_src_sha256.tsv

docs\evidence\platform\counter_led.v | 1078 | E839E2AE487A8306AE5924C2C532DFA1E6A4BBB3208C68D011152AFFB94DBD89
LICENSE | 1071 | ECD06447DA6AF9BCC3543D991F1E6B51C553661F428BF021D92C84DC5DF03950
platform\pango_native\base_project.pds | 8923 | 046CFADA987C24B58293996B90FFFEB285FD9BF44BC88ED89060560BAFD80620
platform\pango_native\build.pds | 13807 | 79E78C63D42DA5B64C00BFD163D4AB66EE7BE33FDA9509B3B7094F43A78C8215
platform\pango_native\build.tcl | 9207 | 4C6929AEB788DE03B9DCE593754EF59D8DB0D82BA43CA2A24F21C25C930B6755
platform\pango_native\native_sources.tcl | 776 | 9276028E86FF832683C15162EE0BFDF152B2EF1ACFB5517A5A15AE0B3A030ECD
platform\pango_native\pango_native.fdc | 2723 | 0B3F6E8BBDE3C83F68ED0B8EE50529C2498979B17E2B7C72AEB60F581DD1C87A
platform\pango_native\pango_native.pcf | 1789 | 4F21C1665A69E0A25503FBA6E4A73FD40086808ED55698357F9ABE9E8511B2BF
platform\pango_native\pango_native_50mhz_overconstraint.fdc | 1696 | C41DFA0CD75962EFAE4F196ABA0B4936421654BC9449A8A1C30D57239F7A9CF6
platform\pango_native\README.md | 16350 | 24B774C34147E1B5A5E676B54B26F2B1BA34FA6AB76857DB109BB934D2227326
README.md | 7364 | A9C82BCE7CB066152F9CB0A54C8D02F6AC62D29368EB20011BB0DC7305EBDD04
rtl\bus\axi_error_slave.v | 3930 | 7CC11F4B4BE6C7CF5BE64BC23B850B77951FCFFE198D4E309A8CE47831F9DA37
rtl\bus\axi_interconnect.v | 13149 | 32904CB5175D2B415819C9A066C4EC389B55C9CF398E83FEF61F960547B5BABB
rtl\core\axi_data_engine.v | 7151 | FA1077FBE391BFFC1EC3F165C23A30D75B330EAC4FF7BDEEC13B4209848C3C10
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
tools\run_halt_reset_tests.py | 7656 | 70FD90DBE16F1223699D8FF830F0D176C91A9174CE23ECDB58185170089C875B
tools\run_isa_e2e.py | 23458 | 36A2C24000F2A75C739DF48E4315207FE765120113B79F4FA22737E8A1A0181B
