licardlu/pangoriscv/evidence/records/bottleneck_audit/baseline_build/provenance/firmware_sha256.tsv

00_start.o | 1592 | 6BCB8BE2F9EB6E1176A0F20BC33AA7DC2BF2E5EC86208071C6DC5B38208C470A
01_trap_entry.o | 1076 | 8180124A799EE8FB842C1CD1B8CE9A990290B3FE084DF20081D107668F7F1EFD
02_init.o | 960 | A4EB7F725E3852BD7C8E213DE12A69A21DF441E4CAB9ACA3E3769AFE31667A8F
03_trap_handler.o | 1692 | 22BDAF656DA6BFB64458E0D5A23ED1C36C18EC8A1263E8DBCAF0C8BAA0AC98D4
04_utils.o | 1404 | 214103F2B719F338D17F54A5306F2FC364248B0E9F6A6BD86F049134B28ED491
05_runtime.o | 2116 | 6F3E895C1BC2AAD13AEEC3B060FFCE14B462F31F0AF34EDE54760FD03C2C1DAA
06_uart.o | 1432 | 19DB57C1151E62126C2C98068D1CDCFBB57EC02E71C32C4CA180A9FD5F0A9E47
07_xprintf.o | 6348 | A2EA1BEA656ACB55225A27ECB8266C3F56A03FE938F691442EE8390531BE7F62
08_spi.o | 2108 | 1D333783A283C4445601AA12875878AFD938D54607439E75BE544AC0ED67D2AE
09_flash_n25q.o | 4552 | 93F867808292B5EAA89651FDBEAA53DB312E9D816AF8BAEB1F865079453EA682
10_core_list_join.o | 7248 | 85A368F2FAE1649F4A56C521154A7550122B46329DF087C592F71BA9E92E4A89
11_core_main.o | 10512 | 306E9198E532FCFC23C58E1AEF209B1578CE6C39E5643B3DD514FFAF6B760281
12_core_matrix.o | 6524 | FAD4087BF76C54A8CAB8320DAD10197A442EB8C530CDFD43C57FC1AAC3C8CB4D
13_core_state.o | 7228 | 7DA7C2E42669AE5B48A8FAD055936B5DB307F353D19FE76A83B644CD5E59D66B
14_core_util.o | 2980 | 4C0D8FF9E05A0D6DFEA0BCC2234CDBEF66E5E44B5AEB27D6219553CDFFF7AD20
15_core_portme.o | 3104 | E6B50E07D43D665CCD6529170B8DEC810F92E8506AFDD21C5F4EE4D18A459E77
coremark.elf | 21364 | B8512B8D2017552764766C63220F44B41FE7AFCF5EE69D180510B28A7FDA474B
data.hex | 40960 | 6FFD4571DA129E86EEE388AC737C29191BF745BDEB9BB55B262EFF454CA06298
firmware.dump | 114261 | AD30F76F372CE18FD235D6595D284C3069E26458E8398E37F6D230CE8CF8CE10
firmware.map | 45986 | 5AFDAE594DB0ED0AE51570E2611C18D1B45CBA7A06E4F2F55F70EC90DE341876
manifest.json | 28289 | 3547E5F72F20B283B49E4C69A9621D752B9AB9DE643891BEF36FC6AEEC547988
program.bin | 16384 | 58DF05ECBC09A38BA74ADE34CDE8D35CD6AC2AB2D12284E9BA51E621ECCB6FB2
program.hex | 40960 | 4AD7DE6B14F6954BA3E04B93574713F4619101B3388DEC3CDE13F7B355E82EC6
