licardlu/pangoriscv/evidence/records/optimization/p13-board-verify/p13board36h_multiseed_summary.csv

version,2022.2-SP6.1<build 138931>
project name,impl.pds
Single Seed:
Seed,State,Convergence,Setup(Slow),Setup(Fast),Hold(Slow),Hold(Fast),Recovery(Slow),Recovery(Fast),Removal(Slow),Removal(Fast),PBM-GP,PBM-PreGP,PBM-PostGP,LP,Total Placement Cpu Time,Detailed routing,Total Routing Cpu Time,Wire Length After Post-GP,Wire Length After LP,Wire Length After DP,Routing Arc Length,Worst Slack After GP Timing,Worst Slack After LP Timing,Worst Slack Before RP,Worst Slack Before DP,Worst Slack After DP,Worst Slack After Placement,Worst Slack After TA By Preroute,TNS After DP,TNS Before Route,Setup(Slow) Total Failing TNS,Setup(Slow) Total Failing Endpoints,Hold(Slow) Total Failing THS,Hold(Slow) Total Failing Endpoints,Power
single,OK,Fail,1.114,11.299,-0.035,-0.030,NA,NA,NA,NA,NA,NA,NA,3.70,147.91,569.08,634.47,NA,NA,NA,426334,NA,NA,-1506,187,3496,3488,NA,0,0,0.000,0,-0.105,3,NA
Pass Rate/Convergence Rate,100.00%,0.00%
Synthesize:
control_set,255
Synthesize Performance Summary:
slack category,Synthesize Setup WNS,Synthesize Setup TNS,Synthesize Recovery WNS,Synthesize Recovery TNS
slack value,0.595,0.000,NA,NA
Synthesize Process Cpu Time,0h:2m:53s
Device Map:
Device Map Resource Usage Summary:
Logic Utilization,LUT,FF,DRM,APM,Distributed RAM,HSSTHP,USCM,HCKB,RCKB
Used,17869,7823,8,10,3790,NA,1,0,0
Available,66600,133200,155,240,19900,NA,32,96,24
Utilization(%),27%,6%,6%,5%,20%,NA,4%,0%,0%
Device Map Process Cpu Time,0h:0m:23s
Project Configurations:
top module,pangoriscv_top
compile," -top_module {pangoriscv_top}
 -include_path {D:/FPGA_Project/zi_guang_tong_chuang/pangoriscv/firmware/code/build/p13board36h/sources/rtl/core} "
synthesize," -ads "
device map,
place & route," -gplace_seed 3
 -fix_hold_violation_iterations 50
 -fix_hold_violation_threshold_for_clock_path_cross_srb 0
 -fix_hold_violation_threshold_for_clk_tree 0 "
Test Parameters Configurations:
testparam,
