licardlu/pangoriscv/docs/verification/audit-2026-10-18.md

# pangoriscv 独立复核报告

- 日期：2026-10-18
- 对象：`D:\FPGA_Project\zi_guang_tong_chuang\pangoriscv`（HEAD `b1541f7`，工作树干净）
- 方法：从源码独立重建固件 → 独立编译 RTL → 独立跑 768 迭代 CoreMark → 独立跑 ISA/RAM 回归 → 独立跑 PDS 27 MHz 实现；再逐条对照赛题硬性要求与评分口径。
- 本报告只写可复核的事实；所有路径均相对 `pangoriscv/`，独立复现产物在 `D:\FPGA_Project\zi_guang_tong_chuang\_verify_indep\`。

---

## 0. 结论（先看这一段）

**仿真跑分是真的、可复现的；但按赛题口径它不是有效成绩。**

1. **2.6740 CoreMark/MHz 复现成功，且是逐字段复现。** 我独立重建的 768 迭代固件与归档镜像 `program.hex`/`data.hex`/`coremark.elf` **SHA256 完全相同**；独立重跑 768 迭代仿真得到：
   - `Total ticks 287,211,317`、`cycles 288,997,740`、`retires 222,179,042`、IPC **0.7688**
   - `seedcrc 0xe9f5`、`crclist 0xe714`、`crcmatrix 0x1fd7`、`crcstate 0x8e3a`、`crcfinal 0x3c53`
   - `Correct operation validated`、`traps=0 faults=0`、`Errors: 0 Warnings: 0`
   - 换算：`768 / 287,211,317 × 1e6 = 2.6740 CoreMark/MHz`；`287,211,317 / 27e6 = 10.6375 s`
2. **但它不是赛题要求的“板上实测”。** 仓库里没有 768 迭代位流的串口实物输出，没有 ILA 波形，也没有应用场景章节；`bitstream/README.md` 与交接文档自己都写明“来自 RTL 仿真，不是板上实测，不得作为提交成绩”。
3. **三项指标同源证据不完整。** 交付位流 `F7B135AE…` 在其 27 MHz PDS 运行目录里不存在（`build/pango_native` 里是 50 MHz 那份 `112E2AE4…`）；27 MHz 时序只有一份 76 行摘要，且摘要里的 `+15.404/+0.025` 与同目录 PDS 摘要 `+15.267/+0.030` 不一致。我独立重跑 27 MHz PDS 得到 `+15.267/+0.030`，与后者一致。
4. **工具链不是赛题工具链。** 所有优化后镜像都由 xPack `riscv-none-elf-gcc 15.2.0` 生成（`riscv32-unknown-elf-gcc.exe` 只是同哈希改名）；板上基线用的是 `GCC 7.1.1 20170509`。绝对分数没有在赛题工具链上复测。
5. **代码署名/许可证存在硬冲突。** `README.md`/`LICENSE` 声明“全部代码自主实现、MIT、作者 pango_lpenghan”，但 `docs/design/change-notes/provenance.md:5,20-21` 明确记录这是 tinyriscv 的开发副本，并要求“不得声称完整 CPU 由本队新写、不得替换上游署名”。当前 9 个 core 模块确有 tinyriscv 基线路径（`ctrl/defines/div/ex/id/id_ex/if_id/pc_reg/regs`），全部文件头却已换成 pango_lpenghan。
6. **另有 2 个真实 RTL 功能缺陷、2 个性能缺陷**（不影响本次 CoreMark 的 ticks，但影响 RV32I 精确异常/本地总线语义）：D-Cache 对 `0x1000_4000..0x1FFF_FFFF` 的 store 提前返回 OKAY 并吞掉 DECERR；MMIO 的 byte/halfword 读固定 `ARSIZE=2` 会触发 SLVERR。详见 §5。

**最短补齐顺序**：上板跑 i768 + 抓 ILA + 补应用场景 →（用赛题 GCC 7.1.1）复测分数并重算迭代数 → 归档同一份 PDS 的 log/时序/资源 → 修文档与 RTL 缺陷。

---

## 1. 独立复现：我实际做了什么

### 1.1 环境

| 项 | 本机实际 | 赛题要求 | 判定 |
|---|---|---|---|
| 仿真器 | ModelSim SE-64 10.6e（`D:\FPGA_Project\Modelism\win64`） | 未指定 | 可用 |
| 实现工具 | PDS 2022.2-SP6.1（`pds\PDS_2022.2-SP6.1\bin\pds_shell.exe`） | 紫光同创 PDS | 可用 |
| 编译器 | xPack `riscv-none-elf-gcc 15.2.0`；`toolchains/xpack-.../bin/riscv32-unknown-elf-gcc.exe` 与 `riscv-none-elf-gcc.exe` **同 SHA256**（`9FD3AECD…`） | `riscv32-unknown-elf-gcc` | **名义满足、实质不是赛题分发的工具链** |
| 板上基线编译器 | `GCC 7.1.1 20170509`（OpenISA 工具链） | 同上 | 与优化后镜像不是同一编译器 |

`toolchains/prefix-shim/` 下 9 个 `riscv32-unknown-elf-*` 与 xPack 同名文件逐字节相同，是改名/副本，不是另一套工具链。

### 1.2 固件：从源码重建，与归档逐字节一致

```powershell
python tools/build_native_software.py coremark --mode performance --iterations 768 `
  --cpu-mhz 27 `
  --toolchain-bin "D:\FPGA_Project\zi_guang_tong_chuang\toolchains\xpack-riscv-none-elf-gcc-15.2.0-1\bin" `
  --extra-flag=-march=rv32im_zicsr --tag indep_verify
```

| 文件 | 与归档 `build/native_software/coremark/performance/score768` |
|---|---|
| `program.hex` | **IDENTICAL**（`B7F3A3B3…`） |
| `data.hex` | **IDENTICAL**（`BD65652F…`） |
| `program.bin` | **IDENTICAL**（`A59BDDEC…`） |
| `coremark.elf` | **IDENTICAL**（`01F6887F…`） |

ELF 属性（`readelf -h/-A`）：

- `Class: ELF32`、`Machine: RISC-V`、`Entry: 0x0`、`Flags: 0x0`（**无压缩指令**）
- `Tag_RISCV_arch: "rv32i2p1_m2p0_zicsr2p0_zmmul1p0"`
- `text 13,324 + data 2,680`（16 KiB 镜像仅余约 380 B）
- 迭代数 `ITERATIONS=768`，`-O2`，`PERFORMANCE_RUN=1`

CoreMark 本体合规：`tests/example/coremark/` 下 `core_list_join.c`、`core_main.c`、`core_matrix.c`、`core_state.c`、`core_util.c`、`coremark.h`、`LICENSE.md` 与官方 `coremark-1.01` **逐字节相同**；只有 `core_portme.c/.h`、`ee_printf.c` 是移植层。

### 1.3 RTL：独立目录、全功能开关、0 error / 0 warning

把 `rtl/tb/sim/tests/tools/platform` 复制到 `_verify_indep/code`，执行 `tools/set_switches.py on`（`CACHE_ENABLE`/`PREDICT_ENABLE`/`PERF_ENABLE` 全开），再用 ModelSim 编译：

```
vlog -sv -work work +incdir+rtl/core +incdir+rtl/bus +incdir+rtl/perips +incdir+rtl/soc \
     +incdir+tb +incdir+tb/integration -f sim/native_axi_sources.f tb/integration/tb_coremark_uart.sv
```

结果：**Errors: 0, Warnings: 0**。

### 1.4 768 迭代独立仿真：逐字段与归档一致

```
vsim -c -do "run -all; quit -f" work.tb_coremark_uart \
  +PROG=<indep_verify>\program.hex +DATA=<indep_verify>\data.hex +MAX_CYCLES=600000000
```

| 项 | 归档 `score768` | 本次独立重跑 | 一致 |
|---|---|---|---|
| `Total ticks` | 287,211,317 | **287,211,317** | ✔ |
| `cycles` | 288,997,740 | **288,997,740** | ✔ |
| `retires` | 222,179,042 | **222,179,042** | ✔ |
| IPC | 0.7688 | **0.7688** | ✔ |
| `seedcrc` | 0xe9f5 | **0xe9f5** | ✔ |
| `[0]crclist` | 0xe714 | **0xe714** | ✔ |
| `[0]crcmatrix` | 0x1fd7 | **0x1fd7** | ✔ |
| `[0]crcstate` | 0x8e3a | **0x8e3a** | ✔ |
| `[0]crcfinal` | 0x3c53 | **0x3c53** | ✔ |
| `Correct operation validated` | 是 | **是** | ✔ |
| traps / faults | 0 / 0 | **0 / 0** | ✔ |
| 仿真错误/警告 | 0 / 0 | **0 / 0** | ✔ |

仿真耗时 34 分 45 秒（与仓库归档的 33.4 分钟同量级）。产物：`_verify_indep/run768/transcript.txt`。

### 1.5 交叉验证

| 检查 | 结果 | 位置 |
|---|---|---|
| 20 迭代独立镜像 | ticks `7,481,200` → **2.6733 CM/MHz**，CRC 链正确 | `_verify_indep/run20/transcript.txt` |
| ISA 端到端（15 项，含 ALU/load-use/M 扩展/分支/CSR/mcycle/ECALL/MRET/非法指令/load-store fault/UART/GPIO/timer/中断） | **15/15 PASS** | `_verify_indep/isa_runs3/` |
| RAM/LSU 随机回归（20 seeds × 2） | **40/40 PASS** | `_verify_indep/code/.sim_runs/` |
| 独立 PDS 27 MHz 全流程 | **All Constraints Met**；setup **+15.267 ns**、hold **+0.030 ns**、**0 / 54,345** 失败端点；后布线 LUT **13,389**、FF **8,507**；时钟 37.037 ns；工具按余量推算 **45.93 MHz** | `_verify_indep/code/build/pango_native/pds_my27.log`、`report_timing/pangoriscv_top.rtr` |

> 说明：20 迭代的 `7,481,200` 与文档里的 `7,478,647` 差 0.03%，因为归档 A/B 用的是带 `-DPERF_DUMP` 的 `perf_on` 镜像；交付 768 镜像逐字节相同，所以 768 结果是精确复现。

> PDS 的 hold fixer 日志出现 `Hold violation fix failed`，是指“没有把余量修到 500 ps 目标”，不是时序失败：最终 WHS 仍为 **+0.030 ns**、0 失败端点，`report_timing` 为 `All Constraints Met`。

---

## 2. 跑分计算与口径

赛题公式：`Score = Iterations / (Total_Time × Frequency)`，即 CoreMark/MHz。

```
Iterations = 768
Total ticks = 287,211,317（mcycle，1 tick = 1 个 27 MHz 周期）
Total_Time = 287,211,317 / 27,000,000 = 10.6375 s
CoreMark/MHz = 768 / (10.6375 × 27) = 2.6740
等价的整数算法 = 768 × 1e6 / 287,211,317 = 2.6740
IPC = 222,179,042 / 288,997,740 = 0.7688
27 MHz 下绝对分 = 768 / 10.6375 = 72.20 iterations/s
```

### 2.1 必须注意的两个口径坑

1. **固件打印的 `Total time (secs): 10` 与 `Iterations/Sec: 76` 是整数截断，不能用来反推分数。**
   `core_portme.h` 里 `HAS_FLOAT 0`，`time_in_secs()` 做整数除法：`10.6375 → 10`，`768/10 = 76`。
   若用打印值算：`768/(10×27) = 2.8444`，比真值高 **6.4%**。
   仓库文档已多次提醒“必须用 ticks”，但**串口原始输出本身仍然会误导评委**（见 §6）。建议固件直接打印毫秒/定点秒，或打印一行 `CoreMark/MHz = 2.6740`。
2. **`crcfinal` 没有官方黄金表。** 官方只强制比对 `crclist/crcmatrix/crcstate` 三项；`seedcrc` 决定 `known_id`（0xe9f5 → 2K performance），`crcfinal` 是跨迭代累积值，随迭代数变化（20→0x4983、768→0x3c53）。说“五项全部正确”应理解为“五项数值与官方已知链/确定性链一致”，而不是五项都有独立黄金值。

### 2.2 运行时间 ≥10 s

`287,211,317 / 27e6 = 10.6375 s`，满足 ≥10 s；迭代下限 `ceil(10.5×27e6/373,932) = 759`，取 768，留 6.4% 余量。**若改用赛题 GCC 7.1.1 后每迭代 ticks 变化，必须重算**。

---

## 3. 三项评分指标核对

| 指标 | 仓库声称 | 我的独立核对 | 判定 |
|---|---|---|---|
| ① 执行效率 | **2.6740 CoreMark/MHz**（768 迭代，10.64 s） | 完全复现：ticks 287,211,317、CRC 全对、10.6375 s、2.6740 | **数值真实；但只是仿真，按赛题不能作为①报分** |
| ② 时钟频率 | 27 MHz 约束 All Constraints Met（+15.404/+0.025，0/54,345）；50 MHz 过约束也 Met（+0.862/+0.087，0/54,685） | 独立 27 MHz PDS：All Constraints Met，**+15.267/+0.030，0/54,345**；50 MHz 未重跑，引用归档 | **27 MHz 约束确实收敛；但引用的 +15.404/+0.025 与同目录 PDS 摘要 +15.267/+0.030 不一致，且没有“最高频率”扫描** |
| ③ 资源效率 | 0.1970 CoreMark/kLUT（LUT 13,574，取自 device_map） | 独立 PDS 后布线 LUT **13,389**；归档 multiseed device_map **13,444**；13,574 是 synthesis Mapping Summary | **13,574 不是 device_map 数；口径标错。用 13,574 算是保守值（0.1970），用后布线 13,389 是 0.1997** |

### 3.1 “同一份实现”核对

- `bitstream/pangoriscv_i768.sbit` 实测 SHA256 = `F7B135AE975CCDE775D5B046AFC06BF7BE0EC5D3309996B0E36EEF471BA42F8D`，与 `bitstream/README.md:17`、`P16/measurement.md:118` 登记值**一致**。
- 但该 27 MHz 位流在本机**没有任何对应构建目录**：
  - `build/pango_native` 里的 sbit 是 `112E2AE4…`（= P16 的 50 MHz 那份）；
  - `build/pango_27mhz` 里的 sbit 是 `65BC9C07…`，且该次日志有 `Cannot open specified data file "program.hex"`（空存储器失败构建，已作废）；
  - 全仓库找不到 27 MHz 的 `report_timing/*.rtr` 或 PDS `flow.log`，只有 76 行摘要 `P16/timing_summary_27mhz.txt`。
- 因此“位流 + 13,574 LUT + 27 MHz 时序”三者同源**无法从仓库自证**；只能依赖作者的声明。评分要求“互相对上”，这是实质缺口。

### 3.2 频率口径

- 27 MHz = 板载晶振约束（`pango_native.fdc` 的 `create_clock -period 37.037`），**不是实测最高频率**；文档对此标注正确。
- 50 MHz = `pango_native_50mhz_overconstraint.fdc` 的过约束实验，文档明确写“不是板上实测最高频率”，这点没混称。
- 但赛题②问的是“能达到的最高工作频率”。目前只证明 50 MHz 约束可过（下界），**没有 60/70/80 MHz 扫描**，也没有板上实测。写法上应明确“50 MHz 为约束收敛下界，最高频率未测”。
- 我独立的 27 MHz 实现按 setup 余量推算 fmax ≈ **45.93 MHz**；归档 50 MHz 实现按余量推算 ≈ **50.9 MHz**。两个数都是工具推算，不是实测，不能当选“最高频率”。

---

## 4. 赛题合规缺口（按严重度）

### P0 · 会直接导致①作废

| # | 缺口 | 证据 | 赛题条款 |
|---|---|---|---|
| 1 | **没有 i768 位流的上板实测**。仓库里唯一真实上板记录是 i400 基线（400 迭代、ticks 320,541,251、GCC 7.1.1、crcfinal 0x25b5），不是 2.6740 这份 | `evidence/records/bottleneck_audit/results/board_uart_baseline.txt`、`board_uart_delivered_bitstream.txt`；`bitstream/README.md:95-98`；`docs/verification/handoff-2026-10-18-ifu-done.md:16` | §二/§三.1/§五.1；“分数必须来自 FPGA 上真实运行，仿真数据不能替代实测” |
| 2 | **ILA 波形 0 份**。全仓库无 `.vcd/.wlf/.fsdb` 或波形图；`native-basic-final-status.md:38,77` 与 `docs/contest/README.md:24` 均 NOT RUN | 同上 | §四.3(2)：用 ILA 抓 CoreMark 关键算法波形分析流水线效率 |
| 3 | **应用场景 0 处**。只有计划书里的 YOLO/DDR 任务卡，没有实现、没有资源/时序/主频、没有延迟/识别率 | `docs/design/plans/...:103,114-116`；全仓库无场景章节 | §四.2 |

### P1 · 影响成绩可比性/证据可信度

| # | 缺口 | 证据 | 影响 |
|---|---|---|---|
| 4 | **工具链不是赛题工具链**：优化链全部用 xPack GCC 15.2.0；板上基线用 GCC 7.1.1。`riscv32-unknown-elf-gcc` 只是同哈希改名 | `toolchains/xpack-.../bin`、`toolchains/prefix-shim`；`build/.../score768/manifest.json` 的 `compiler` 写的是 `riscv-none-elf-gcc.exe … 15.2.0` | CoreMark 对 codegen 敏感；绝对分不能与板上 GCC 7.1.1 基线直接横比。需用赛题工具链复测 |
| 5 | **三项指标同源证据不完整**（见 §3.1） | 27 MHz sbit 无 PDS 目录/原始报告 | ②③ 的“同一份实现”无法自证 |
| 6 | **27 MHz 时序两套数**：文档 `+15.404/+0.025`，同目录 PDS 摘要 `+15.267/+0.030`，我独立重跑 `+15.267/+0.030` | `P16/timing_summary_27mhz.txt:8,16`；`P16/pds_27mhz_multiseed_summary.csv`；我的 `pds_my27.log` | 引用的 slack 不可复现（虽然两者都通过） |
| 7 | **LUT 出处误标**：13,574 是 synthesis `Mapping Summary`，不是 device_map；device_map 13,444、后布线 13,389 | `build/res_p16_work/synthesize/run.log:1523`；`P16/pds_27mhz_multiseed_summary.csv:19`；我的 PDS 利用率表 | ③ 的 LUT 口径不清；13,574 偏保守 1.4% |
| 8 | **署名/许可证冲突**：README/LICENSE 声明全部自主 MIT；provenance.md 记录是 tinyriscv 开发副本、不得声称新写/替换上游署名；9 个 core 模块来自基线路径 | `README.md:3`、`LICENSE:3`、`firmware/code/README.md:3`；`docs/design/change-notes/provenance.md:5,20-21`；基线 CSV 的 `rtl/core/*.v` | 诚信与许可证风险；Apache-2.0 基线被替换成 MIT，需法律/赛规确认 |
| 9 | **`manifest.json` 未入库**（`build/` 被 ignore），交付镜像的编译命令/flags 不在提交物里 | `.gitignore`；`build/native_software/.../manifest.json` | 评委无法直接核对编译选项；虽然我重建证明可复现 |

### P2 · 文档/口径/工程卫生

见 §6。

---

## 5. RTL 功能缺陷（独立静态审查 + 我的复核）

> 这些缺陷**不会**让本次 CoreMark 跑错或让 2.6740 变高；相反，修好后成绩可能略升。它们影响 RV32I 精确异常、MMIO 语义和“2 路 LRU / 饱和计数器”的声称。

| 严重度 | 文件:行 | 问题 | 影响 | 复核 |
|---|---|---|---|---|
| **高** | `rtl/core/dcache_axi.v:369`（`CACHED_LIMIT` 在 `:39`） | `early_q` 覆盖 `0x1000_0000..0x1FFF_FFFF`，但数据 RAM 只有 `0x1000_0000..0x1000_3FFF` 16 KiB；对 `0x1000_4000..0x1FFF_FFFF` 的 store 在 W beat 就回 OKAY，B 通道的 DECERR 在 `ST_WR_DRAIN`（`:496-501`）只失效行、不报 fault | 该范围 store **静默成功，不产生 store access fault（cause 7）**；精确异常模型被破坏。CoreMark 不访问该空洞，所以不影响本次分数 | 已读 `dcache_axi.v:369,448-464,496-501`；`pangoriscv_axi_soc.v:85-90` 数据 RAM 16 KiB；interconnect 把越界送 error slave 返回 DECERR |
| **高** | `rtl/core/dcache_axi.v:256`（`:400-402`） | MMIO/非缓存读固定 `m_arsize = 3'd2`，同时 `ar_addr_q <= req_addr` 保留 byte/halfword 偏移；`axi_reg_slave.v:37-42` 要求 `size==2` 时 `addr[1:0]==0` | 对 MMIO 的 `lbu/lhu` 在 offset 1..3/2 会返回 SLVERR → **load access fault**；基线 `axi_data_engine` 用 `req_size=access_size` 是正常的。当前固件用 32 位字访问，未触发 | 已读 `dcache_axi.v:256,400-402`、`axi_reg_slave.v:37-42,79-82` |
| 中 | `rtl/core/dcache_axi.v:381-387,409-414` | 快命中（`rsp_ready=1`）直接回 `ST_IDLE`，而 LRU 只在 `ST_HIT` 更新；LSU 在 accept 拍通常 `rsp_ready=1` | 2 路 LRU 在多数 read hit 上**不更新**，替换退化为固定受害者；影响命中率/跑分，不影响正确性 | `lsu_axi.v:76`；`tb_dcache_axi.sv:263,266` 只测慢路径 |
| 中 | `rtl/core/branch_predictor.v:110-118` | `count_q <= (train_hit && count!=2'b11) ? count+1 : 2'b10;`：`count==11` 且 taken 时被写成 `10`，**不是饱和保持 11** | 长期 taken 的分支被一次 not-taken 打回 01（预测 not-taken）；多一次 misprediction。声称“2 位饱和计数器”不成立 | 已读 `branch_predictor.v:110-118`；`tb_branch_predictor.sv:153-160` 用 4 次 taken 恰好掩盖 |
| 中 | `rtl/core/soc_config.vh:34-36` | 仓库默认三开关**全关**；`build.tcl` 不会自动调用 `set_switches.py` | 直接 `build.tcl` 得到的是 baseline，不是交付 all-on 位流；若镜像带 `PERF_DUMP`，baseline 未映射 `0x60002000`，读 perf 会 load fault | `bitstream/README.md:21` 声称全开；`tools/set_switches.py:22` 需人工执行 |
| 中 | `rtl/core/id.v:160-162` | `FENCE` 实现，`FENCE.I` 故意非法 | 若评委用 riscv-tests `rv32ui-p-fence_i`，会 trap；自修改代码不支持。RV32I 2019 把 FENCE.I 划到 Zifencei，所以“RV32I 基础”可辩解，但应明确写“不支持 Zifencei” | 已读 `id.v:160-162`；旧基线日志里 `rv32ui-p-fence_i` 是 PASS，当前设计会不同 |
| 低 | `rtl/core/dcache_axi.v:395` vs 注释 `:20-22` | 注释称“invalid ways are filled first”，实际 `fill_way_q <= lru_mem`，不优先填 invalid 路 | 轻微命中率损失 | 已读 |
| 低 | `rtl/core/dcache_axi.v:409-414,429-433` | `ST_HIT` 每拍无条件 `resp_q<=0`；refill 错误先置 `2'b10` 再进 `ST_HIT`，背压下错误码可能被清成 OKAY | 潜伏；当前 LSU 恒 ready，未触发 | 已读 |
| 低 | `rtl/perips/axi_uart.v:57,107-110` | RX 无 overrun 标志，新字节覆盖旧字节 | RX 溢出静默丢字节；CoreMark 不用 RX | 已读 |
| 低 | `rtl/core/ifu_axi.v:108-111` | 用 `=== 1'bx` 做 X 检测 | 综合可移植性风险；当前两端口都连接，死分支 | 已读 |
| 低 | `rtl/perips/axi_ram.v:99-101,160-166` | burst write 路径实际不可用（`write_good` 要求 `aw_len==0`） | 当前 LSU 只发单 beat，不暴露；未来接 burst write 会丢数据 | 已读 |
| 低 | `rtl/perips/axi_uart.v:120-129` | UART TX 复位为低 | 上电到第一个 idle 拍可能被外部当 start bit | 静态 |
| 低 | `rtl/core/pangoriscv.v:144-145` | `trap_vector` 端口被忽略，实际用 CSR `mtvec` | 顶层接 0 也不影响；可维护性 | 静态 |
| 低 | `rtl/core/ex.v:462-494` 与 `pangoriscv.v:57-60`/`div_adapter` | CSR 写/除法存在重复“事实来源” | 维护风险 | 静态 |

**已确认正确的关键点**（独立审查）：3 级流水线无独立 EX/MEM 前递，但靠 `regs.v` 写穿 + 全停顿覆盖唯一在途生产者（load-use、ALU→ALU、load→ALU 均正确）；redirect/冲刷/退休、RV32IM 算术/分支/移位/乘除边界、CSR/MRET/trap 优先级、AXI4 握手/ID/LAST/错误响应、I-Cache 2-way LRU/fill 校验、UART/timer/irq/GPIO/RAM 基本路径均通过静态核对与 15/15 ISA、40/40 RAM 回归。

---

## 6. 文档与证据错误清单

| 严重度 | 位置 | 问题 | 建议 |
|---|---|---|---|
| **高** | `README.md:4,13,15` | 根 README 仍写“400 次迭代、1.35 CoreMark/MHz、四级流水线”；当前交付是 768 迭代、2.6740、三级流水线 | 改成 768/2.6740/三级，并注明“仿真、未上板” |
| **高** | `firmware/code/README.md:18,43-49,95` | 仍写 1.35/1.25、400 迭代、12,694 LUT、16.262 ns、位流 `F8254F66…`（该 sbit 已不在仓库） | 全表刷新到 2.6740/768/13,574（或 13,389）/+15.267/`F7B135AE…` |
| **高** | `platform/pango_native/README.md:114-135` | 仍写 200 迭代、0.305 CoreMark/MHz、`CPM_TICKS` 输出；与当前固件/分数完全脱节 | 标注历史或删除 |
| 中 | `docs/verification/handoff-2026-10-18-ifu-done.md:96-112,162` | §3 仍写“交付跑分为什么是 512 迭代”“ticks 304,495,134”，并让下载 `pangoriscv_i512.sbit`；与 §1 的 768 矛盾 | 统一到 768，删 i512 残留 |
| 中 | 同文件 `:27` | 把 27 MHz 的种子尝试（11 通过、41 不收敛、23 三端点 −0.012）写成“50 MHz 是种子敏感的：seed 11→−0.001、41→−0.155、23 才通过”，与 `P16/measurement.md:119-122` 相反 | 按 P16 测量记录更正 |
| 中 | `evidence/records/bottleneck_audit/results/baseline_build.md:75` | 记录 `board_uart_baseline.txt` 的 sha256 为 `78B7D08D…`，实测文件是 `4F89E5D9…` | 重算并更正；否则“板上身份链”断裂 |
| 中 | `evidence/records/optimization/P16/VERIFICATION.md:57` | 声称“全仓复扫控制字符数为 0”，但该行本身残留 2 个 U+0007（BEL） | 清掉控制字符并重跑扫描 |
| 中 | `evidence/records/optimization/P16/measurement.md:113-118`、`bitstream/README.md:56-57` | 27 MHz slack 15.404/0.025 与 PDS 摘要 15.267/0.030 不一致；LUT 13,574 标成 device_map | 统一引用同一份 `report_timing` + `device_map`，注明阶段 |
| 中 | 串口输出（`core_portme.h` `HAS_FLOAT 0`） | `Total time 10`、`Iterations/Sec 76` 是截断值；用它们算得 2.8444，比真值高 6.4% | 固件打印毫秒/定点秒，或加一行 `CoreMark/MHz` 计算值 |
| 中 | `evidence/records/optimization/P16/verify_rerun_768.txt`、`tools/run_fetch_ab.py:229` | 报告里的 `under-10s-rule=False` 标签容易被读成“不满足 10 s”；实际含义是“没有打印 under-10s 错误” | 改成 `over_10s=True` 或 `under_10s_error=False` |
| 低 | `docs/design/change-notes/provenance.md` vs `README.md:3`/`LICENSE` | 上游署名/许可证与“全部自主、MIT”冲突（见 §4-8） | 恢复上游 NOTICE/许可证，或取得书面授权；改写“自主实现”措辞 |
| 低 | `firmware/code/README.md:3` | 文件本身是合法 UTF-8（此前“乱码”是用 GBK/ANSI 读 UTF-8 的假象） | 无需改编码；只需改内容 |
| 低 | `evidence/records/optimization/P16/verify_rerun_768.txt` | UTF-16LE 编码，文本工具直接读会乱码 | 转 UTF-8 |
| 低 | `evidence/records/bottleneck_audit/board/*.tcl.out.txt` | 2 个 GBK 文件 | 转 UTF-8 或注明 |
| 低 | `docs/repo/LAYOUT.md:9-16` | 文件数/体积过期（实际约 12.5 MB、160+973 文件） | 更新 |
| 低 | `.githooks/pre-push` | 引用不存在的 `SCORE-STATUS.txt`；`ab-log.csv:2` 引用的 `evidence/records/coremark-sim-*` 被 gitignore | 补文件或改引用 |
| 低 | `.sim_runs/` | 本机该目录下若干 `isa-e2e-*` 子目录 ACL 不可读，`run_isa_e2e.py`/`run_unit_tests.py` 默认 `--out .sim_runs` 会 `PermissionError` | 清理该目录；runner 用可写 `--out` |
| 低 | `README.md:61` | 说仓库约 5 MB，实际约 12.5 MB | 更新 |

### 6.1 数字一致性（权威值）

当前内部自洽的“交付值”是：

```
768 迭代 / ticks 287,211,317 / 10.6375 s / 2.6740 CM/MHz
LUT 13,574（synthesis）或 13,389（post-PnR）/ 0.1970 或 0.1997 CM/MHz/kLUT
27 MHz: +15.404/+0.025（文档） 或 +15.267/+0.030（PDS 摘要/我的重跑）
位流: F7B135AE975CCDE775D5B046AFC06BF7BE0EC5D3309996B0E36EEF471BA42F8D
```

`ab-log.csv:29`、`P16/measurement.md`、`bitstream/README.md` 三者对 768/287,211,317/2.6740/13,574 是自洽的；问题只在旧文档、时序摘要、LUT 阶段标签。

---

## 7. 修复优先级

### P0（不做就不能按赛题报分）
1. **上板**：用 `bitstream/pangoriscv_i768.sbit`（或重新生成）下载，串口抓完整 768 迭代输出，确认五项 CRC 与 `Correct operation validated`；确认实际运行 ≥10 s；若板上频率/时序与仿真不同，重算迭代数。
2. **ILA**：抓 CoreMark 关键算法窗口（list/matrix/state 三者之一），保存波形图 + 触发条件/时间轴 + 流水线效率解读，写入性能分析文档。
3. **应用场景**：至少给出一个真实场景（工控/采集/游戏机/图像加速等），写明整体资源、时序、主频；AI 类还需延迟与识别率。

### P1（成绩可比性与证据链）
4. 用赛题 `riscv32-unknown-elf-gcc`（板上基线是 GCC 7.1.1）重编 768 镜像、重跑仿真/上板，重算分数；在文档中披露 GCC 版本。
5. 归档 27 MHz 那一份 PDS 的完整 `flow.log`、`report_timing/*.rtr`、`device_map` 资源表、`compile/run.log`，与 `F7B135AE…` 位流放同一目录；统一引用 `+15.267/+0.030` 或重新生成一份可复现的报告。
6. 明确 LUT 口径：`synthesis 13,574` / `device_map 13,444` / `post-PnR 13,389` 三选一，并写清出处；③ 建议用后布线值并注明“CoreMark/MHz per kLUT”。
7. 把 `manifest.json`、`program.hex`、`data.hex` 与位流一起归档（或放进 `evidence/`），保证编译选项可核对。

### P2（代码与文档）
8. 修 D-Cache `early_q` 范围（改成数据 RAM 窗口 `0x1000_0000..0x1000_3FFF`，或让 DRAIN 的 B 错误上报 fault）。
9. 修 MMIO 读 `ARSIZE`（用 `req_size`，与基线 `axi_data_engine` 一致）。
10. 修 D-Cache 快命中 LRU 更新（在 `state<=IDLE` 分支也更新 `lru_mem`）。
11. 修 2-bit 计数器饱和（`count==11 && taken` 保持 11）。
12. 在 `build.tcl` 里显式检查/切换三开关，或在 README 写死“先 `set_switches.py on`”。
13. 刷新根 README、firmware README、platform README、handoff；修 UART sha、BEL、UTF-16、LAYOUT 体积。
14. 决定 FENCE.I：要么实现为 I-Cache invalidate + nop，要么在文档明确“不支持 Zifencei”，不要让它静默 trap。
15. 澄清 tinyriscv 署名/许可证；恢复上游 NOTICE 或取得授权。

---

## 8. 证据索引（本次独立复现）

| 内容 | 路径 |
|---|---|
| 独立固件（字节一致） | `pangoriscv/firmware/code/build/native_software/coremark/performance/indep_verify/` |
| 20 迭代镜像 | 同目录 `indep20/` |
| RTL 编译日志（0/0） | `_verify_indep/run768/compile.log` |
| 768 迭代 transcript | `_verify_indep/run768/transcript.txt` |
| 20 迭代 transcript | `_verify_indep/run20/transcript.txt` |
| ISA 15/15 | `_verify_indep/isa_runs3/isa-e2e-*/` |
| RAM 40/40 | `_verify_indep/code/.sim_runs/ram-*/` |
| PDS 27 MHz 日志 | `_verify_indep/code/build/pango_native/pds_my27.log` |
| PDS 时序报告 | `_verify_indep/code/build/pango_native/report_timing/pangoriscv_top.rtr` |
| PDS 新位流（哈希不同属正常） | `_verify_indep/code/build/pango_native/generate_bitstream/pangoriscv_top.sbit` |

### 复现命令（简版）

```powershell
# 1) 固件
python tools/build_native_software.py coremark --mode performance --iterations 768 --cpu-mhz 27 `
  --toolchain-bin "<xpack>\bin" --extra-flag=-march=rv32im_zicsr --tag indep_verify

# 2) RTL + 768 迭代
vlog -sv -work work +incdir+rtl/core +incdir+rtl/bus +incdir+rtl/perips +incdir+rtl/soc `
     +incdir+tb +incdir+tb/integration -f sim/native_axi_sources.f tb/integration/tb_coremark_uart.sv
vsim -c -do "run -all; quit -f" work.tb_coremark_uart `
  "+PROG=<image>\program.hex" "+DATA=<image>\data.hex" "+MAX_CYCLES=600000000"

# 3) ISA / RAM
python tools/run_isa_e2e.py --toolchain-bin "<xpack>\bin" --modelsim "<ModelSim>" `
  --extra-flag=-march=rv32im_zicsr --cases all --out <writable>
python sim/run_ram_tests.py --seeds 20

# 4) PDS 27 MHz（先 set_switches.py on；再 set NATIVE_IMAGE_DIR）
$env:PANGO_NATIVE_REPO="<code>"; $env:PANGO_NATIVE_BOARD_DIR="<code>\platform\pango_native"
$env:NATIVE_IMAGE_DIR="<image>"
$env:PANGO_NATIVE_PNR_EXTRA="-fix_hold_violation -fix_hold_violation_threshold 500 -fix_hold_violation_threshold_for_clk_tree 200 -fix_hold_violation_iterations 2000 -max_hold_violated_paths_num 40000 -gplace_seed 11 -groute_seed 11"
Set-Location "<code>\build\pango_native"
pds_shell.exe -file "<code>\platform\pango_native\build.tcl"
```

---

## 9. 一句话总结

**你的 2.6 是真的：我在完全独立的目录里，用逐字节相同的固件、相同的 RTL、相同的 768 迭代，复现出了完全相同的 287,211,317 ticks、五项 CRC 和 2.6740 CoreMark/MHz；27 MHz 时序也独立收敛（+15.267/+0.030，0 失败）。但按赛题它现在只能算“高质量仿真证据”，还不是可提交成绩——缺上板、缺 ILA、缺应用场景，且工具链、位流同源证据和代码署名需要补齐或澄清。**
