licardlu/pangoriscv/evidence/records/validation_20261104/dataset/数据集来源与评测边界.md

# 数据集来源与本轮评测边界

来源：keremberke/garbage-object-detection，原始 Roboflow Material Identification 的 GARBAGE CLASSIFICATION 3 v2。

- 官方页：https://huggingface.co/datasets/keremberke/garbage-object-detection
- 原始页：https://universe.roboflow.com/material-identification/garbage-classification-3/dataset/2
- 模型页：https://huggingface.co/keremberke/yolov5n-garbage
- 数据许可证：CC BY 4.0，下载保存的 README.md 和 README.dataset.txt 可核对。
- 镜像：hf-mirror.com。仓库提交 d8ad1490da2686d7af5c6a7f3d8844f0f9542b0f。
- ZIP 已按 Hugging Face LFS SHA-256 校验，下载源文档哈希见 source_documents.json；逐split统计和ZIP哈希见 dataset_audit.json。

上游数据集包含10464张图。已取得 test 1042张和validation 2098张；原始数据预处理为416×416拉伸，图片包含上游翻转与90度旋转预处理/扩增痕迹。COCO标注 bbox 为绝对像素 xywh，类0~5依次为 biodegradable/cardboard/glass/metal/paper/plastic，可与现部署模型直接匹配。

test共3563框但glass类为0，不能利用该split得出glass AP。全test按串口82秒每图估计约23.7小时（仅用于测试时间规划，不是实测本轮速度）。

本轮板测选用 validation18_seed20261104.json：固定随机种子20261104、每个目标类选3张、总计18张，不根据预测筛选。优先单框、其次单类、最后多类；全部原始GT保留。所选图全部来自同一个validation split。它属于小样本分层验证复测，不是全量test准确率，也不能当作全系统真实场景识别率。

原模型卡本就在同源validation上报告 mAP@0.5=0.31988455750353156。这只是上游模型结果，不是本板测结果，不应冒充这次准确率。validation可能参与checkpoint选取和调参；尚未取得全部train归属及重复审计，不宣称与训练完全独立。
