licardlu/pangoriscv/evidence/records/validation_20261104/dataset_metrics_partial/评测定义与文档说明.md

# FPGA 数据集实测定义与结果

状态：PARTIAL 部分结果 不可作最终数据。本轮已测 16 张，GT 111 个，返回框 38 个。原始结果 SHA256 `d21413cad891fe7f60ff898978563e00cd2935d410e0febc4950f472732763db`，预先固定选样清单 SHA256 `dc027b64792fe82e029dc06aaa0c67927a8a77d4838271e4756c976a28d42c27`。

预测全部来自当前27 MHz v3 FPGA串口原始响应，未使用PC模型预测替代。框格式通过协议及固件源码核实为原图绝对像素xyxy；COCO评估时转换为xywh。每帧JSON预测与保存的原始二进制 `<5fI` 回复逐项比对。

固定工作点为conf≥0.25，NMS IoU=0.45。P/R/F1采用同类别、按置信度降序、IoU≥0.5一对一匹配。微平均按所有对象汇总TP/FP/FN；宏平均为六类逐类指标算术平均，不可把对象微平均称为图片分类准确率。分母为0时该项记0。

COCO AP50及AP50:95由pycocotools官方COCOeval计算，IoU从0.50到0.95步进0.05、101个召回点、maxDets100；但固件只返回conf≥0.25且最多32框，低分候选已不可恢复，AP应写成“当前部署工作点输出的AP”，不能与上游低阈值完整模型AP直接等同。

混淆矩阵行是真值、列是预测，最后一行/列为background。矩阵先按几何IoU降序忽略类别进行一对一匹配，再统计预测标签，漏检进入background列，误检进入background行。它用于展示类间混淆；与分类别P/R的匹配顺序不同，可能产生不同配对，不能用非对角项直接重算前述P/R。

18张是上游validation的固定seed20261104分层小样本，每个目标类抽3图，但保留多类图全部GT使对象数不均衡：{'biodegradable': 95, 'cardboard': 3, 'glass': 3, 'metal': 3, 'paper': 6, 'plastic': 1}。特别是厨余类对象占多数，应同时看宏/微平均，不把小样本结果外推为全数据集识别率。该validation也是原checkpoint的调参/评测来源，训练重叠未审计。

静态图推理平均 3.393571 s，不含约 81.967 s/图的串口输入传输，不含摄像头实际取图。不能当作实时摄像头整机刷新延迟。

图示样例固定为清单第1、7、16项，在查看预测质量前选定。绿色为GT，洋红为实际返回预测；稠密目标图中的漏检均保留。
