licardlu/pangoriscv/evidence/records/optimization/p67r50f32/measurement.md

# p67r50f32 — 综合 `-fanout_guide 32`：驱动器复制成功，但面积与拥塞同时爆炸

**日期**：2026-10-24 16:50–17:10（未跑完，布线阶段终止）
**树**：交付树（`232dfa3`）　**约束**：50 MHz（20.000 ns）　**镜像**：`hw_i2900_52b`
**综合**：`synthesize -ads -selected_syn_tool_opt 2 -fanout_guide 32`
**pnr**：`-dc_duplication TRUE -slack_prior_in_global_router TRUE -refineplacement_cluster TRUE`

## 动机

交付版最关键路径的最后一跳是 `data_cache/N4033[0]`，**fanout=256、单根线 2.500 ns**，
直连 1,024 个 `ram64x1d/WADDR` 引脚（见 `docs/plan-v23-area-and-freq.md` §10）。
`-fanout_guide` 是让综合器复制驱动器、把复制体贴近各自负载的标准手段，故做此实验。

## 结果（对照交付 `p48r50e`，同树同约束同镜像）

| 项 | 交付 `p48r50e` | `p67r50f32` | 变化 |
|---|---:|---:|---|
| 综合 WNS | +0.395 ns | +0.457 ns | +0.062 |
| **LUT** | **17,174** | **18,222** | **+1,048（+6.1%）** |
| FF | 8,693 | 9,562 | **+869（+10.0%）** |
| 摆放 slack | +1,683 ps | +1,377 ps | **−306 ps（更差）** |
| 布线 | 114 轮收敛 | 第 9 轮仍有 16,402 根未通，45 s/轮 | **拥塞，终止** |

## 结论

驱动器复制**确实发生了**（+1,048 LUT / +869 FF 就是复制体的代价），但：

1. **摆放 slack 反而更差**（+1,377 vs +1,683）——复制体把逻辑摊开，物理距离没有变短；
2. **面积 18,222 已经越过 lesson 9 的可布性门槛**（≤18,000 成功率高的经验线），
   布线立刻表现出典型拥塞指纹（每轮 45 s、未通数下降极慢）；
3. 指标 3 会从 0.3056 掉到 0.288（−5.8%），换不到任何确定的频率收益。

⇒ **`-fanout_guide` 不是解**。高扇出线（fanout=256 的阵列写地址）**不能用"复制驱动器"解决**，
因为 1,024 个负载是物理分散的阵列原语，复制只能增加面积、不能缩短"最后一公里"。
唯一有效的做法是把这条路径**从关键路径上摘掉**（写地址打一拍，见 plan v23 §10.2）。
