licardlu/pangoriscv/evidence/records/optimization/p49-freq-ladder/measurement.md

# P49 —— 频率阶梯：50 MHz 是这条网表的封顶（2026-10-23）

**结论：单时钟声明的三个点，只有 20.000 ns 是甜点。目标再收紧，布线结果单调恶化。**

| 声明周期 | 对应频率 | 摆放 WNS | 布线后 | 结果 |
|---|---|---|---|---|
| **20.000 ns** | 50 MHz | +1683 ps | **19.355 ns** | ✓ WNS **+0.645**（交付，`p48r50e`）|
| 19.608 ns | 51 MHz | +1208 ps | **20.815 ns** | ✗ WNS −1.207，3,337 端点（`p49r51`）|
| 19.231 ns | 52 MHz | +1217 ps | 21.120 ns | ✗ WNS −1.120，40 端点（`p48r50b`）|
| 19.231 ns | 52 MHz | +1072 ps | 21.600 ns | ✗ WNS −1.595（`p48r50`）|

三次 51/52 MHz 尝试都**布通了**（0 未布通，264 / 208 / 707 轮），只是布出来比要求慢 1.2~2.0 ns。
51 MHz 那次连摆放都还是 +1208 ps（18.40 ns），布线却掉到 20.815 ns —— **摆放估计完全不预示布线**。

⇒ **48 → 50 MHz 是这套 RTL 能拿的最后 4.2%**。再往上必须切流水，
而切流水要 CPI 预算，CPI 预算要 v16 的 M1（4 发射 + 16 B/拍取指）。这条顺序不可绕。

`pangoriscv_top.v` 的 PLL 注释里记了这张表，防止下一轮再去试 51/52。
