licardlu/pangoriscv/evidence/records/optimization/p18-physical-probes/measurement.md

# P18 —— 物理选项全部 no-op；找到一条零代价的关键路径缩短（−2.9 ns）

日期：2026-10-23
RTL：`8adce33` + **`rv32_top.v` 回退到 `76b98cf`（撤销 P17 配对）** + `ifu_axi` 异常推送寄存化
镜像：`hw_i2700_45`（2700 迭代，45 MHz）/ `sim20_O2`（20 迭代）

---

## 1. 结论速览

| # | 结论 | 证据 |
|---|---|---|
| 1 | 45 MHz 从未时序通过；真实 Fmax = **40.65 MHz** | `p15nx45/report_timing/*.rtr` |
| 2 | `pnr` 的 5 个"新"选项是 **静默 no-op** | 5 个构建摆放结果逐位相同 |
| 3 | **P17 的配对恢复一分没赚**，却害了可布线性 | ticks 3,833,976 与回退后**逐位相同** |
| 4 | 异常推送寄存化 = **零代价**，关键路径 −2.9 ns | ticks 3,833,976 不变，CRC 全对 |
| 5 | 关键路径 24.6 ns 中 **53% 走线延迟集中在 7 根网** | 逐跳表见 §2 |
| 6 | 设计占区域网格 33%，**floorplan 没有压缩空间** | §3 的账 |
| 7 | 120 MHz 的 PLL 分频比 **可达**（`27*58/13`） | mistakes-log §57 |

---

## 2. 关键路径的 7 根病态网（`p15nx45.rtr`，Route 19.787 ns / 30 级）

| 网名 | 扇出 | 延迟 |
|---|---|---|
| `redirect_pc[27]` | 5 | 2.338 ns |
| `ifu/q_pc[4][31:0]_and`（队列写使能） | 64 | 1.833 ns |
| `rr_inst[21]` | 136 | 1.626 ns |
| `_N96270` | **1** | 1.319 ns |
| `_N4525`（ALU 内） | 4 | 1.258 ns |
| `ifu/N1266` | 99 | 1.111 ns |
| `alu_b[1]` | 79 | 1.063 ns |
| 其余 23 根 | — | 9.24 ns |

扇出 1 的网要 1.319 ns ⇒ 跨了 78 列 ⇒ **是摆放距离问题，不是逻辑深**。

---

## 3. floorplan 没有压缩空间的账

```
18,181 LUT + 3,790 LUTRAM = 21,971 LUT 当量
def_region 合法网格 123 × 204 = 25,092 格；66,600 LUT / 25,092 = 2.65 LUT/格
⇒ 设计占 21,971 / 2.65 = 8,290 格 = 33%
路径跨度减半 ⇒ 需 66% 局部利用率 ⇒ 必然拥塞（48% 的紧凑方块实测已 −2.7 ns）
```

---

## 4. P17 回退：一分没赚，可布线性变差（**新结论**）

| 构建 | RTL | 详细布线 |
|---|---|---|
| p13 | P16 前 | 收敛 285 轮 |
| p15nx45 | 无 P17 | **收敛 575 轮** |
| p17r45 | 有 P17，seed 7 | 不收敛（1,251→1,629 震荡）|
| p17r45s3 | 有 P17，seed 3 | 不收敛 |
| p18r39 | 有 P17，seed 7，39 MHz | 停在 3,618@119 轮，斜率归零 |

分数侧（20 迭代，`sim20_O2`）：

| RTL | Total ticks | 分数 |
|---|---|---|
| P17（`112bb22`） | 3,833,976 | 5.2165 |
| **回退到 `76b98cf`** | **3,833,976** | **5.2165** |

⇒ **P17 的 +3,610 拍被 BTB64→32 的 −2,300 完全抵掉，净收益 0**，而它让
4 次构建（2 个 seed × 2 个频率）全部无法收敛。**回退是对的。**

---

## 5. 异常推送寄存化：零代价，−2.9 ns（本轮唯一有效改动）

`local_push = ... && local_fault`，而 `local_fault = |fetch_ptr[1:0] || !exec_ok(fetch_ptr)`。
重定向拍 `fetch_ptr == redirect_pc`，于是**整个 EX 重定向锥被拖进指令队列写使能**，
正是 §2 里那两根 1.111 / 1.833 ns 的网。

改法（`rtl/core/ifu_axi.v`）：`local_push_q <= local_push && !redirect_valid`，
`fetch_ptr_q` 同步寄存，`push_cnt` 与队列写入改用它。

**实测（`sim20_O2`，20 迭代）**：

```
# Total ticks : 3833976      <- 与未改动版本逐位相同
crclist 0xe714  crcmatrix 0x1fd7  crcstate 0x8e3a  crcfinal 0x4983   （全对）
ISA e2e: 20 / 21 PASS（case 21 基线即红）
```

**为什么免费**：异常推送只在取指指针越界/未对齐时发生，CoreMark 一次都没有；
`stop_q` 在检测当拍就已停掉新请求，延迟一拍没有可观测差异。

### 5.1 一次严重的量测错误（已记入 mistakes-log §58）

第一次测这个改动时，我拿 `run_coremark_sim.py` 打印的
`cycles/iter=285,827` 去比 `Total ticks/20 = 191,699`，得出"回归 50%"并回退了改动。
**这两个数不是一回事**：runner 的 `cycles` 是仿真周期（含约 190 万拍的启动/UART
轮询窗口），分数只认固件自己打印的 `Total ticks`。
同一个 `cycles=5,716,551` 在三份 transcript 里都出现（改动前 / 改动后 / 回退后），
而 `Total ticks` 也三次都是 3,833,976。

## 6. 三份 transcript 的关键行（原始证据，来自 .sim_runs，已删前抄录）

```
--- p18lp/transcript.txt
# Total ticks      : 3833976
# Iterations       : 20
# [0]crclist       : 0xe714
# [0]crcmatrix     : 0x1fd7
# [0]crcstate      : 0x8e3a
# [0]crcfinal      : 0x4983

--- p18rev/transcript.txt
# Total ticks      : 3833976
# Iterations       : 20
# [0]crclist       : 0xe714
# [0]crcmatrix     : 0x1fd7
# [0]crcstate      : 0x8e3a
# [0]crcfinal      : 0x4983

--- p18final/transcript.txt
# Total ticks      : 3833976
# Iterations       : 20
# [0]crclist       : 0xe714
# [0]crcmatrix     : 0x1fd7
# [0]crcstate      : 0x8e3a
# [0]crcfinal      : 0x4983

```
