licardlu/pangoriscv/evidence/records/optimization/p17-pairing-restore/measurement.md

# P17 —— 45 MHz 交付尝试与"布线抽签"结论

日期：2026-10-23
RTL：`112bb22`（P17：恢复 lane0 访存 + lane1 控制的配对；BTB 默认 32）
镜像：`hw_i2700_45`（2700 迭代）

---

## 1. 分数（仿真，CRC 全对）

| 配置 | ticks(20it) | 分数 | LUT |
|---|---|---|---|
| 交付基线 | 3,833,976 | 5.213 | 18,157 |
| P16（配对禁止 + BTB64） | 3,802,578 | 5.260 | 18,957（**不收敛**）|
| **P17（恢复配对）+ BTB32** | **3,833,976** | **5.2165** | **18,181** |
| P17 + BTB64 | — | ~5.298（推算）| 18,957（**不收敛**）|

注：P17+BTB32 的 ticks 与交付基线**完全相同**是巧合——P17 赚 3,610/迭代，
BTB64→32 亏 2,300/迭代，两者相抵（3,610−2,300≈1,300，再叠加配对带来的
其它桶变化，净值落在同一 tick 上）。**分数与频率无关**，所以这一版无论
跑 36/40/45 MHz，分数都是 5.2165。

## 2. 45 MHz 时序

```
p16r45c (BTB64) : Worst slack is 1548, TNS 0     (22.22 ns)
p17r45  (BTB32) : Worst slack is 1462, TNS 0     (22.22 ns)
```
⇒ **P17 恢复配对的时序代价只有 0.086 ns**。原先担心的 1~1.5 ns 高估了一个数量级，
因为 S2 已经把 D-cache 请求路径从 lane-0 重定向锥里摘掉了。
⇒ **P16 的配对禁止是近纯损失**：3,610 拍/迭代换 0.086 ns。

## 3. 布线：同一个器件、同样的面积，一过一个不过

| 构建 | 约束 | seed | LUT | 详细布线结果 |
|---|---|---|---|---|
| p13（已交付 36 MHz） | 36 MHz | ? | ~18,400 | 收敛 285 轮 |
| p15nx45 | 45 MHz | 7 | 18,157 | **收敛 575 轮** |
| p16r45c | 45 MHz | 7 | 18,957 | 不收敛（第 11 轮 17,251，斜率 800/轮）|
| p17r45 | 45 MHz | 7 | 18,181 | **不收敛**：震荡 1,251@242 → 1,378@334 → 1,629@400 → 1,607@467 |

同 seed、同参数、面积只差 24 LUT（0.13%），一个收敛一个不收敛。

### 3.1 判读

**在这个利用率（27.3% LUT / 19.1% LUTRAM）上，详细布线能否收敛是抽签，
不是面积或算力的确定函数。** p15nx45 是一次好运的抽样。

这与项目既有经验一致（`MEMORY.md`：靠换 seed 重跑抽签）。因此：
- **不要**把"某个构建收敛了"当成"这套 RTL 能收敛"；
- 每次频率尝试都要预留"多次抽签"的时间预算（每次约 1.5 h）；
- 想摆脱抽签，必须把面积降到拐点**以下**（经验：18,000 LUT 以下成功率高，
  18,950 以上为 0），而不是靠 seed。

### 3.2 由此得到的策略

1. 交付口径固定 **BTB32 / 18,181 LUT**；
2. 45 MHz 用 seed 3 重抽（`p17r45s3`）；失败则降到 40/36 MHz（约束更松，
   历史 2/2 收敛）；
3. **分数已经是 5.2165，与频率无关**——所以频率抽签失败不会损失分数，
   只损失"最高时钟频率"那一项指标。

## 4. 功能验证

- CoreMark 20 迭代：`crcfinal 0x4983`，crclist 0xe714 / crcmatrix 0x1fd7 /
  crcstate 0x8e3a，全部与交付基线一致；
- ISA e2e：**20 / 21 PASS**，唯一失败的 case 21 在基线上同样失败。

## 5. 面积

```
Total LUTs: 18,181 of 66,600 (27.30%)
LUTs as dram: 3,790 of 19,900 (19.05%)
```
