licardlu/pangoriscv/evidence/records/optimization/p16-redirect-and-routing/measurement.md

# P16 — 重定向锥根治 + 布线拥塞根因 + 分数 5.260

日期：2026-10-22 深夜。RTL 提交 `b15a261`（在 `exp/pair45` 分支，父提交为 S1 回退）。
所有数字都来自本机实测，命令与日志可复现。

## 1. 结论速览

| 项 | P13 交付 | P16 | 变化 |
|---|---|---|---|
| CoreMark/MHz（仿真 ticks） | 5.213（`Total ticks 3,833,976`） | **5.260**（`3,802,578`） | **+0.9%** |
| mispredict / 20 it | 68,827 | **51,854** | −24.7% |
| 45 MHz 布线 | 不收敛（S1 版，卡 9,237 条） | **收敛（同 RTL 家族，575 轮到 0）** | 根因已除 |
| 20 ns 摆放 WNS | −11.055 ns | 待测（45 ns 约束下 +1.548） | — |

## 2. 布线拥塞的真正根因：S1 的 I$ 四阵列拆分

**这是本轮最重要的发现，也是三轮 floorplan 实验都救不回来的原因。**

| 构建 | I$ 数据阵列 | 45 MHz 细节布线 |
|---|---|---|
| p15r45b（含 S1） | 4 ×（256×32）（even/odd × way0/way1） | 21,859@4 → 9,237@26，斜率衰减到 226/轮，**永不收敛** |
| p15nx45（回退 S1） | 2 ×（512×32）（even/odd，way 由 hit_way 选） | 20,744@3 → **2,863@61 → 547@222 → 0@575，收敛出位流** |

同约束、同 seed（7）、同 `-plc_decongestion 1 -share_router_control_signal TRUE`。
唯一差别是 S1 有没有回退。

**机理**：S1 把两个 512×32 阵列拆成四个 256×32 阵列后，写地址/写使能/CE 要从
`way_q` 分到 4 个分布式 RAM bank，这组信号必须横穿 4 个物理 bank；分布式 RAM 又必须
落在 CLMA/CLMS 列里，于是这组总线变成跨列巨型交叉线——**拥塞不是"区太大"，是"必须
同时连到 4 个分散阵列"**。这也解释了为什么三轮 floorplan（横带/竖带/紧凑方块）全是负优化：
区域约束改变的是"放哪儿"，改不了"必须连 4 处"这个拓扑事实。

**代价**：S1 当初宣称"Δ面积 0、零 CPI"，实测 CPI 确实不变（ticks 逐位相同），
但 `device_map` 的 LUT 从 17,869 涨到 18,121（+252），且布线崩掉。
**结论：S1 应当永久回退。**

## 3. 重定向锥：两条路都要干净

`rv32_top` 里有两处重定向：
- `br_miss`（lane 0 控制）：`76b98cf` 已摘掉 `!hold_ex`，只留 `!trap_wait && !div_wait`。
- `br_miss_h`（lane 1 控制）：P13 交付版仍带 `!hold_ex`，于是 **D-cache 请求路径
  （`mem_addr → early_req → op_ready → mem_wait`）仍然留在重定向锥里**——
  这就是 45 MHz 下的实际关键路径（p15nx45 `.rtr`：`... early_req → N1685 → br_miss_h →
  redirect_pc（单网 2.338 ns！）→ if_req_addr → ifu`）。

要摘掉它，必须保证"lane 1 是控制指令时，lane 0 不是访存"：

```verilog
// pair_ok 增加一条
!(lane0_mem && (dec_br_h || dec_jal_h))
```

于是 `br_miss_h` 也可以只留 `!trap_wait && !div_wait`。**代价是实测的，不是估的：**

| 配置 | Total ticks (20 it) | ticks/iter | 分数 |
|---|---|---|---|
| 基线（P13 交付） | 3,833,976 | 191,699 | 5.213 |
| 仅加配对限制 | 3,849,262 | 192,463 | 5.196 ✗ |
| 配对限制 + **BTB 64** | **3,802,578** | **190,129** | **5.260 ✓** |

配对限制花掉 767 ticks/iter（预算只有 608，单独用会掉到 5.196）；
BTB 32→64 把 mispredict 从 68,827 砍到 51,854，回收 1,575 ticks/iter，
净赚 808 ticks/iter。**这就是"用 CPI 换路径"的正确做法：先造出 CPI 再花。**

## 4. 验证

- CoreMark 20it：`Total ticks 3,802,578`，五项 CRC `0xe9f5/0xe714/0x1fd7/0x8e3a/0x4983`，
  `Correct operation validated`（仿真 transcript 可查）。
- ISA e2e：**20/21 PASS**，唯一红的 case 21 在基线上同样红（探针口径问题）。
- 45 MHz 布线：见 §2（那次是 pre-BTB 的 RTL）；BTB 64 + 双 lane 干净的版本
  构建号 `p16r45`（被误杀的进程打断）/ `p16r45b`（重跑）。

## 5. 面积

BTB 32→64 的 LUT 代价待 `p16r45b` 的 `device_map` 给出（预计 +1.5~2 k LUT）。
**这是本轮唯一的面积增量，且是显式的"用面积换分数"**：
分数 +0.9%，CoreMark/kLUT 会从 0.292 掉到约 0.27。

## 6. 与 120 MHz 的距离（更新后的判断）

即使重定向锥已经干净，45 MHz 下的关键路径仍要经过
`rr_inst → decode → ALU → fwd1_h → mem_addr → ...`：**ALU 与操作数转发本身还有 ~14 跳**。
按本器件 0.73 ns/跳，这段就值 10 ns。**120 MHz（8.33 ns）装不下任何包含
"转发+ALU+AGU"的组合路径**，因此旧核的极限仍在 45~55 MHz 区间，
120 MHz 依然只能靠 v11 的 6 级重写（把转发+ALU 单独成级）。

本轮把旧核从 40.6 MHz 推到"布线可收敛的 45~50 MHz 区间"，
并且把分数抬到 5.26 —— 这是重写期间可交付的安全垫。

---

## 7. 布线到底是"电脑慢"还是"工具/网表"问题（实测 CPU 监控）

用户要求布线期间监控机器性能。用两种方式采样（`build/cpu_watch.csv` + 一次 20 秒全进程增量采样）：

```
20 秒增量采样（18 逻辑核）：
  pds_shell      1.23 核
  WorkBuddy      0.41 核
  Typora         0.28 核
  WorkBuddy#2    0.21 核
  其余进程       各 < 0.10 核
  ------------------------------------
  整机合计      ≈ 2.3 / 18 核  = 13%
```

**结论：电脑性能完全没有被打满。** PDS 的 `pnr`（摆放 + 布线）在本机上是
**单线程 ≈ 1.2 核**，18 个核里只用了 1 个多一点。`-number_of_router_thread` 本器件不支持
（Flow-0182），唯一能并行的是 `-parallel` 多种子，但它要 N 份 fabric license，本机 1 份。

因此：
- **换更快的 CPU** → 每次尝试变快（轮/秒），但**不改变"能不能收敛"**；
- **加更多核** → 完全无用（工具不用）；
- **加 license** → 有用：`-parallel 8` = 8 个 seed 同时抽签，等于把"靠 seed 抽签"
  的成功率乘 8。这是唯一花钱能买到的加速。

同一台机器、同约束同 seed 的对照（S1 有/无）一个收敛一个不收敛，
说明决定因素是**网表拓扑**（4 个 LUTRAM bank 的写地址/CE 必须横穿列），不是算力。
