licardlu/pangoriscv/evidence/records/optimization/p13-board-verify/p13board36h_36mhz_timing_summary.txt

Design Summary : Some Constraints Violated.

Setup Summary(Slow Corner):
****************************************************************************************************
                                                                          TNS Failing      TNS Total
 Launch Clock           Capture Clock              WNS(ns)     TNS(ns)      Endpoints      Endpoints
----------------------------------------------------------------------------------------------------
 core_clk               core_clk                     1.200       0.000              0          66063
====================================================================================================

Hold Summary(Slow Corner):
****************************************************************************************************
                                                                          THS Failing      THS Total
 Launch Clock           Capture Clock              WHS(ns)     THS(ns)      Endpoints      Endpoints
----------------------------------------------------------------------------------------------------
 core_clk               core_clk                    -0.041      -0.123              3          66063
====================================================================================================

Recovery Summary(Slow Corner):
****************************************************************************************************
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
----------------------------------------------------------------------------------------------------
====================================================================================================
