licardlu/pangoriscv/evidence/records/optimization/p13-board-verify/p13seed7_40mhz_timing_summary.txt

Design Summary : All Constraints Met.

Setup Summary(Slow Corner):
****************************************************************************************************
                                                                          TNS Failing      TNS Total
 Launch Clock           Capture Clock              WNS(ns)     TNS(ns)      Endpoints      Endpoints
----------------------------------------------------------------------------------------------------
 core_clk               core_clk                     0.558       0.000              0          66481
====================================================================================================

Hold Summary(Slow Corner):
****************************************************************************************************
                                                                          THS Failing      THS Total
 Launch Clock           Capture Clock              WHS(ns)     THS(ns)      Endpoints      Endpoints
----------------------------------------------------------------------------------------------------
 core_clk               core_clk                     0.033       0.000              0          66481
====================================================================================================

Recovery Summary(Slow Corner):
****************************************************************************************************
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
----------------------------------------------------------------------------------------------------
====================================================================================================
