licardlu/pangoriscv/evidence/records/optimization/area-M4a/measurement.md

# area-M4a：取指队列 DEPTH 16→8 —— 实测 LUT −1,107 / FF −1,306

日期：2026-10-21
阶段：`module-area-plan.md` 的 **M4a**
性质：**参数改动**（`ifu_axi` 的 `DEPTH` 默认值 16 → 8），无逻辑改动

---

## 1. 做了什么

`rtl/core/ifu_axi.v`：

```verilog
parameter integer DEPTH=8     // was 16
```

队列每个条目 = 5 个 32 位数组（`q_pc/q_inst/q_pred/q_inst_hi/q_pred_hi`）
+ `q_cause[4:0]` + `q_pair/q_fault` ≈ 167 位；8 条目可省 8×167 ≈ 1,336 FF。

**为什么 8 是"已测配置"**：单元测试从一开始就用 `ifu_axi #(.DEPTH(8))`
（`tb/unit/tb_ifu_axi.sv`、`tb/axi/tb_ifu_axi_engine.sv`），所以 8 是回归覆盖过的深度；
预取本来就受 `count + 2*ocnt + 2 <= DEPTH` 约束，变浅只缩短预取跑道。

## 2. 功能回归

| 检查 | 结果 |
|---|---|
| 20 迭代 CoreMark A/B（`area20` 镜像，CACHE on） | **PASS**，且略有变快 |

| 项 | M3（DEPTH=16） | M4a（DEPTH=8） | Δ |
|---|---:|---:|---:|
| cycles | 7,681,846 | **7,677,085** | **−4,761（−0.062%）** |
| retires | 6,779,785 | 6,779,777 | −8（启动路径差异） |
| IPC | 0.8826 | 0.8831 | +0.0005 |
| mispred | 137,933 | **137,933** | 0 |
| 五项 CRC | `e9f5/e714/1fd7/8e3a/4983` | 同 | 0 |

> 判据是"不回退"（≤+0.5%），实测是 −0.06%，**不回退**。

## 3. 面积结果（交付 profile：PERF off）

| 指标 | M3 后 | M4a 后 | Δ |
|---|---:|---:|---:|
| LUT | 19,113 | **18,006** | **−1,107** |
| FF | 11,183 | **9,877** | **−1,306** |
| LUTRAM | 3,628 | 3,628 | 0 |
| DRM | 4 | 4 | 0 |
| **站点 S** | 33,924 | **31,511** | **−2,413** |

LUT 也掉 1,107：队列索引/指针/选择逻辑（`head_q/tail_q/count_q` 与 5 个数组的读多路器）
随深度减半一起变小。

## 4. 门禁

```
metric     previous     actual      delta
LUT          19,113     18,006      -1107
FF           11,183      9,877      -1306
LUTRAM        3,628      3,628         +0
DRM               4          4         +0
APM               6          6         +0
S            33,924     31,511      -2413
PASS
```

## 5. 证据

| 文件 | 内容 |
|---|---|
| `used_perf_off.txt` | 交付 profile 利用率表 |
| 构建目录 | `firmware/code/build/area_m4a`（未入库） |

## 6. 与 M4b 的关系（计划更正）

原计划 M4b 要删 `q_pred_hi`（估计 −512 FF）。**这个假设是错的**：
`q_pred_hi` 存的是 BTB 第三个查表口对**配对第二条（PC+4）**的预测目标，
不是"PC+4 可派生"的常量——配对第二条若本身是控制转移，它的下一 PC 只能来自 BTB。
要删它必须在消费端再加一个 BTB 查表口（约 +100 LUT），净收益只有约 −400 站点，
属于功能重构而非 FF 裁剪。**本步先跳过**，并在 D1 的 §11 记为"已评估、暂不做"。
