licardlu/pangoriscv/evidence/records/optimization/P16/verify_rerun_768.txt

=== compile work (working tree) ===
  compile ok, 1 error lines
=== run work ===
CoreMark fetch A/B (image D:\FPGA_Project\zi_guang_tong_chuang\pangoriscv\firmware\code\build\native_software\coremark\performance\score768)
baseline revision HEAD; replaced files: rtl/core/lsu_axi.v
wall clock 33.4 min

work  PASS ticks=287211317 cycles=288997740 retires=222179042 IPC=0.7688
      validated=True under-10s-rule=False
      crc seed=0xe9f5 list=0xe714 matrix=0x1fd7 state=0x8e3a final=0x3c53
      traps=0 faults=0
      store req=10884894 resp=3571 hold=691 total=10889156
