licardlu/pangoriscv/evidence/records/optimization/P16/measurement.md

# P16 · AXI RAM 猝发气泡：每拍 3 个周期 → 节省读填充 8 拍（2026-10-18）

> ## ⚠️ 成绩有效性声明（必读）
>
> 本文件中的 CoreMark 分数（评分项 ①）**来自 RTL 周期精确仿真，不是 FPGA 板上实测**。
> 按本仓库既定策略（`.githooks/pre-push` 与 `.gitignore` 中关于
> `evidence/records/coremark-sim-*` 的规则）以及赛题 §4「可综合可上板：分数必须来自
> FPGA 上真实运行，仿真数据不能替代实测」与 §7 诚信边界：
>
> **仿真跑分不是有效成绩，不得作为提交成绩使用。**
>
> 只有在真实开发板上复现、并把串口实物输出与 ILA 波形补齐之后，① 才能报分。
> ②（时序收敛）与 ③（综合资源）是真实工具产物，可以独立成立。

> 结论：**ticks −2.35%**（7,658,647 → 7,478,647，20 迭代；CoreMark/MHz +2.42%），
> CoreMark/MHz **2.6109 → 2.6740（+2.42%）**，面积 **−2 LUT / −2 FF（完全中性）**。
> 交付跑分：768 迭代、ticks **287,211,317**、10.64 s、`Correct operation validated`；
> 27 MHz 与 50 MHz 约束均 **All Constraints Met**。
>
> **这一步是纯"气泡"清除**：没有新增功能，只是删掉 RAM 猝发读里两个白等的状态周期。

---

## 1. 先量：I-Cache 缺失的 43 拍花在哪

上一轮遗留的最大单项是 `if_wait`（占计分窗口额外开销 40.5%）。加 `ICACHE_PATH` 探针
（`!report_seen` 门控）后，I-Cache 各状态拍数与缺失次数对上了：

```
ICACHE_PATH idle=1620843 ar=46997 fill=475410 missrd=18285 resp=7149637 fault=0
i_miss = 18289
```

| 状态 | 拍数 | 每缺失 |
|---|---|---|
| `ST_AR`（等 arready） | 46,997 | 2.57 |
| **`ST_FILL`（8 拍猝发）** | **475,410** | **26.0** |
| `ST_MISS_RD` | 18,285 | 1.00 |

**8 拍用了 26 拍 = 每拍 3.25 个周期。** 这不是 DRAM 延迟，是 `axi_ram` 自己的状态机：

```verilog
READ_RESP:  // 交出这一拍
READ_MEM:   // read_data<=mem[idx]   ← 同步读，必须 1 拍
READ_WAIT:  // if(delay_left==0) → READ_RESP
```

`READ_DELAY` 默认 0，但 `READ_WAIT` 照样占满一整拍才转出去——**纯浪费**。

## 2. 改动（`rtl/perips/axi_ram.v`，两处，共 9 行）

```verilog
READ_MEM: begin
    if(read_good) read_data<=mem[read_index];
    else read_data<=0;
    delay_left<=READ_DELAY;
    // READ_DELAY=0 表示"没有建模延迟"，数据寄存器在这一拍已经装好，
    // 下一拍就是有效节拍：直接进响应。
    if(READ_DELAY==0) state<=READ_RESP;
    else              state<=READ_WAIT;
end
```

这就把每拍 3 周期降到 2 周期，`fill` 从 26 拍降到 18 拍/缺失。

## 3. 效果（同镜像 20 迭代，每步只改一处）

| 指标 | P14 | P16 | 变化 |
|---|---|---|---|
| ticks | 7,658,647 | **7,478,647** | **−2.35%** |
| IPC | 0.6947 | **0.7083** | +2.0% |
| `ICACHE_PATH fill` | 475,410 | **329,130** | −146,280 |
| `if_wait` | 788,983 | **654,975** | −134,008 |
| 五项 CRC | — | 逐项相同 | 架构等价 |
| traps / faults | 0 / 0 | 0 / 0 | — |

## 4. 交付跑分（镜像 `score768`，768 迭代）

```
每迭代 ticks = 7,478,647 / 20 = 373,932
N ≥ ceil(10.5 × 27e6 / 373,932) = 759   → 取 768（10.64 s）
```

```
Total ticks      : 287211317
Total time (secs): 10
Iterations/Sec   : 76
Iterations       : 768
seedcrc          : 0xe9f5
[0]crclist       : 0xe714
[0]crcmatrix     : 0x1fd7
[0]crcstate      : 0x8e3a
[0]crcfinal      : 0x3c53
Correct operation validated. See readme.txt for run and reporting rules.
```
> 注：固件的 `Total time (secs)` 与 `Iterations/Sec` 是**整数截断**打印的（`core_portme.h` 里 `HAS_FLOAT 0`，见 `native-basic-final-status.md`）。所以它们的值来自 `floor(ticks/27e6)` 与 `iterations / 那个整数`，**不能用它们反推分数**——分数必须用 `Total ticks` 计算，即 `iterations / ticks × 1e6`。

| 项 | 值 |
|---|---|
| ticks / cycles / retires | 287,211,317 / 288,997,740 / 222,179,042 |
| **IPC** | **0.7688** |
| **CoreMark/MHz** | **2.6740** |
| traps / faults | 0 / 0 |

> 迭代下限 759，实取 768 → 10.64 s，满足 ≥10 s。与 P14 同镜像同迭代数，
> `crcfinal` 同为 `0x3c53`，可直接横比 ticks。

## 5. PDS 实现

| 约束 | 结果 | Setup WNS | Hold WHS | 失败端点 | Total LUTs |
|---|---|---|---|---|---|
| 37.037 ns（27 MHz，交付） | **All Constraints Met** | **+15.404 ns** | **+0.025 ns** | **0 / 54,345** | **13,574** |
| 20 ns（50 MHz，过约束） | **All Constraints Met** | **+0.862 ns** | **+0.087 ns** | **0 / 54,685** | 13,764 |

- Total Registers **8,637**（比上一版少 2，`READ_WAIT` 路径被常量折叠）
- 交付位流 `pangoriscv_i768.sbit`，3,791,112 B，
  SHA256 `F7B135AE975CCDE775D5B046AFC06BF7BE0EC5D3309996B0E36EEF471BA42F8D`
- **收敛过程（要记下来）**：27 MHz 试了三个种子——`23`（两档阈值 500/700 结果完全相同，
  都是 3 个端点 −0.012）、`41`（路由器不收敛，1042 次迭代还剩 1096 根未布线）、
  `11` 通过。**说明 hold 余量对阈值的响应很差，主要靠种子运气**；
  50 MHz 用 `23` 一次通过。

## 6. 资源代价（受控 A/B：只替换 `rtl/perips/axi_ram.v`）

| 项 | 基线 `HEAD`（P14） | 本版（P16） | 变化 |
|---|---|---|---|
| Total LUTs | 13,576 | **13,574** | **−2（−0.01%）** |
| ├ as logic | 10,635 | 10,633 | −2 |
| └ as DRAM | 2,941 | 2,941 | 0 |
| Total Registers | 8,639 | **8,637** | **−2** |

**面积完全中性**——这是一次纯粹把白等的状态周期删掉的改动。

## 7. 正确性与回归

| 门 | 结果 |
|---|---|
| `run_unit_tests.py --case all` | **5/5 PASS** |
| `run_isa_e2e.py --cases all` | **15/15 PASS** |
| `run_ram_tests.py --seeds 20` | **40/40 PASS**（RAM 自己的用例，最关键） |
| `run_halt_reset_tests.py` | **5/5 PASS** |
| `run_ifu_engine_tests.py --seeds 20` | 20/20 PASS |
| `run_dcache_tests.py` / `run_icache_tests.py` | PASS / PASS |
| CoreMark 五项 CRC | 与基线逐项相同；交付跑分 `Correct operation validated` |

## 8. 被测量否决：R 拍预取（曾经拿到 +2.15%，但主动回退）

在 `READ_RESP` 里顺便把下一拍的数据预取好（`read_data<=mem[read_index+1]`，并留在
`READ_RESP`），可以把每拍降到 **1 周期**，`fill` 从 18 拍进一步降到 **11 拍**：

| 版本 | ticks | CoreMark/MHz | `fill`/缺失 |
|---|---|---|---|
| P14 基线 | 7,658,647 | 2.6109 | 26 |
| 只跳 `READ_WAIT`（本版，20 迭代推算 / 768 迭代实测） | 7,478,647 | **2.6743 / 2.6740** | 18 |
| **再加预取** | **7,321,147** | **2.7319** | **11** |

**但这版被回退了**：`run_halt_reset_tests` 的场景 1/3（"读进行中 halt/reset"，
该测试把 `READ_DELAY` 设成 60）开始超时——现象是**那个 44 字节的测试程序似乎根本没发出
数据读**。我把注入点从 `LSU_READ_WAIT` 改到 AXI `AR` 握手（和写那侧一致的做法）之后
**依然超时**，说明不是缺观察点，而是取指流在 `READ_DELAY>0` 下真的变了。

ISA 15/15、ram 40/40、CoreMark CRC 在 `READ_DELAY=0` 下都正常，所以这只在"建模了延迟"
的那条路径上暴露。**这是一个我当晚没能解释清楚的行为改动，所以不上线**——
已在代码里留下注释说明来龙去脉，并注明"若要重启此项，先补 `READ_DELAY>0` 的专项测试"。

教训：`READ_DELAY` 这类"只为测试台存在"的参数，其路径同样需要被认真对待；
把常数折叠掉之后，测试和实际硬件跑的是**两条不同代码路径**，不能只凭一侧通过就放行。

## 9. 同轮排除的其它项（含实测数字）

| 方向 | 实测 | 结论 |
|---|---|---|
| store 队列（CPU 不等写引擎） | `request_store=397,316` 占全部"引擎忙"停顿的 **99.2%**（load 仅 3,351） | 需重写 D-Cache 写路径（引擎单笔未完成），估值 +3.5~4.5%，风险高，**本轮不做** |
| I-Cache 2 KB→4 KB | ticks −3.44%，但 LUT **+8.04%** → ③ −4.11% | **净亏，已回退**（上一轮） |
| 返回地址栈 RAS | 返回仅占预测失败 11.4%（`MISPRED_MIX ret=17,574`） | 值约 0.5%，**不值** |
| 分支预测器扩容 | 预测失败 308K 拍（16.1%） | BTB 加倍要 +15~32% LUT，③ 净亏 |

## 10. 累计成绩

| 阶段 | CoreMark/MHz | LUT | CoreMark/kLUT |
|---|---|---|---|
| S0 基线（store 优化前） | 1.3054 | 12,572 | 0.1038 |
| P2' store 后台排空 B | 1.4342 | 12,622 | 0.1136 |
| P7 取指吞吐 | 1.6815 | 13,018 | 0.1292 |
| P8 访存快发 | 1.8622 | 13,059 | 0.1426 |
| P9 完成提前报 | 2.0843 | 13,099 | 0.1591 |
| P10 零延迟命中 | 2.3708 | 13,558 | 0.1749 |
| P13 读命中不阻塞 | 2.5674 | 13,558 | 0.1894 |
| P14 store 当拍确认 | 2.6109 | 13,576 | 0.1923 |
| **P16 猝发气泡清除（本版）** | **2.6740** | **13,574** | **0.1970** |

**相对 S0：+104.84% CoreMark/MHz、+89.72% CoreMark/kLUT，面积仅 +7.97%。**

## 11. 距 3.0 还差什么（算清楚了）

要 3.0 需要再 **+12.2%**（IPC 0.769 → 0.867）。计分窗口内的账（P16 状态，20 迭代）：

| 来源 | 拍数 | 占比 | 可行性 |
|---|---|---|---|
| `if_wait`（余下的 I-Cache 缺失） | ~655 K | 8.8% | 4 KB 净亏；预取因未解释的行为差异回退 |
| store 占 EX（2.3 拍/笔） | ~680 K | 9.1% | **store 队列**：唯一还能拿 3.5~4.5% 的方向，要重写写路径 |
| 分支预测失败 | ~308 K | 4.1% | 只能加大 BTB，③ 净亏 |

**三项全拿也大约到 2.9。** 3.0 需要"store 队列 + 更大的 I-Cache + 更强的分支预测"三者叠加，
而那会把面积推高 20% 以上，③ 反而下降。**在 13.6 K LUT 这个面积档上，2.67 已经是
效率前沿**；再往上属于换架构（双发射 / 2 笔未完成写）而不是继续挤。
