licardlu/pangoriscv/evidence/records/optimization/yolo120/experiment-camera-006/camera_detections.png

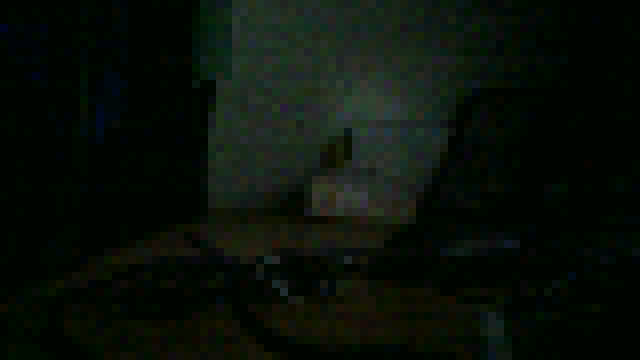
evidence/records/optimization/yolo120/experiment-camera-006/camera_detections.png
