licardlu/pangoriscv/evidence/records/validation_20261104/dataset_metrics/sample_07.png

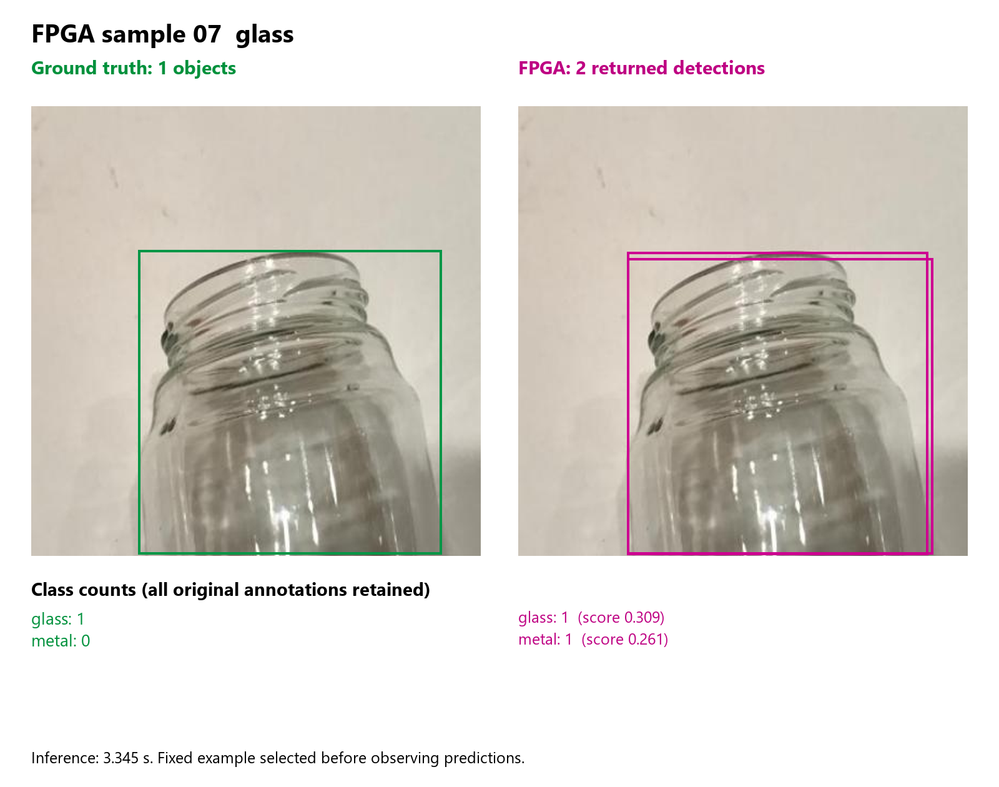
evidence/records/validation_20261104/dataset_metrics/sample_07.png
