licardlu/pangoriscv/evidence/records/validation_20261104/dataset_metrics_partial/confusion_matrix.png

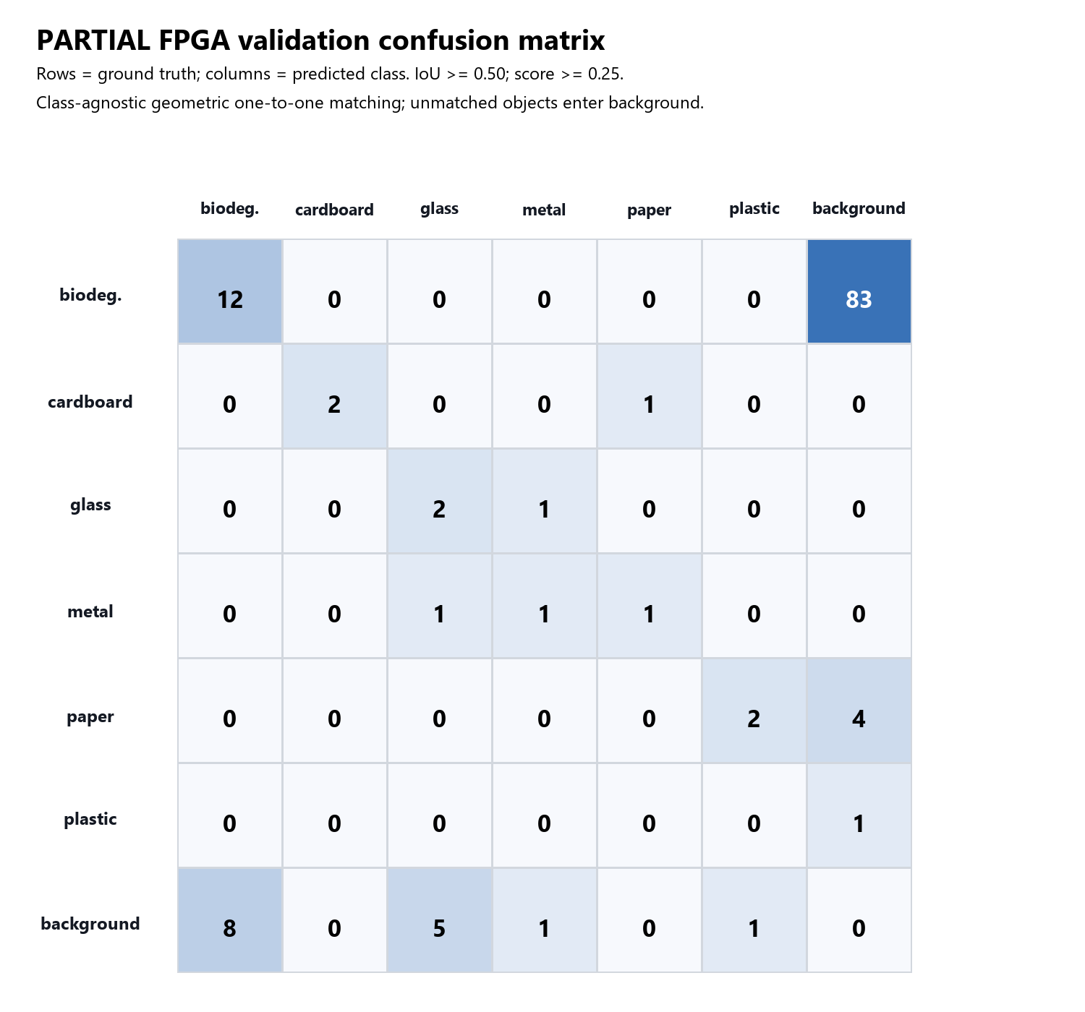
evidence/records/validation_20261104/dataset_metrics_partial/confusion_matrix.png
