licardlu/pangoriscv/evidence/records/validation_20261104/dataset_metrics_partial/per_class_metrics.png

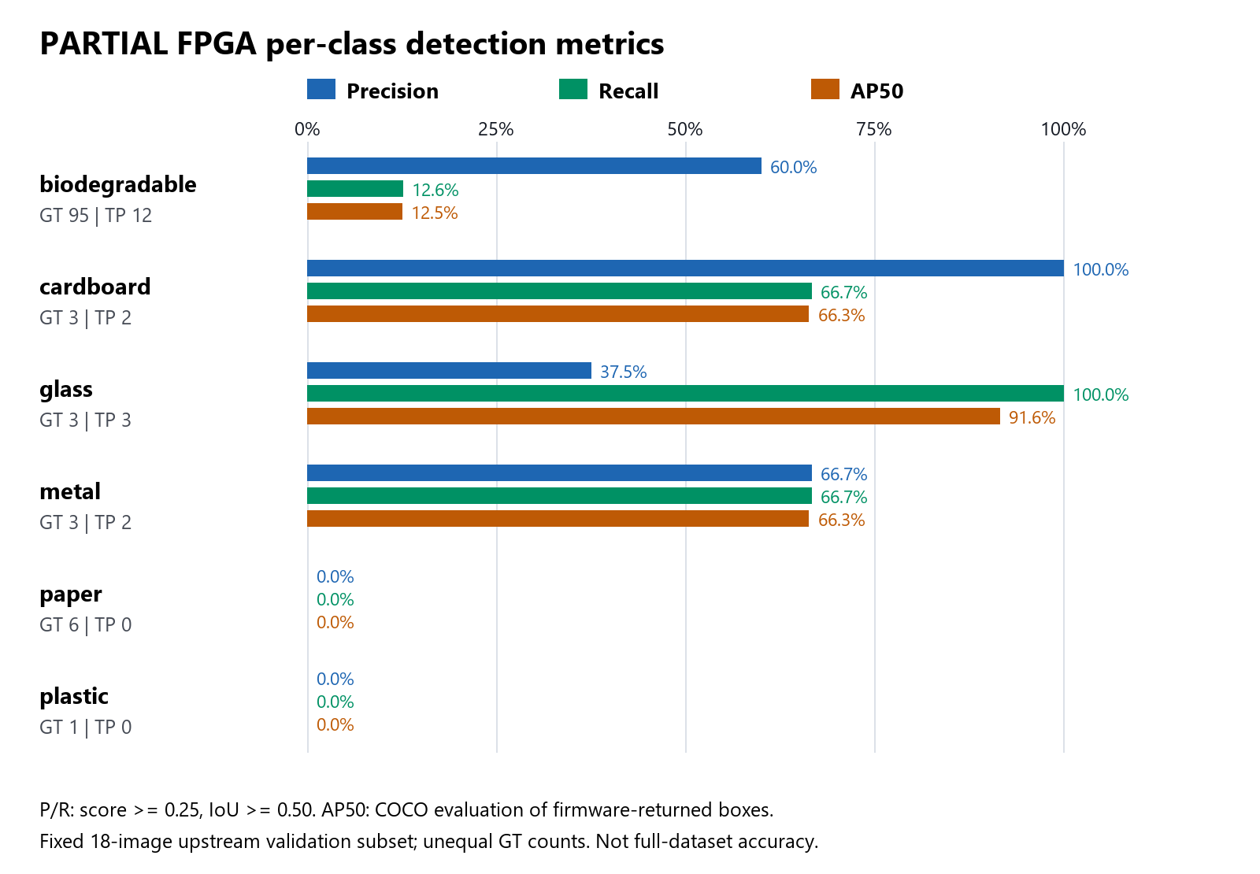
evidence/records/validation_20261104/dataset_metrics_partial/per_class_metrics.png
