licardlu/pangoriscv/evidence/records/platform/counter_led_timing_summary_after_hold_fix.txt

Design Summary : All Constraints Met.

Setup Summary(Slow Corner):
****************************************************************************************************
                                                                          TNS Failing      TNS Total
 Launch Clock           Capture Clock              WNS(ns)     TNS(ns)      Endpoints      Endpoints
----------------------------------------------------------------------------------------------------
 clk                    clk                         16.590       0.000              0             50
====================================================================================================

Hold Summary(Slow Corner):
****************************************************************************************************
                                                                          THS Failing      THS Total
 Launch Clock           Capture Clock              WHS(ns)     THS(ns)      Endpoints      Endpoints
----------------------------------------------------------------------------------------------------
 clk                    clk                          0.334       0.000              0             50
====================================================================================================

Recovery Summary(Slow Corner):
****************************************************************************************************
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
----------------------------------------------------------------------------------------------------
====================================================================================================
