licardlu/pangoriscv/build/replica_pds/run-022/place_route/pango_cpu_top_timing_summary_after_hold_fix.txt

Design Summary : All Constraints Met.

Setup Summary(Slow Corner):
****************************************************************************************************
                                                                          TNS Failing      TNS Total
 Launch Clock           Capture Clock              WNS(ns)     TNS(ns)      Endpoints      Endpoints
----------------------------------------------------------------------------------------------------
 core_clk               core_clk                     0.409       0.000              0          17640
====================================================================================================

Hold Summary(Slow Corner):
****************************************************************************************************
                                                                          THS Failing      THS Total
 Launch Clock           Capture Clock              WHS(ns)     THS(ns)      Endpoints      Endpoints
----------------------------------------------------------------------------------------------------
 core_clk               core_clk                     0.018       0.000              0          17640
====================================================================================================

Recovery Summary(Slow Corner):
****************************************************************************************************
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
----------------------------------------------------------------------------------------------------
====================================================================================================
