licardlu/pangoriscv/evidence/records/optimization/yolo120/yolo120-003/place_route/yolo_camera_top_timing_summary_after_hold_fix.txt

Design Summary : Some Constraints Violated.

Setup Summary(Slow Corner):
****************************************************************************************************
                                                                          TNS Failing      TNS Total
 Launch Clock           Capture Clock              WNS(ns)     TNS(ns)      Endpoints      Endpoints
----------------------------------------------------------------------------------------------------
 sys_clk                sys_clk                     34.592       0.000              0             72
 clk_25M                clk_25M                     37.262       0.000              0             31
 cam1_sccb              cam1_sccb                96868.647       0.000              0            108
 cam2_sccb              cam2_sccb                96869.537       0.000              0            104
 rst_clk                rst_clk                      4.233       0.000              0            427
 ddrphy_sysclk          ddrphy_sysclk                0.647       0.000              0          19764
 phy_dq_sysclk_1        ddrphy_sysclk                1.902       0.000              0            260
 phy_dq_sysclk_0        ddrphy_sysclk                3.603       0.000              0              1
 ddrphy_sysclk          phy_dq_sysclk_0              0.010       0.000              0            196
 ddrphy_sysclk          phy_dq_sysclk_1              0.037       0.000              0            420
 dvp1                   dvp1                         4.693       0.000              0             92
 dvp1                   dvp1_pixel                   0.618       0.000              0            166
 dvp1_pixel             dvp1_pixel                   6.687       0.000              0            929
 ai_clk                 ai_clk                      -2.373    -493.441           1423          55437
 sys_clk|u_pll/u_gpll/CLKOUT1_Inferred
                        sys_clk|u_pll/u_gpll/CLKOUT1_Inferred
                                                    96.473       0.000              0            530
 sys_clk|u_pll/u_gpll/CLKOUT0_Inferred
                        sys_clk|u_pll/u_gpll/CLKOUT0_Inferred
                                                     0.769       0.000              0           1553
====================================================================================================

Hold Summary(Slow Corner):
****************************************************************************************************
                                                                          THS Failing      THS Total
 Launch Clock           Capture Clock              WHS(ns)     THS(ns)      Endpoints      Endpoints
----------------------------------------------------------------------------------------------------
 sys_clk                sys_clk                      0.322       0.000              0             72
 clk_25M                clk_25M                      0.301       0.000              0             31
 cam1_sccb              cam1_sccb                    0.282       0.000              0            108
 cam2_sccb              cam2_sccb                    0.293       0.000              0            104
 rst_clk                rst_clk                      0.347       0.000              0            427
 ddrphy_sysclk          ddrphy_sysclk                0.264       0.000              0          19764
 phy_dq_sysclk_1        ddrphy_sysclk                0.937       0.000              0            260
 phy_dq_sysclk_0        ddrphy_sysclk                1.239       0.000              0              1
 ddrphy_sysclk          phy_dq_sysclk_0              0.673       0.000              0            196
 ddrphy_sysclk          phy_dq_sysclk_1              0.766       0.000              0            420
 dvp1                   dvp1                         0.281       0.000              0             92
 dvp1                   dvp1_pixel                   0.352       0.000              0            166
 dvp1_pixel             dvp1_pixel                   0.285       0.000              0            929
 ai_clk                 ai_clk                       0.152       0.000              0          55437
 sys_clk|u_pll/u_gpll/CLKOUT1_Inferred
                        sys_clk|u_pll/u_gpll/CLKOUT1_Inferred
                                                     0.299       0.000              0            530
 sys_clk|u_pll/u_gpll/CLKOUT0_Inferred
                        sys_clk|u_pll/u_gpll/CLKOUT0_Inferred
                                                     0.348       0.000              0           1553
====================================================================================================

Recovery Summary(Slow Corner):
****************************************************************************************************
                                                                          TNS Failing      TNS Total
 Launch Clock           Capture Clock              WNS(ns)     TNS(ns)      Endpoints      Endpoints
----------------------------------------------------------------------------------------------------
 rst_clk                rst_clk                      4.751       0.000              0             99
 ddrphy_sysclk          ddrphy_sysclk                3.903       0.000              0           3654
 dvp1_pixel             dvp1_pixel                  11.051       0.000              0              4
 ai_clk                 ai_clk                       3.740       0.000              0            602
 sys_clk|u_pll/u_gpll/CLKOUT1_Inferred
                        sys_clk|u_pll/u_gpll/CLKOUT1_Inferred
                                                    97.691       0.000              0              1
 sys_clk|u_pll/u_gpll/CLKOUT0_Inferred
                        sys_clk|u_pll/u_gpll/CLKOUT0_Inferred
                                                    10.529       0.000              0              8
====================================================================================================

Removal Summary(Slow Corner):
****************************************************************************************************
                                                                          THS Failing      THS Total
 Launch Clock           Capture Clock              WHS(ns)     THS(ns)      Endpoints      Endpoints
----------------------------------------------------------------------------------------------------
 rst_clk                rst_clk                      0.397       0.000              0             99
 ddrphy_sysclk          ddrphy_sysclk                0.397       0.000              0           3654
 dvp1_pixel             dvp1_pixel                   0.789       0.000              0              4
 ai_clk                 ai_clk                       0.435       0.000              0            602
 sys_clk|u_pll/u_gpll/CLKOUT1_Inferred
                        sys_clk|u_pll/u_gpll/CLKOUT1_Inferred
                                                     0.909       0.000              0              1
 sys_clk|u_pll/u_gpll/CLKOUT0_Inferred
                        sys_clk|u_pll/u_gpll/CLKOUT0_Inferred
                                                     0.727       0.000              0              8
====================================================================================================

Minimum Pulse Width Summary(Slow Corner):
****************************************************************************************************
                                                                         WPWS Failing     WPWS Total
 Clock                                            WPWS(ns)    TPWS(ns)      Endpoints      Endpoints
----------------------------------------------------------------------------------------------------
====================================================================================================

Setup Summary(Fast Corner):
****************************************************************************************************
                                                                          TNS Failing      TNS Total
 Launch Clock           Capture Clock              WNS(ns)     TNS(ns)      Endpoints      Endpoints
----------------------------------------------------------------------------------------------------
 sys_clk                sys_clk                     35.562       0.000              0             72
 clk_25M                clk_25M                     38.454       0.000              0             31
 cam1_sccb              cam1_sccb                96870.260       0.000              0            108
 cam2_sccb              cam2_sccb                96870.766       0.000              0            104
 rst_clk                rst_clk                      5.516       0.000              0            427
 ddrphy_sysclk          ddrphy_sysclk                3.224       0.000              0          19764
 phy_dq_sysclk_1        ddrphy_sysclk                3.995       0.000              0            260
 phy_dq_sysclk_0        ddrphy_sysclk                4.797       0.000              0              1
 ddrphy_sysclk          phy_dq_sysclk_0              2.710       0.000              0            196
 ddrphy_sysclk          phy_dq_sysclk_1              2.675       0.000              0            420
 dvp1                   dvp1                         5.470       0.000              0             92
 dvp1                   dvp1_pixel                   2.740       0.000              0            166
 dvp1_pixel             dvp1_pixel                   9.033       0.000              0            929
 ai_clk                 ai_clk                       1.573       0.000              0          55437
 sys_clk|u_pll/u_gpll/CLKOUT1_Inferred
                        sys_clk|u_pll/u_gpll/CLKOUT1_Inferred
                                                    97.842       0.000              0            530
 sys_clk|u_pll/u_gpll/CLKOUT0_Inferred
                        sys_clk|u_pll/u_gpll/CLKOUT0_Inferred
                                                     4.979       0.000              0           1553
====================================================================================================

Hold Summary(Fast Corner):
****************************************************************************************************
                                                                          THS Failing      THS Total
 Launch Clock           Capture Clock              WHS(ns)     THS(ns)      Endpoints      Endpoints
----------------------------------------------------------------------------------------------------
 sys_clk                sys_clk                      0.218       0.000              0             72
 clk_25M                clk_25M                      0.201       0.000              0             31
 cam1_sccb              cam1_sccb                    0.255       0.000              0            108
 cam2_sccb              cam2_sccb                    0.251       0.000              0            104
 rst_clk                rst_clk                      0.250       0.000              0            427
 ddrphy_sysclk          ddrphy_sysclk                0.171       0.000              0          19764
 phy_dq_sysclk_1        ddrphy_sysclk                0.355       0.000              0            260
 phy_dq_sysclk_0        ddrphy_sysclk                0.529       0.000              0              1
 ddrphy_sysclk          phy_dq_sysclk_0              0.253       0.000              0            196
 ddrphy_sysclk          phy_dq_sysclk_1              0.323       0.000              0            420
 dvp1                   dvp1                         0.200       0.000              0             92
 dvp1                   dvp1_pixel                   0.204       0.000              0            166
 dvp1_pixel             dvp1_pixel                   0.201       0.000              0            929
 ai_clk                 ai_clk                       0.095       0.000              0          55437
 sys_clk|u_pll/u_gpll/CLKOUT1_Inferred
                        sys_clk|u_pll/u_gpll/CLKOUT1_Inferred
                                                     0.200       0.000              0            530
 sys_clk|u_pll/u_gpll/CLKOUT0_Inferred
                        sys_clk|u_pll/u_gpll/CLKOUT0_Inferred
                                                     0.250       0.000              0           1553
====================================================================================================

Recovery Summary(Fast Corner):
****************************************************************************************************
                                                                          TNS Failing      TNS Total
 Launch Clock           Capture Clock              WNS(ns)     TNS(ns)      Endpoints      Endpoints
----------------------------------------------------------------------------------------------------
 rst_clk                rst_clk                      5.859       0.000              0             99
 ddrphy_sysclk          ddrphy_sysclk                5.376       0.000              0           3654
 dvp1_pixel             dvp1_pixel                  11.937       0.000              0              4
 ai_clk                 ai_clk                       5.407       0.000              0            602
 sys_clk|u_pll/u_gpll/CLKOUT1_Inferred
                        sys_clk|u_pll/u_gpll/CLKOUT1_Inferred
                                                    98.647       0.000              0              1
 sys_clk|u_pll/u_gpll/CLKOUT0_Inferred
                        sys_clk|u_pll/u_gpll/CLKOUT0_Inferred
                                                    11.532       0.000              0              8
====================================================================================================

Removal Summary(Fast Corner):
****************************************************************************************************
                                                                          THS Failing      THS Total
 Launch Clock           Capture Clock              WHS(ns)     THS(ns)      Endpoints      Endpoints
----------------------------------------------------------------------------------------------------
 rst_clk                rst_clk                      0.278       0.000              0             99
 ddrphy_sysclk          ddrphy_sysclk                0.278       0.000              0           3654
 dvp1_pixel             dvp1_pixel                   0.503       0.000              0              4
 ai_clk                 ai_clk                       0.309       0.000              0            602
 sys_clk|u_pll/u_gpll/CLKOUT1_Inferred
                        sys_clk|u_pll/u_gpll/CLKOUT1_Inferred
                                                     0.638       0.000              0              1
 sys_clk|u_pll/u_gpll/CLKOUT0_Inferred
                        sys_clk|u_pll/u_gpll/CLKOUT0_Inferred
                                                     0.463       0.000              0              8
====================================================================================================

Minimum Pulse Width Summary(Fast Corner):
****************************************************************************************************
                                                                         WPWS Failing     WPWS Total
 Clock                                            WPWS(ns)    TPWS(ns)      Endpoints      Endpoints
----------------------------------------------------------------------------------------------------
====================================================================================================
