licardlu/pangoriscv/(notices)

Notices in the files:
project/trash_sorting/stm32_reference/Core/Src/main.c:
Copyright (c) 2026 STMicroelectronics.
All rights reserved.
This software is licensed under terms that can be found in the LICENSE file
